Oleg-mk/JLR-MOST-Amp/tube/6n16b/production/README.md

# Bitline, лампова плата 6Н16Б-В: файли для виробництва

Плата та сама, що під 6Н28Б-В: `jlr_tube_6n28b.kicad_pcb` (у репозиторії JLR-MOST-Amp це `tube/6n28b/`, коміт 1d11305; у папці
Bitline `boards/tube-6N28B/`). Gerber, свердління і CPL збігаються з її пакетом `production`. Якщо плати вже замовлені там, окремо замовляти не треба.
Відрізняються лише деталі і те, в які отвори йдуть виводи ламп.

Згенеровано скриптом `hw/gen/fab.py`: BOM і схема з `tube/6n16b/`, плата з `tube/6n28b/`. Усі 32 виводи звірено з
контактами плати: кожен потрапляє на свою мережу.

## Файли

| Файл | Для чого |
|---|---|
| `Bitline-tube-6N16B-gerbers.zip` | завантажити на сайт виробника: Gerber усіх шарів + свердління |
| `gerbers/` | те саме розпаковане |
| `Bitline-tube-6N16B-BOM.csv` | перелік деталей у колонках JLCPCB для цього варіанта |
| `Bitline-tube-6N16B-CPL.csv` | координати й повороти для монтажу |
| `Bitline-tube-6N16B-assembly-top.pdf`, `-bottom.pdf` | складальні креслення; на нижньому намальовані лампи 6Н28Б-В, виводи ставити за таблицею нижче |
| `Bitline-tube-6N16B-PTH-drl_map.pdf`, `-NPTH-drl_map.pdf` | карти отворів |
| `Bitline-tube-6N16B-schematic.pdf` | схема цього варіанта |

Поля замовлення плати і решта монтажу, зокрема 3 дроти накалу і дріт по верхній доріжці HEAT, такі самі, як у README пакета 6Н28Б-В.

## Чим відрізняються деталі

| Позначення | 6Н28Б-В | 6Н16Б-В |
|---|---|---|
| V1–V4 | 6Н28Б-В | 6Н16Б-В |
| R23, R45 | 4.7k | 4.02k |
| R27, R49 | 820 | 1k |
| R30, R52 | 680 | 1k |
| R31, R53 | 14.3k | 14k |

Решта 156 деталей ті самі. За BOM 168 деталей, 74 рядки.

Нитки беруть 1.6 А замість 1 А, від 12 В плата бере ~1.6 А замість ~1.2 А. F1, U1, L2, FB1 і дроти накалу ті самі.

## Виводи ламп

У 6Н16Б-В 8 виводів, у 6Н28Б-В 9: екрана немає, той самий набір тріодів і нитка. Плата розкладена під 6Н28Б-В, а номери
виводів у ламп різні, тож **номер виводу не дорівнює номеру отвору**. Кожен вивід іде в отвір своєї функції, за таблицею.
Точка на шовкографії біля лампи позначає вивід 1 лампи 6Н28Б-В і тут не діє.

Лампу кладуть, як на креслені: мітка між виводами 8 і 1 догори, кліпса на тому самому місці. Найдовший вивід ~17.5 мм,
а виводи 6Н16Б-В не коротші за 35 мм. Зайву довжину зрізати.

Виводи перехрещуються, це нормально, їх просто треба розвести:
- на V1 і V3 виводи 5 і 1 (обидва аноди);
- на V2 і V4 виводи 3 і 4: сітка ~100 В і нитка. Ця пара найближча, на неї варто вдягти кембрик.

Координати в таблицях у тій самій системі, що й CPL, тільки y додатний.

**V1**

| Вивід 6Н16Б | Що це | Мережа | Отвір на платі (x, y) |
|---|---|---|---|
| 1 | анод тріода 2 | P_L | 114.54, 96.94 |
| 2 | катод тріода 1 | K1_L | 112.00, 90.59 |
| 3 | сітка тріода 1 | G1_L | 117.54, 91.86 |
| 4 | нитка | GND | 117.54, 94.40 |
| 5 | анод тріода 1 | A_L | 112.00, 93.13 |
| 6 | катод тріода 2 | K2_L | 114.54, 99.48 |
| 7 | сітка тріода 2 | G2_L | 112.00, 95.67 |
| 8 | нитка | HEAT | 117.54, 98.21 |

Вільний отвір: 114.54, 89.32 (GND).

**V2**

| Вивід 6Н16Б | Що це | Мережа | Отвір на платі (x, y) |
|---|---|---|---|
| 1 | анод тріода 2 | B+L | 111.96, 76.33 |
| 2 | катод тріода 1 | OH_L | 111.96, 73.79 |
| 3 | сітка тріода 1 | GH_L | 114.50, 75.06 |
| 4 | нитка | HEAT | 114.50, 72.52 |
| 5 | анод тріода 1 | B+L | 114.50, 80.14 |
| 6 | катод тріода 2 | OC_L | 114.50, 82.68 |
| 7 | сітка тріода 2 | GC_L | 111.96, 78.87 |
| 8 | нитка | GND | 117.50, 77.60 |

Вільний отвір: 111.96, 81.41 (GND).

**V3**

| Вивід 6Н16Б | Що це | Мережа | Отвір на платі (x, y) |
|---|---|---|---|
| 1 | анод тріода 2 | P_R | 170.00, 96.94 |
| 2 | катод тріода 1 | K1_R | 167.46, 90.59 |
| 3 | сітка тріода 1 | G1_R | 173.00, 91.86 |
| 4 | нитка | GND | 173.00, 94.40 |
| 5 | анод тріода 1 | A_R | 167.46, 93.13 |
| 6 | катод тріода 2 | K2_R | 170.00, 99.48 |
| 7 | сітка тріода 2 | G2_R | 167.46, 95.67 |
| 8 | нитка | HEAT | 173.00, 98.21 |

Вільний отвір: 170.00, 89.32 (GND).

**V4**

| Вивід 6Н16Б | Що це | Мережа | Отвір на платі (x, y) |
|---|---|---|---|
| 1 | анод тріода 2 | B+R | 167.42, 76.33 |
| 2 | катод тріода 1 | OH_R | 167.42, 73.79 |
| 3 | сітка тріода 1 | GH_R | 169.96, 75.06 |
| 4 | нитка | HEAT | 169.96, 72.52 |
| 5 | анод тріода 1 | B+R | 169.96, 80.14 |
| 6 | катод тріода 2 | OC_R | 169.96, 82.68 |
| 7 | сітка тріода 2 | GC_R | 167.42, 78.87 |
| 8 | нитка | GND | 172.96, 77.60 |

Вільний отвір: 167.42, 81.41 (GND).

## Як перегенерувати

У репозиторії JLR-MOST-Amp, з теки `hw/gen`, Python із KiCad 10:

    C:\Users\geniy\AppData\Local\Programs\KiCad\10.0\bin\python.exe fab.py ..\..\tube\6n16b tube-6N16B ..\..\tube\6n28b\jlr_tube_6n28b.kicad_pcb

Скрипт перезаписує все в `tube/6n16b/production`, крім README. Після будь-якої зміни плати перегенерувати обидва пакети.
