Oleg-mk/JLR-MOST-Amp/tube/6n28b/production/README.md

# Bitline, лампова плата 6Н28Б-В: файли для виробництва

Згенеровано з плати `jlr_tube_6n28b.kicad_pcb` у теці вище (у репозиторії JLR-MOST-Amp це `tube/6n28b/`, коміт 1d11305) скриптом `hw/gen/fab.py`. DRC: 0 помилок по міді, 0 розбіжностей зі схемою, 3 нерозведені:
це дроти накалу, див. «Монтаж». Шовкографія чиста: 0 накладань, 0 написів на контактах. Позначення 12 деталей не вміщаються і сховані: C6, C8–C12, R3,
R4, R8, R9, R11, U1; на складальному кресленні вони є.

Та сама плата йде під 6Н16Б-В: інші лише лампи й 8 резисторів, таблиця виводів у README пакета 6Н16Б-В
(`tube/6n16b/production` у репозиторії, `boards/tube-6N16B/production` у папці Bitline).

## Файли

| Файл | Для чого |
|---|---|
| `Bitline-tube-6N28B-gerbers.zip` | завантажити на сайт виробника: Gerber усіх шарів + свердління |
| `gerbers/` | те саме розпаковане: F/B Cu, Mask, Paste, Silkscreen, Edge.Cuts, `PTH.drl`, `NPTH.drl`, `job.gbrjob` |
| `Bitline-tube-6N28B-BOM.csv` | перелік деталей у колонках JLCPCB: Comment, Designator, Footprint, Quantity, LCSC Part # |
| `Bitline-tube-6N28B-CPL.csv` | координати й повороти для монтажу (Designator, Mid X, Mid Y, Layer, Rotation) |
| `Bitline-tube-6N28B-assembly-top.pdf`, `-bottom.pdf` | складальні креслення; низ у дзеркалі, як дивитися на нижній бік |
| `Bitline-tube-6N28B-PTH-drl_map.pdf`, `-NPTH-drl_map.pdf` | карти отворів |
| `Bitline-tube-6N28B-schematic.pdf` | схема |

## Замовлення плати (поля форми JLCPCB)

- Шари: 2. Розмір: 120.18 × 90.0 мм. Одна плата, без панелі.
- Товщина 1.6 мм, мідь 1 oz (35 мкм).
- Найтонша доріжка 0.2 мм, найменший зазор 0.15 мм. Навколо B+ зазори 1.25 мм, окремо замовляти нічого не треба.
- Переходи 0.6/0.3 мм, 94 шт. Ще 6 відкритих отворів 1.8/1.0 мм під дроти накалу. Найменший отвір 0.3 мм.
- Пазів немає. Отвори без металізації: 4 × 2.7 мм для кріплення (H1–H4) і 4 × 1.6 мм, фіксатори J5 і J6.
- Маска й шовкографія з обох боків, колір на смак.
- Покриття: ENIG. Краще за HASL для U1 (WQFN, найвужчий контакт 0.2 мм), U3 (WSON 2×2 мм) і U2 (MSOP, крок 0.5 мм).
- Номер замовлення: вибрати «Remove order number» або погодитися на місце, яке вибере JLC.

## Монтаж

- За BOM 168 деталей, 78 рядків.
- SMD: 139, усі зверху (F). Знизу SMD немає, вистачить однобічного монтажу.
- Вивідні деталі, 25 шт.:
  - зверху: C20, C29, C31–C33, C35, C36, C42, C44–C46, C48, C49, C60, J2, J5–J8;
  - знизу: J1 і J3 (гнізда під штирі основної плати), V1–V4 (лампи).
- MP1–MP4: кліпси Keystone 3566 для ламп, ставляться знизу. Вони є в BOM, але не в CPL: їхні отвори входять у посадкові
  місця ламп.
- **Дроти накалу, 3 шт.** Дріт Ø0.8 мм з боку фольги (B), у відкриті отвори Ø1.0 мм. Без них розжарення не працює:
  - (116.865, 142.265) – (116.865, 109.271), 33.0 мм;
  - (120.193, 101.498) – (120.244, 71.917), 29.6 мм;
  - (122.022, 101.498) – (175.209, 101.498), 53.2 мм.
- **Верхня доріжка HEAT.** Маска відкрита на всю ширину 0.8 мм, від виводу V2.3 до V4.3. Пряма частина: y 71.35, x від 115.67
  до 168.80, 53.1 мм. Сюди можна пропаяти дріт Ø0.8 мм зверху (F).
- Кріпильні отвори H1–H4 із масою не з'єднані: це стійки M2.5 × 11 до основної плати. Маса лампової приходить через J1 і J3.
- B+ до ~211 В. Після пайки відмити флюс.
- Колонка «LCSC Part #» порожня. Її заповнюють при підборі деталей у JLC, або деталі постачають самі.
- Перевірити, чи є в наявності:
  - U1 LM65625-Q1, U2 LM5022-Q1, U5 TPS1H200A-Q1;
  - Q1 IPD60R600P7, Q2–Q5 DN2540N8;
  - L1 KOHERelec NRSE8040-100M, L2 CENKER CKCSA4020-2.2uH/M, L3 Sumida CDRH129RNP-330MC;
  - F1 Littelfuse 0452003;
  - C35, C36, C48, C49 4.7 мкФ 250 В MKS4;
  - J2 Molex 43045-0221, J5 і J6 Neutrik NC3MAH, J7 і J8 BKL 0101153;
  - MP1–MP4 Keystone 3566, V1–V4 6Н28Б-В.
- Координати в CPL абсолютні, від того самого нуля, що й Gerber. Повороти перевірити в попередньому перегляді JLC,
  особливо в полярних деталях: мікросхеми, електроліти, діоди.

## Як перегенерувати

У репозиторії JLR-MOST-Amp, з теки `hw/gen`, Python із KiCad 10:

    C:\Users\geniy\AppData\Local\Programs\KiCad\10.0\bin\python.exe fab.py ..\..\tube\6n28b tube-6N28B

Скрипт перезаписує все в `tube/6n28b/production`, крім README.
