Oleg-mk/JLR-MOST-Amp/docs/block_diagram.md

# Bitline: блок-схема

Блоки пристрою і зв'язки між ними. Що пристрій робить і навіщо, описано в `concept.md`.

Блок-схема: сигнали й живлення

## Блоки

**FOT.** TE 1-1394640-1: роз'єм MOST 2+0 з приймачем і передавачем. Штекер кільця машини вставляється прямо в нього.
STATUS приймача = 0, коли є світло (DS8104AFP4, рис. 20-2).

**OS8104A**
- Після скидання сам пропускає кільце (All-Bypass). Світло йде далі, поки стартує ESP32.
- Дає такти всьому пристрою: FSY 48 кГц, SCK 64Fs = 3.072 МГц, RMCK 256Fs = 12.288 МГц. Звук іде тільки на тактах
  кільця. Кварц OS8104A — 12.288 МГц.
- Приймачі віддає двома лініями, по 8 байтів за кадр на 64Fs. SX1 — стерео: 16 біт угорі кожного 32-бітового слота.
  SX3 — три моно по 16 біт: слот L — моно 0 і 1, слот R — моно 2. Відлік 16 біт — два канали кільця, старший перший,
  як у usb2most. Основний приймач AUD3 теж стерео 16 біт; 6 каналів має лише його приймач відео, з них іде стерео.
- S/PDIF формує сам на SX0 з потоку, який ESP32 подає на SR1. У потоці: звук 24 біти, біти V, U, C і ознака початку
  блоку. Окремий передавач не потрібен. Даташит DS8104AFP4, розд. 7.4.

**ESP32-WROVER-IE**
- Для ГУ відповідає як штатний підсилювач через OS8104A: I2C, INT і RESET. На Connect прописує маршрути приймачів на
  SX1 і SX3.
- I2S0 приймає SX1 і віддає на SR1 потік для S/PDIF. I2S1 приймає SX3 і віддає DOUT на PCM5122 і HDMI.
- Усі чотири секції I2S ведуть FSY і SCK OS8104A. Вільних I2S не лишається.
- Телефон: Bluetooth A2DP, AirPlay. Звук телефона переводиться програмно на такт кільця.
- Керує по I2C PCM5122. Вмикає REM і світлодіод, тримає живлення, читає перемикач. Про втрату світла дізнається від
  OS8104A, тож вихід STATUS до ESP32 не заведено і сплячий модуль через нього не підживлюється.

**Виходи**
- PCM5122 бере RMCK як SCK, тож його PLL не потрібен. Вихід 2.1 Vrms іде прямо на RCA.
- TOSLINK-передавач підключено прямо до SX0. Коаксіал — через буфер, 0.5 В на 75 Ом.
- I2S на HDMI, розпіновка PS Audio: DATA, BCK, LRCK, MCLK через LVDS-драйвер DS90LV047A, тож кабель не
  навантажує такти PCM5122. Контакт 19 — земля, як у PS Audio; в Audio-gd це вхід автоввімкнення.

**REM.** Ключ +12 В із захистом від замикання. Вмикає ESP32.

**Перемикач і світлодіод.** Перемикач має положення для типів підсилювача й «зчитати номер». Світлодіод підказує
правильний вибір і показує, що номер зчитано.

**Живлення**
- +12 В постійні з роз'єму штатного підсилювача, на вході захист і LC-фільтр.
- У сні живі тільки черговий LDO з мікроамперним споживанням і FOT RX.
- Світло з FOT RX вмикає buck і аналоговий LDO.
- Світло може зникнути й без команди вимкнення, наприклад коли ГУ перезавантажується. Тому ESP32 тримає живлення
  (HOLD), поки вимкне REM і приглушить ЦАП.
- Buck 3.3 В, від 1 А: Espressif радить для ESP32 джерело від 0.5 А.
  - Частота від 2 МГц, тобто вище СВ-діапазону радіо.
  - Працює від ~4 В на вході, тож переживає пуск двигуна, зокрема стоп-старт.
- PCM5122 живиться від окремого LDO.

**Корпус і антена.** Корпус металевий, як у штатного. Гармоніки тактів кільця потрапляють у FM: 8 × 12.288 =
98.304 МГц. Антена Bluetooth і Wi-Fi виноситься назовні через U.FL. Маса з корпусом з'єднана через отвір H2 основної
плати у кута J1/J9. Лампова плата отримує масу через J9, її кріпильні отвори ізольовані.

**Прошивка.** Перша — через USB-C (міст CH340C на UART0). Оновлення — по Wi-Fi. Той самий USB дає журнал: міст
живиться від USB, тож COM-порт не зникає, коли плата засинає й прокидається.

**Кнопка SW2.** На столі без кільця вмикає плату (WAKE_FORCE), далі живлення тримає HOLD. Прошивка через USB без
кільця перезапускає ESP32 і відпускає HOLD, тому на час запису кнопку тримають.

## Відкрите

- Де в потоці на SR1 OS8104A бере ознаку початку блоку S/PDIF. Уточнюється за розд. 7.4 і 12 даташиту при написанні
  прошивки.
