Oleg-mk/JLR-MOST-Amp/docs/board_check/check.md

# Звірка основної плати з даташитами

5 листопада 2026. Дві основні плати (2- і 4-шарова): схема одна. Плата ще не виготовлена, тому це звірка документів, а не
вимірювання.

DRC і `hw/gen/checknet.py` порівнюють плату лише з моїм задумом (`gen/intent.json`), і хибний вивід вони пропускають. Тому
зроблено так:

- знімок плати скриптом прямо з `jlr_most_amp.kicad_pcb`: деталі, пади, кола, без пояснень;
- три помічники окремо, без схем, `intent.json` і документації: живлення, виходи, ESP32 і USB. Звіти без змін:
  `report_power.md`, `report_outputs.md`, `report_host.md`;
- усе, що вони знайшли з наслідками, я перевірив по першоджерелах сам. Частина їхніх сумнівів при цьому знята.

## Проти чого

| Деталі | Еталон |
|---|---|
| U1 OS8104A, J2 оптика | схема usb2most `hardware-v3` (робочий продукт), DS8104AFP4, TE 108-94198 і 114-18997, MOST oPhy App Note |
| U2 | ESP32-WROVER-E/IE v2.4, ESP32 Series v5.3; карта виводів проти `fw/main/board.h` |
| U3, U9 | PCM512x SLAS763, TPS7B81-Q1 |
| U5 | PLT133/T10W Rev.5, PLT133 Rev.2, PLT237/T10WH, Cliff FCR684205T |
| U6, J7 | DS90LV047A SNLS044, SN65LVDS047 SLLS416; розпіновка PS Audio зі сторінок `Bitline-info/web/pages` 029 і 073 |
| U7, U8, U10 | TPS7B81-Q1, LM656x5-Q1, TPS1H200A-Q1 |
| J4-J6 | креслення BKL 0101153 (без легенди), картка Bürklin |
| U4, U11, U12, U13, Q1-Q3, D1-D3 | **лише символи KiCad**: даташитів на ПК немає. Вивід за виводом збігається, решта їхніх параметрів не звірена |

Кожне посадкове місце на платі збігається зі своїм файлом бібліотеки (скрипт), а виводи корпусів порівняні з кресленнями.

## Результат

Неправильних виводів, дзеркальних посадкових місць, перевернутих діодів і перевищених напруг не знайдено на U1-U4, U6-U13,
Q1-Q3, D1-D3, J2, J7, J10, SW1, SW2, D20. Дефекти нижче.

Усі чотири виправлено 5 листопада на слово користувача, пакети перегенеровано. Після правок: DRC 0 помилок на всіх платах,
0 нерозведених (на ламповій ті самі 3 дроти накалу), 0 розбіжностей зі схемою, `checknet` без розбіжностей, ERC ті самі 3
попередження. Порівняння з попереднім комітом показує лише зміни, описані нижче.

### Було необхідно до замовлення

**1. U5 TOSLINK підключено дзеркально.**

- Дивлячись на оптичний порт, зліва направо: Vin, Vcc, GND. Так у трьох документах: PLT133/T10W Rev.5 с. 4 (рисунок «Optical
  Output Side»; нумерований вид там знизу, бо на ньому кінчики виводів, а маркування «PLT T10» на верхній грані видно на фото
  PLT237 с. 1), PLT133 Rev.2 с. 2, Cliff FCR684205T с. 3.
- У посадковому місці порт дивиться на +y, тож пад 1 (x −2.54) зліва, він має бути Vin. На платі: пад 1 GND, пад 3 SPDIF.
- Наслідок за документом: світла немає в жодному стані. Висновок: вхідний захист модуля тримає лінію S/PDIF біля падіння на
  діоді, тож коаксіал теж мертвий, а SX0 перевантажений. ЦАП і HDMI не зачіпає.
- Причина моя: 19 жовтня я прочитав рисунок «Using Method» як вид згори й вирішив, що номери у символі правильні, а у Codex
  переплутані. Правий був Codex. Номери символу (1 GND, 3 Vin) від Rev.2, а номери падів від T10W (1 Vin, 3 GND).
- Правка на обох платах: у символі 1 Vin, 2 Vcc, 3 GND; пад 1 SPDIF, пад 3 GND. U4.2 стояв упритул під падом 3 (0.09 мм), тому U5
  зсунуто на 0.37 мм уздовж краю до J10 (між корпусами 0.95 мм, зони безпеки торкаються). C43 тепер між падами Vcc і GND, (112.68,
  140.13). SPDIF іде через пад 1, униз повз пади 2 і 3 на x 110.41 і над U4.1 у U4.2, на цій діагоналі 0.2 мм із зазорами 0.17 мм.
  Перехід GND біля пада 3 прибрано, U4.1 тепер на масі через C41.2. На 4-шаровій перехід +3V3 зсунуто на 0.02 мм уздовж своєї
  діагоналі. Довжина SPDIF: 40.25 → 39.81 мм (2L), 40.94 → 39.81 мм (4L); переходів на один менше.

**2. Зовнішній контакт RCA, швидше за все, не під'єднаний (J4, J5, J6, а на ламповій J7, J8).**

- Масу подано на товсті ніжки (пад 2), тонкий вивід збоку осі (пад 3) вільний. На кресленні BKL легенди немає, але тонкий
  вивід 9 виходить із кільця зовнішнього контакту, а товсті ніжки з пластикового корпусу. У Bürklin такий самий червоний
  0101154 записаний як 2-полюсний: тобто центр і один зовнішній контакт, ніжки механічні.
- Наслідок, якщо ніжки не з'єднані з контактом: у RCA L, R і коаксіала немає зворотного дроту, хіба що через гвинтову частину й
  корпус.
- Правка: пад 3 на GND (на основних через заливку, без нової міді), на ламповій на RCAS_L і RCAS_R (доріжка 5.1 мм на F.Cu до
  ніжки). Вона безпечна в будь-якому разі. Остаточно це покаже продзвонка зразка.

### Зроблено разом із цим

**3. D2 SM6T24A починає проводити нижче за 24 В.** VRM 20.5 В, VBR 22.8-25.2 В, 33.2 В при 18 А (таблиця ST у копіях, сам PDF ST не
відкривався). Пуск від 24 В дасть до ~1.8 А через D2, тобто ~40 Вт постійно: згорить D2 або F1, і плата замовкне. Усе за D2
витримує більше: U7, U9 45 В (200 мс), U10 42 В (< 400 мс), конденсатори 50 В, U8 65 В. SM6T30A: VRM 25.6 В, VBR 28.5-31.5 В, 41.5 В
при 14.5 А, ті самі пади SMB. Замінено на основних платах і на ламповій; на її +12 В конденсатори 50 В, LM65625 65 В, TPS1H200A 42 В. У LCSC ST SM6T30A: C110904.

**4. Чотири ніжки екрана J2 у неметалізованих отворах.** App Note oPhy с. 8 вимагає припаяти екран до маси, usb2most металізує ці
отвори на GND (свердло 1.0, пад 1.2). У нас 1.1 мм без міді, екран на масі лише через дві передні ніжки. Правка: свердло 1.0, пад 1.3
на GND, на обох основних платах; DRC пройшов без зсуву доріжок.

### Перед заповненням колонки LCSC

- C53 від 16 В (LM656x5 8.2.2.7), C54 10 В X7R (7.3.6).
- C55, C56 мають лишати від 4.7 мкФ при 16 В (8.2.2.6): X7R 50 В у 1210.
- C20, C58, C59: у BOM не вказані напруга й діелектрик; треба 20 мкФ ефективних на виході.
- F1: у BOM немає напруги, узяти з більшою.
- L1 NRSE6028 на падах SRN6028: креслення на ПК немає, звірити за сторінкою LCSC. J1: те саме.

Для Bitline Lite заповнено 6 листопада, усі номери в `hw/gen/lite.py`:

- C53: C14663, 50 В. C54 разом із C14, C22 в одному рядку BOM: YAGEO C106248, 16 В X7R.
- C55, C56: Samsung CL32B106KBJNNNE (C138687), X7R 50 В у 1210.
- C20, C58, C59: Samsung CL31A226KAHNNNE (C12891), 22 мкФ 25 В X5R, три штуки на +3V3.
- F1: Littelfuse 043701.5WR (C151112), 63 В замість 32 В у SART S1206-S-1.5A.
- L1: у даташиті KOHERelec виводи 1.55 × 4.8 мм із проміжком 2.9 мм, вони лягають на наші пади 1.6 × 5.7 мм із проміжком 3.1 мм. J1 звірити лишається.
- Y1: Yajin TXM12.288M0004322FBCDO00T (C362472), CL 12 пФ, ESR 60 Ом, −40…+85 °C. Abracon C596906 не підійшов: ESR 80 Ом і CL 18 пФ при C11, C12 по 18 пФ, а DS8104AFP4 табл. 20-1 рекомендує CL 12–22 пФ і ESR до 40 Ом, де CL рахується послідовно по обох ногах разом із монтажем.

## На першій платі

Це не помилки схеми, а те, що покаже тільки живий зразок.

| Що | Як побачимо | Що тоді |
|---|---|---|
| RS OS8104A піднімається повільно: R12 + C14 дають ~5 мс/В, а DS8104AFP4 с. 167 просить для цифрових входів 8 нс/В; в usb2most конденсатора немає | три спалахи, нестабільний старт | зняти C14, GPIO13 у push-pull у прошивці. Кільце тоді пропускатиме світло лише після старту ESP32 |
| CH340C підживлюється від TXD0 через R63, коли USB немає (до 0.57 мА, USB_3V3 до ~2.7 В) | поміряти USB_3V3, U11.13, U11.14, EN без USB | зняти R62, R63 на платі для машини |
| ROM ESP32 може видавати сигнал на GPIO5, 14, 15 (сторонні таблиці, в Espressif цього немає), а U1.12 і U1.36 у цей час тримають нуль | осцилограф на старті | вирішити за результатом |
| EN не встигає розрядитись при швидкому повторному вмиканні: R20 + C22, 88 мкФ на +3V3 | зняти HOLD, розбудити з різними затримками | вирішити за результатом |
| USB під'єднано раніше за 12 В: C22 заряджений через Q2 (тільки на столі) | USB, потім 12 В, потім SW2 | порядок на столі |
| Струм сну: за документами ~37 мкА (U7 4.5, приймач до 30, U8 0.85, U9 1, U10 0.5) | поміряти | |
| Нагрів L2: даних про втрати CENKER на 2.2 МГц немає | температура під навантаженням | Coilcraft XGL4030 стає на ті самі пади |
| Y1: ESR 60 Ом проти рекомендованих 40 (DS8104AFP4 табл. 20-1); у корпусі 3225 від −40 °C кращого в JLC немає | старт кварца на холоді, запас за резистором послідовно (розд. 20.1) | інша серія кварца |
| F1 043701.5WR у каталозі не позначений як T, плавлення 0.324 А²с; кидок при вмиканні за моєю оцінкою ~0.03 А²с | багато вмикань на 14 В | інший запобіжник |
| GPIO6 PCM5122 вільний: внутрішній підтяжки в нього немає (PCM512x с. 6) | шум, зайвий струм | зробити виходом у прошивці |

## Знято

- Полярність HDMI: помічник сумнівався з пам'яті. Сторінки 029 і 073 дають PS Audio: 1/3 DATA−/+, 4/6 BCK+/−, 7/9 LRCK−/+, 10/12
  MCLK+/−, 19 GND. Плата збігається.
- Карта ESP32: кожен GPIO з `fw/main/board.h` на тому самому колі. Адреси I2C: AD0 = AD1 = 1 дає 0x23, ADR1 = ADR2 = 0 дає 0x4C,
  як у прошивці.
- SW1: клавіші 1, 2, 3, SN на шовкографії йдуть на MODE3, 2, 1, 0, як читає прошивка.
- U1 і J2 проти usb2most: виводи збігаються; відмінності свідомі (адреса I2C, кварц 12.288 проти 18.432 МГц, обидва в таблиці 9-5,
  використані RMCK і SX3).
- R4 15 кОм: TE гарантує потужність при 13.5 кОм, але в usb2most 33k‖33k = 16.5 кОм працює в машинах. Лишаємо.
- U8 з двома падами 7: так у TI, L-подібні кутові виводи.
- GPIO13 розряджає 1 мкФ без резистора: прошивка ставить мінімальну силу виходу, відкритий стік.
- Приймач оптики в сні: дані в темряві низькі (AAR THM с. 24), а вхід RX OS8104A допускає 5 В і без живлення (DS8104AFP4, додаток).
- Паста на теплових падах менша за приклади TI (U8 58 % проти 85 %, U10 64.5 %, U7 і U9 65 %): на наших струмах не критично.
- P1 і P2 у звіті ESP32 (плата вимикається при скиданні без світла, журнал ROM вимкнено) відомі й описані в `docs/block_diagram.md` і
  `docs/firmware.md`.

## Не перевірено

Лампова плата, крім RCA і D2. Механіка J1, J10, SW1, SW2 (немає креслень). Сам PLT133 і BKL живцем: для них є прості перевірки вище.
