Oleg-mk/JLR-MOST-Amp/ref/usb2most/README.md

# usb2most — довідкові файли

Звідки: github.com/smartgauges/usb2most (гілка master), автор SmartGauges, ліцензія GPL-3.0. Завантажено 2026-11-01
з дозволу власника проєкту — для витягу таблиць штатних підсилювачів JLR (профілі, етап 8). Лише читаються як дані,
нічого з них не запускається.

| Файл | Байтів | git blob SHA-1 (як на GitHub) | Що це |
|---|---|---|---|
| `fw/main-v24.bin` | 194 284 | 9476f389ec6a92e057c6a6e51cd694ead21624e1 | прошивка адаптера, остання версія |
| `android/msg.h` | 11 130 | 50d151fb5c8a23037788c56e51a9f397e3b90779 | повідомлення між адаптером і застосунком |
| `LICENSE` | 35 149 | f288702d2fa16d3cdf0035b15a9fcbc552cd88e7 | GNU GPL v3, ліцензія репозиторію |

`fw/main-v24.bin` у git не лежить: це чужий бінарник під GPL, джерела до нього — у репозиторії usb2most. Щоб
`fw/tools/host/golden.py` звірив `fw/main/u2m_golden.h`, файл треба взяти звідти й покласти сюди, у `fw/`; SHA-1 вище
підтверджує, що це той самий. Без нього `run.py` пише, що заголовок не звірено, і йде далі.

Що з них узято й де, — у `docs/stock_amps.md` (джерело U2M-FW) і в коментарях профілів у `fw/main/amp.c`.

`msg.h` перелічує типи підсилювачів, якими адаптер уміє бути: `lr2_hi`, `lr2_premium`, `aud3_8`, `aud3_12`,
`aud3_16`, `lr3_hi`, `lr3_premium`; машини — від Freelander 2 2007MY до XJ 2010MY.
