Oleg-mk/JLR-MOST-Amp/docs/concept.md

# Bitline: концепція

Пристрій стає на місце штатного підсилювача JLR MOST25 будь-якого покоління: дорестайлових Hi-Line і Premium,
AUD3-8, -12 і -16. Тип обирає користувач. Пристрій бере звук з кільця, застосовує до цифрового сигналу штатні команди
регулювання без погіршення якості й віддає звук на зовнішні пристрої. Друге джерело — телефон.

## Входи

- **Кільце MOST.** OS8104A веде кільце й канал керування. Канали, які ГУ під'єднує до підсилювача, він віддає як I2S
  разом із тактами FSY, SCK і RMCK.
- **Телефон.**
  - По Bluetooth A2DP — будь-який телефон і будь-який застосунок.
  - По Wi-Fi: AirPlay без втрат з iPhone.
  - Одночасно грає одне джерело.

## Обробка

Модуль ESP32-WROVER-IE: класичний Bluetooth, Wi-Fi, PSRAM під буфер AirPlay, роз'єм зовнішньої антени. Він робить
таке:

- **Для ГУ видає себе за обраний штатний підсилювач:** його FBlock, інстанцію, список функцій і серійний номер. Тип
  задає перемикач.
- **Зводить у стерео** всі приймачі, які ГУ під'єднує до підсилювача, як штатний.
- **Застосовує команди ГУ:** рівні й гучність, Bass, Treble, Balance, Mute з плавністю з MuteParameters.
  Гучність ГУ працює й на зовнішньому підсилювачі.
- **Не псує сигнал.**
  - Рахує в 32-бітовій арифметиці.
  - На нейтральних налаштуваннях пропускає звук біт у біт.
  - Вихід 24-бітовий, тож приглушення 16-бітового джерела аж до −48 дБ не втрачає жодного біта.
- **Музика з телефона займає місце музики ГУ.** На ГУ вибране тихе джерело, наприклад AUX.
  - Кожну команду, яку ГУ дає своїй музиці (рівень, Mute, плавність), пристрій застосовує й до телефона.
    Навігація, дзвінок, парктронік і службові сигнали приглушують музику з телефона так само, як штатну.
  - Звук телефона переводиться програмно на такт кільця. Тракт з кільця лишається біт у біт.

## Серійний номер

У машинах з увімкненим захисним кодуванням ГУ перевіряє серійний номер підсилювача. З чужим номером звук зникає за
20–40 с або при наступній зміні джерела. Тому пристрій віддає ГУ номер штатного підсилювача цієї машини.

1. Перемикач ставлять у положення «зчитати номер».
2. Пристрій вмикають у кільце через оптичний перехідник-петлю між штекером машини й штатним підсилювачем і вмикають
   аудіосистему.
3. Пристрій зчитує номер штатного підсилювача й зберігає у своїй пам'яті. Що номер зчитано, показує світлодіод.
4. Штатний підсилювач знімають, перемикач ставлять на тип.

Нових деталей не треба. У машинах без захисту цей крок пропускають.

## Такти

Усі виходи працюють на тактах кільця від OS8104A. Власних звукових генераторів немає.

## Виходи

Усі виходи беруть той самий оброблений потік.

- **Лінійний вихід:** PCM5122, 2.1 Vrms відносно землі, прямо з її виводів, без операційного підсилювача.
- **PCM-потік:** I2S з MCLK на HDMI для зовнішнього ЦАП: LVDS, розпіновка PS Audio.
- **S/PDIF:** формує сам OS8104A з обробленого потоку, далі TOSLINK і коаксіал 0.5 В на 75 Ом.

## REM

+12 В через ключ із захистом від замикання. Сигнал іде не від самого світла в кільці, бо кільце може світитися й без
звуку.
- Вмикається, коли ГУ під'єднала звук до підсилювача: після старту ЦАП, до зняття глушіння.
- Вимикається першим, ще до вимкнення ЦАП.

## Живлення

+12 В з роз'єму штатного підсилювача. У сні живий тільки приймач FOT, решта прокидається від світла.

## Чого пристрій не робить

- Фейдер не працює: усі виходи стерео.
- Треки з телефона перемикаються на телефоні: кнопки керма йдуть до ГУ, а не до підсилювача.
- Дзвінки йдуть через штатний Bluetooth машини. До пристрою телефон підключається тільки для музики.
- З Android пристрій по Wi-Fi не грає: увесь звук з Android іде по Bluetooth. Spotify Connect прибрано 2026-10-31:
  - відкрита реалізація (cspot) робить прошивку GPL-3.0 і тягне бібліотеку bell, що не має ліцензії;
  - з березня 2026 вона вимагає від кожного власника свого застосунку на developer.spotify.com.

## Відкрите

- Яким запитом ГУ читає серійний номер підсилювача.
- Решта відкритих питань щодо штатних підсилювачів — у `stock_amps.md`, розд. 8. На схему вони не впливають, бо
  вирішуються в прошивці.
