Oleg-mk/JLR-MOST-Amp/docs/firmware.md

# Bitline: план прошивки

Що робить пристрій, описано в `concept.md`, з'єднання блоків — у `block_diagram.md`, що відомо про штатні підсилювачі —
у `stock_amps.md`. Тут — як прошивка ESP32 це виконує і в якому порядку пишеться.

## Основа

- ESP-IDF v5.5.6, мова C, проєкт у теці `fw/`. Модуль ESP32-WROVER-IE-N16R8: 16 МБ flash, 8 МБ PSRAM, з яких ESP32
  відображає 4 МБ; решта доступна лише через himem. Буфери телефона й перетворювача частоти рахуємо на 4 МБ.
- Після зміни `sdkconfig.defaults` треба видалити `fw/sdkconfig` і зібрати знову: наявний sdkconfig має пріоритет.
- Ядро 1 — звук: I2S і обробка, одна задача з найвищим пріоритетом (20). Bluetooth і Wi-Fi ESP-IDF ставить на ядро 0.
  Задачі MOST (переривання OS8104A, емуляція, її журнал, живлення) до ядра не прив'язані, звук витісняє їх пріоритетом.
  Переривання OS8104A (8) і емуляція (7) стоять вище за задачі AirPlay (5, 6): відповіді ГУ перед пакетами телефона.
- Сторожовий таймер задач перезапускає пристрій (`CONFIG_ESP_TASK_WDT_PANIC=y`). Він стежить за задачами звуку,
  переривання OS8104A, емуляції й живлення; такий перезапуск іде в лічильник аварій (розд. «Сон»). У QEMU таймер лише
  пише в журнал.
- Перша прошивка — через USB-C J10 (CH340C, перезапуск у завантажувач від DTR/RTS); на столі без кільця на час запису
  тримати SW2. Оновлення — по Wi-Fi (OTA).
- Сторонні бібліотеки: безкоштовні відкриті беремо, перевіривши ліцензію кожної; платні не беремо, а пишемо своє.
- Bluetooth A2DP — кодек SBC, як дає ESP-IDF.

## Виводи ESP32

| Сигнал | GPIO | Куди |
|---|---|---|
| BCK, LRCK | IO15, IO4 | вхід: такти кільця від OS8104A для обох I2S |
| MOST_SX1 → I2S0 RX | IO14 | приймачі з кільця |
| SPDIF_SRC ← I2S0 TX | IO12 | потік на SR1 OS8104A, з нього S/PDIF |
| MOST_SX3 → I2S1 RX | IO5 | приймачі з кільця |
| DOUT ← I2S1 TX | IO2 | PCM5122 і HDMI |
| I2C0 SDA, SCL | IO26, IO27 | OS8104A, адреса 0x23 (0x46/0x47) |
| MOST_INT, MOST_RST | IO25, IO13 | переривання й скидання OS8104A |
| I2C1 SDA, SCL | IO21, IO19 | PCM5122, адреса 0x4C |
| HOLD, REM_EN | IO33, IO32 | утримання живлення, REM |
| MODE0…MODE3 | IO36, IO39, IO34, IO35 | перемикач: MODE0 — «зчитати номер», MODE1–3 — тип |
| LED | IO22 | світлодіод |

Сила виходів: 0..1 для DOUT і SPDIF_SRC, 0 для решти — повільніші фронти, менше випромінювання.

## Модулі

- **Живлення.** На старті одразу HOLD = 1. Сон — за командою ShutDown від майстра мережі або коли світло зникло й не
  повернулося: плавне глушіння, REM вимк., глушіння ЦАП, HOLD = 0. Програмне перезавантаження (паніка, abort) скидає
  лише процесор, тож HOLD лишається 1 і без світла цикл аварій тримав би живлення вічно: лічильник аварій поспіль у
  RTC-пам'яті (`esp_reset_reason()`), після N паніки HOLD не вмикати. Апаратне скидання (EN, brown-out, RTC WDT)
  відпускає вивід, R51 тягне HOLD до нуля, живлення без світла вимикається саме. Світло ESP32 бачить лише через I2C:
  якщо OS8104A у кільці машини 30 с не відповідає, стан світла невідомий, і йде та сама послідовність сну, а через
  20 с — перезапуск зі скиданням мікросхеми (розд. «Сон»).
- **OS8104A.** Скидання, вихід з All-Bypass, коли ESP32 готовий. Прийом і передача повідомлень керування. Логічна
  адреса вузла й FBlock — за профілем. На Connect — маршрути приймачів на SX1 і SX3. Після скидання FSY і SCK у нього
  входи: bSDC1.IO = 1 треба записати після переривання ввімкнення, але до захоплення кільця (DS8104AFP4, розд. 7.2);
  до того ESP32 тримає BCK і LRCK на своїх підтяжках до землі.
- **Емуляція підсилювача.** Профіль на тип: FBlock, інстанція, адреса вузла, список функцій, серійний номер. Відповіді
  на FBlockIDs, FktIDs, Notification; виконання Connect, DisConnect, Mute, MuteParameters, SpeakerLevel, Bass,
  Treble, Balance і власних 0xE0x.
- **Звуковий рушій.** Обидва I2S — підлеглі тактам кільця, слоти по 32 біти. Розбір кадру за форматом кожного
  приймача, зведення приймача 1 (стерео) і моно-приймачів 2–4, рівні, глушіння з плавністю, тембр, баланс.
  32-бітова арифметика; на нейтральних налаштуваннях звук проходить біт у біт; вихід 24 біти.
- **S/PDIF.** Потік на SR1 з бітами V, U, C і ознакою початку блоку.
- **ЦАП.** PCM5122: SCK = RMCK 12.288 МГц, PLL вимкнений, глушіння регістром.
- **Телефон.** A2DP і AirPlay (RAOP, ALAC без втрат); грає одне джерело. Звук телефона переводиться
  на такт кільця програмним перетворювачем частоти, темп якого підлаштовується за заповненням буфера. Цей звук
  займає місце приймача 1 і проходить ті самі рівні, глушіння й приглушення, що й музика ГУ.
- **Перемикач і світлодіод.** Тип, «зчитати номер», підказки, «номер зчитано». Світлодіод: короткий спалах раз на
  секунду — працює; швидке блимання — читає номер; горить — номер зчитано; два спалахи на секунду — не зчитано; три
  спалахи поспіль — OS8104A не стартував (цей код перекриває решту).
- **Пам'ять і журнал.** NVS — налаштування: мережа телефона, пароль точки налаштування, спарювання Bluetooth.
  Зчитаний штатний підсилювач із серійним номером — в окремому розділі NVS `amp` (`partitions.csv`): стирання
  основного NVS, коли його формат застарів, його не чіпає. Журнал — у UART.

## Драйвер OS8104A

`fw/main/os8104.c`, за DS8104AFP4. Консоль: `most reset | master | slave [вузол група] | st | loop | rd | wr`,
повідомлення — розд. «Журнал кільця й емуляція». Коли вузол — підлеглий у кільці машини, `most reset`, `master`,
`loop` і `check on` без слова `force` у кінці відмовляють: вони вибили б кільце машини. Після `most reset`, `master`,
`slave` і `check off` емуляція забуває маршрути приймачів, канали джерела й підписки, як їх забув чип.

- I2C 200 кГц: вище OS8104A може розтягувати SCL на кожному байті (розд. 18.5.7).
- Скидання: RS у нулі 5 мс. Після відпускання C14 заряджається через R12, і RS піднімається приблизно за 12 мс. Далі
  ESP32 чекає спаду INT (переривання ввімкнення) до 100 мс, одразу пише bSDC1.IO, читає версію (C4h–C6h) і знімає
  переривання (bMSGC.RERR). Вузол лишається в All-Bypass.
- Ведучий на стенді (розд. 16.2): bXCR = E2h з обходом Legacy. З обходом Enhanced ведучий до захоплення лише
  пропускав би RX на TX, і петля не запустилася б. Frequency Regulator вимкнений, бо він для підлеглих.
  bCM1 = 12h: PLL від кварцу 12.288 МГц, RMCK 12.288 МГц для PCM5122. bXSR2.DFE увімкнений, bSDC1 = D7h (режим 5:
  порти 1–3 — I2S, порт 0 — S/PDIF; FSY і SCK — виходи; SR1/SX1 не прозорі), bSDC3 = 0, bXSR = 50h, bSBC = 8 квадлетів.
- Підлеглий у машині (розд. 16.3): bCM1 = 12h, Frequency Regulator тримає такт від кварцу, поки немає RX; після
  захоплення кварц регулятора вимикає сам чип (bCM3.ACD, розд. 9.5). bXCR = 42h з обходом Enhanced замість 62h з
  даташита: без захоплення RX іде на TX, а за табл. 6-10 це той самий активний вузол. Перевірка — етап 2.
- Втрата захоплення, що триває, маскується (bXSR.MXL, розд. 6.2.4) і знову вмикається після захоплення, інакше
  переривання ERR ішли б без кінця. Світло (bCM2) задача живлення читає кожні 100 мс: події INT бачать його лише на
  фронтах, бо ALC приходить зі зміною розміру чи затримки кільця, а не з кожним захопленням (розд. 6.2.8).
- Майстер на стенді після захоплення знімає всі виділення каналів (De-Allocate All): таблиця починається чистою.
- Таблиця маршрутів (MRT) при SCK 64Fs: байт k входу SRn — MRA 40h + 8k + n, байт k виходу SXn — комірка 47h + 8k − n.
  Байти 0–3 — лівий канал, 4–7 — правий. Петля стенда (`most loop`): SR1 → байти кадру 0–7 → RX → SX1 і SX3.
- S/PDIF на SX0 (розд. 7.4.5, рис. 7-7, 7-8). На кожен підкадр SX0 бере три байти 24-бітного звуку — молодший, середній,
  старший — і байт з V, U, C, P у бітах 0–3; у бітах 4–7 цього байта лежить наступна преамбула. Маршрут однаковий для
  ведучого й підлеглого: старші 24 біти кожного 32-бітового слота SR1 → SX0 (байти SR1 2, 1, 0 → SX0 0, 1, 2 і 6, 5,
  4 → 4, 5, 6). Байти V U C — з MRA F8h, тобто 000. Парність і преамбули OS8104A додає сам, усі біти C — нулі.
- Комірки SX0 узяті за розд. 12 (47h + 8k). На рис. 7-8 вони підписані так само, як адреси SR0 (40h + 8k). Якщо на стенді
  S/PDIF мовчатиме, перевірити варіант з рис. 7-8.

## Звук на стенді

`fw/main/audio.c`, `fw/main/pcm5122.c`. Консоль: `tone [Гц] [дБFS] | tone off`, `i2s`, `dac | dac mute 1|0`.

- I2S0 і I2S1 — підлеглі на спільних BCK (IO15) і LRCK (IO4), слоти по 32 біти, формат Philips. Власний такт
  контролера — 16×BCK (мінімум 8): тоді вихід TX іде за фронтом BCK приблизно через 20 нс.
- Одна задача на ядрі 1 читає обидва RX (SX1, SX3) і пише обидва TX: DOUT (PCM5122 і HDMI) і SR1 (розд. «Звук з
  кільця (етап 4)», «Рушій»). Тестовий тон іде в обидва TX, піки RX рахуються.
- Не встигла задача — TX шле нулі, а не повторює старий блок DMA (`auto_clear_after_cb`). Переривання I2S працює й
  під час запису flash (NVS, OTA): `CONFIG_I2S_ISR_IRAM_SAFE`. Сама задача звуку на час стирання сектора стоїть
  разом із кешем flash на обох ядрах (десятки мс, а в DMA 16 мс), тож оновлення спершу закриває вихідний гейт
  (`dsp_gate`, розд. «Оновлення по Wi-Fi»); запис у NVS стирає сторінку лише тоді, коли вона заповнилась.
- PCM5122: PLL вимкнений, бо SCK = 256Fs на 48 кГц ЦАП бере напряму (SLAS763C, табл. 32). I2S 32 біти, гучність 0 дБ,
  рівні рахує ESP32. Глушіння — регістром 3 з плавним спадом, XSMT тримає R31.
- Перевірка «біт у біт» (`check on [ring|direct] | off`, `check`). У SR1 іде 32-бітовий LFSR (x^32 + x^22 + x^2 + x + 1):
  лівий канал s, правий ~s, один крок на кадр. Повертається він із SX1 і SX3 через кільце (світло з TX на RX) або
  всередині OS8104A. Кожен прийнятий кадр має бути наступним кроком попереднього, тож затримку шукати не треба. Збитий
  біт, втрачений кадр і переставлені канали — це помилки. Рахунок починається після двох кадрів підряд, що відповідають
  послідовності. На час перевірки DOUT мовчить, а S/PDIF заглушений: послідовність звучить як шум на повну гучність.

## Журнал кільця й емуляція (етапи 2–3)

`fw/main/most.c`, `amp.c`, `selftest.c`. Консоль: `most log 1|0`, `most send DST FB INST FKT OP [байти]`,
`amp [st] | on | off | test`.

- **Буфери OS8104A** (DS8104AFP4, розд. 13). Прийом mRCMB A0h–B3h: bRTYP, адреса відправника, 17 байтів. Передача
  mXCMB C0h–D4h: пріоритет, тип, адреса цілі, 17 байтів, далі bMSGC.STX і очікування MTX з bXTS. Прийнятий буфер
  звільняється RBE одразу після читання.
- **Поля.** FBlockID, InstID, FktID (12 бітів) з OPType (4), TelID (4) з TelLen (4), 12 байтів даних. Довгі
  повідомлення йдуть сегментами з лічильником у першому байті даних: TelID 1, 2, 3. Так їх пакують JLR-HU і SocketMost.
  Сегменти збираються окремо для кожного відправника, до 4 водночас. Запит, який не вдалося зібрати, отримує Error
  [0Ch, код] (MOST 2.5, 2.3.11.1.1): 01 — немає першого сегмента, 02 — задовгий, 03 — сегмент не за лічильником,
  04 — забагато відправників водночас, 07 — новий початок до кінця попереднього.
- **Журнал (етап 2).** Кожне прийняте й надіслане повідомлення — один рядок у UART. Рядки йдуть через чергу на 64 рядки
  (PSRAM) у задачу з найнижчим пріоритетом: UART на 115200 бод — ~6 мс на рядок, а відповіді ГУ чекати не можуть.
  Переповнена черга губить рядки й пише, скільки загубила. Емуляція стартує сама разом з кільцем (розд. «Звук з кільця
  (етап 4)», «Автостарт»); `amp off` її вимикає, а журнал лишається.
- **Емуляція (етап 3, каркас).** Кожна функція звірена з кодом usb2most: `docs/usb2most/check_amp.md`. Джерела, у такому
  порядку:
  - байти на шині — код usb2most, який працює в машинах як ці підсилювачі (`docs/usb2most/decode_*.md`);
  - поведінка вузла в мережі JLR — робочий вузол JLR-HU (`FBlocks.ts`, `common.ts`, `findings/startUpFlow.json`);
  - правила відповідей, яких usb2most не показує, — специфікація MOST 2.5;
  - формати функцій — каталоги FBlock AudioAmplifier 2V4-3 і GeneralFBlock 2.5.1 (stock_amps.md, розд. 3).

  Що вузол відповідає:
  - NetBlock FBlockIDs 000h Get від майстра → Status з усіма FBlock профілю (розд. «Профілі») тому, хто питав, з його
    FBlock, InstID і FktID. DeviceInfo 001h → `FF FF 00`, NodePositionAddress 002h → `40`, позиція, NodeAddress 003h,
    GroupAddress 004h → `03 22`, ShutDown Query → Result `[00]`.
  - FktIDs 000h Get → список функцій за MOST 2.5, розд. 2.3.9: FktID, на яких біт наявності міняється (розд.
    «Профілі», «Виправлено в етапі 3»). 19 функцій Premium займають 32 байти, три сегменти. Де список usb2most не такий,
    як виходить за правилом, віддаються його байти: Hi-Line 22.02 і Diagnosis, Diagnosis AUD3. Зчитаний підсилювач теж
    відповідає своїм списком як є.
  - Notification 001h Set [керування, адреса, до 4 FktID]. Керування: 0 — усі функції, 1 — перелічені, 2 — зняти все,
    3 — зняти перелічені.
    - Підписаний одразу отримує поточні значення, де вони є.
    - Функції, на які підписатися не можна, проходять мовчки: ГУ на старті підписується і на функції поза списком
      (0C01h, 0353h), а usb2most на них не відповідає. Таблиця підписок повна — на «усі функції» Error [20h, 21h]
      (MOST 2.5, с. 104).
    - AUD3: на D00h приходить Status `01 00 02 00 06 00 01`; на E10h у Diagnosis — порожній Status.
    - «Зняти перелічені» з того, хто підписаний на всі функції, лишає йому окремі підписки на решту властивостей
      (с. 103).
    - Get [FktID] → Status [FktID, адреси підписників].
    - Сповіщення, яке не дійшло, бо цілі немає (bXTS 00h), викреслює ціль з таблиці.
    - Майстер оголосив мережу NotOK (NetworkMaster A00h Status [00h]) — таблиця стирається, а підписка в шлюзі
      вважається втраченою й повторюється після наступного OK (с. 105).
  - NotificationCheck 002h Get [адреса] → Status [адреса, функції, на які вона тут підписана] (GFB 2.5, 2.1.3).
  - Connect 111h StartResult [приймач, SrcDelay, канали] → Result [приймач]; DisConnect так само. Канали від 0 до 59, у
    порядку байтів відліку, не обов'язково за зростанням: usb2most сам дає підсилювачу `c+1 c c+5 c+4`. Усі FFh означають
    «без каналів». На приймач, якого немає, теж Result: так usb2most.
  - Mute 113h [приймач, стан]: приймач 0 — усі, біт 0 — глушіння. Сповіщення — Status [приймач, стан] на кожен
    приймач, що змінився, і на Mute [0, …] теж (GFB 2.5, 2.1.29).
  - MuteParameters 466h [рядок, час глушіння, час зняття, форма глушіння, форма зняття]. Часи в мс, по 2 байти. Рядок 0 —
    усі рядки; рядок понад 4 або інша довжина проходять мовчки.
  - SpeakerLevel 46Dh [рядок, динамік, рівні в дБ]. Байт 0 — рядок, 1..4, байт 1 — динамік, 0 означає всі. `[r, 0, рівні]`
    задає рядок r: 5 рівнів у дорестайлу, 7 в AUD3. `[0, 0, рівні]` задає всі рядки підряд, 4 x 5 або 4 x 7. На Set відповіді
    немає. Get `[r, 0]` → `[00 00, рядок]`, номер рядка не повертається; Get `[0, 0]` → `[00 00, усі рядки]`; інший Pos —
    порожній Status; інша довжина — Error `06`. Рядок, який ГУ не задавала, має −99 дБ у відповіді, а на звук не діє.
    Рівень понад 0 дБ приймається, на виході він 0 дБ. Динаміки за номерами: 1 передній лівий, 2 центр, 3 передній правий,
    4 задній лівий, 5 задній правий, 6 і 7 стійки (розд. «Обробка звуку», «Баланс»).
  - Рядки й приймачі. У дорестайлу рядок r — це приймач r. В AUD3 інакше: рядок 1 — приймачі 1 і 2 (основний, відео),
    2 — приймач 4 (дзвінок), 3 — приймач 7 (навігація, висновок), 4 — приймач 6 (радар).
  - Bass 202h, Treble 203h — один байт зі знаком. Increment і Decrement на NSteps відповідають Status і зупиняються
    на ±6.
  - Масиви 427h, 430h, 431h, 441h, 461h зберігаються як прийшли, окремо для кожного FBlock і значення Pos (перших
    двох байтів), до 128 записів.
  - E04h, E05h, E07h, E08h — власні функції JLR, зі стартовими значеннями usb2most. Set лише повної довжини, інше проходить
    мовчки; E08h ще й половинами `[1|2, 0, 7 байтів]`, а решта — Error `06`. Get `[0, 0]` віддає таблицю, перші два байти в
    нулях; інший Pos — порожній Status; інша довжина — Error `06`. AUD3: E05h на 3 байти `[x, x, режим]` → D00h Status
    `режим 00 02 00 06 00 01`, де 5 і 7 стають 4, а 0Dh — 2.
  - Приймаються мовчки, хоч їх немає у списку: E09h на основному FBlock дорестайлу, E53h на AUD3.
  - Помилки — за MOST 2.5, табл. 2-5. У 04h іде OPType, у 06h і 07h — номер параметра та його значення. Невідомий FBlock і
    функція поза списком — Error. AudioAmplifier з чужою InstID — мовчки: usb2most так само, а його старт шле 22.20 на AUD3.
    Diagnosis і HeadphoneAmplifier приймаються під будь-якою InstID: той самий старт питає 06.0A.
  - На групові й широкомовні повідомлення помилкою не відповідаємо. На Status, Result і Error вузол не відповідає
    ніколи.
  - Коли майстер оголосив мережу готовою (NetworkMaster A00h Status [01h]), підсилювач звертається до F5.01 того, хто це
    надіслав: дорестайл — Notification 303h; AUD3 — 305h Get `26 28 24`, Notification 200h, Notification 303h, окремими
    повідомленнями. Відповіді лише в журналі.
- **Ще не відомо, покаже перша плата в кільці** (`docs/usb2most/check_amp.md`, кінець):
  - що шлюз шле у 303h;
  - власний діапазон Bass і Treble підсилювача;
  - що означають поля E04h–E08h;
  - рядок 3 AUD3.

  Маршрути каналів Connect на SX1 і SX3 — розд. «Звук з кільця (етап 4)».
- **Самоперевірка** (`amp test` після `amp off`, бо тест скидає емуляцію; або при старті у варіанті для QEMU, розд.
  «Телефон»). Вона прокручує старт мережі з `startUpFlow.json`, адресований підсилювачу, і звіряє кожну відповідь байт у
  байт. Еталон — байти самого usb2most: `fw/tools/host/golden.py` читає їх із `main-v24.bin` у `fw/main/u2m_golden.h`, а
  `run.py` щоразу звіряє заголовок із бінарником. Перевіряються:
  - буфери й сегменти;
  - приклад FktIDs зі специфікації, списки функцій усіх FBlock трьох профілів, розбір списків не за зростанням;
  - NetBlock, підписка, Notification;
  - Mute, MuteParameters, SpeakerLevel, E04h–E08h, Bass, Connect, DisConnect;
  - рядки SpeakerLevel: рядок телефона чи парктроніка не чіпає музику; повідомлення гучності точно такі, як їх шле usb2most;
  - D19h, D22h;
  - весь старт ГУ з драйвера usb2most (метод +40): Premium, Hi-Line, AUD3 — відповіді там, де вони в нього є, і тиша на решту;
  - помилки з ErrorInfo і мовчання на групові й широкомовні повідомлення;
  - NotOK і повторна підписка, NotificationCheck, «зняти перелічені» після «усі функції», сповіщення Mute по
    приймачах;
  - сегменти двох відправників упереміш і Segmentation Error.

  `fw/tools/host/mutate.py` по черзі повертає старі дефекти в копію `amp.c` і показує, що самоперевірка їх ловить.

## Телефон: A2DP і перетворення частоти (етап 6, перша частина)

`fw/main/a2dp.c`, `phone.c`, `src.c`. Консоль: `phone` (стан потоку), `phone test` (самоперевірка).

- **A2DP.** Bluetooth Classic, приймач A2DP, SBC декодує сам стек ESP-IDF. Пристрій видно як «Bitline»;
  спарювання Secure Simple Pairing без екрана й кнопок, тому новим телефонам пристрій видно лише в перші 10 хв після
  старту і поки жоден телефон не під'єднаний; спарений телефон підключається будь-коли. Частоту потоку (44.1 або
  48 кГц) дає конфігурація кодека. Ще не запускався: потрібна плата.
- **Буфер.** 8192 кадри 16-бітового стерео у внутрішній пам'яті, 186 мс на 44.1 кГц. A2DP пише в нього пачками,
  звуковий рушій забирає кадри на такті кільця. Буфер береться з купи: зі стеком Bluetooth у статичних даних DRAM
  лишається 26 КБ (прошивка 901 КБ). Коли буфер спорожнів (обрив потоку), останній кадр сходить до нуля за 2 мс, а не
  обривається стрибком.
- **Перетворення частоти.** Інтерполяція windowed-sinc на 40 відліків із вікном Кайзера. Коефіцієнти задані кубічними
  шматками по 1/32 кадру, тож відношення частот може мінятися від кадру до кадру. Смуга до 20 кГц рівна. Дзеркала й
  накладення, що падають нижче 20 кГц, придушені приблизно на 100 дБ; ті, що падають вище, проходять частково. Запас
  −3 дБ на виході: інтерполяція може перевищити повну шкалу запису.
- **Підлаштування темпу.** Ціль — 100 мс у буфері. Заповнення двічі згладжується з постійною 2 с. Далі
  ПІ-регулятор на 0.01 Гц, критично задемпфований, поправка обмежена ±1000 ppm.
- **Виміряно в QEMU (самоперевірка):**
  - перетворення 44.1 → 48 кГц і 48 кГц +300 ppm → 48 кГц на 1, 10 і 15 кГц: SNR 96.5–97.6 дБ, тобто на межі
    самого 16-бітового входу (~97 дБ);
  - 330 с у змодельованому часі. Телефон на 300 ppm швидший, пачки по 512 кадрів із розкидом ±10 мс, кожні 10 с
    затримка на 60 мс. Поправка в середньому +300.5 ppm, блукає в межах 172 ppm (0.3 цента), між блоками змінюється
    не більше ніж на 0.37 ppm. Заповнення в середньому 100.0 мс, обривів немає.
- **Віртуальна модель.** У QEMU немає ні Bluetooth, ні I2S, тому обидва кінці тракту — телефон і кільце — замінює
  скрипт на ПК. Він під'єднується до прошивки через емульований Ethernet (`fw/main/vphone.c`). Запуск:
  1. `idf.py -B build_qemu -DQEMU=1 build` — варіант для QEMU: свій sdkconfig, `sdkconfig.qemu` поверх `sdkconfig.defaults`;
  2. `python fw/tools/vphone.py [--wav ФАЙЛ]`;
  3. `idf.py -B build_qemu qemu`.

  Скрипт моделює обидва такти. Він шле програму (розгортка 20 Гц–20 кГц, акорди, тон 1 кГц) або WAV, пише результат
  у `build_qemu/vphone_out.wav` і грає його на звуковій карті ПК. Перший прогін: 24 с звуку за 5 с, без обривів;
  тон 1 кГц на −9 дБFS має SNR 85 дБ, поки регулятор ще встановлюється (межа 16 біт — 89 дБ).
- **Старт потоку.** У перші секунди поправка підскакує на кілька сотень ppm, у демо до 900 ppm (1.6 цента). Відтворення
  починається, коли буфер уперше досяг цілі, а це вершина пилки від пачок. Не чутно.
- **Гучність телефона** (AVRCP 1.4, абсолютна гучність): телефон задає 0..127, пристрій бере її в діапазоні AirPlay,
  −30…0 дБ, 0 — тиша. Телефон тоді шле звук на повній шкалі, а гучність застосовується тут, у float, замість того щоб
  телефон зрізав біти. Новий телефон починає з повної, доки не скаже свою.
- **Далі:** перевірити A2DP й AVRCP на платі.

## Wi-Fi (етап 6, друга частина)

`fw/main/wifi.c`, `webcfg.c`, `wcred.c`; у QEMU — `wifi_qemu.c`. Консоль: `wifi`, `wifi join МЕРЕЖА [ПАРОЛЬ]`,
`wifi forget`, `wifi setup`.

- **Клієнт точки доступу телефона.** AirPlay потрібна спільна з iPhone мережа. На своїй точці доступу iPhone лишає
  собі інтернет через мобільну мережу.
  Пристрій працює лише на 2.4 ГГц, тож на iPhone 12 і новіших у точці доступу треба ввімкнути «Максимальна
  сумісність». Повторні спроби — через 1, 2, 5, 10, далі кожні 30 с.
- **Точка налаштування «Bitline».** WPA2, пароль за замовчуванням `bitlinesetup`, його можна змінити на сторінці.
  - Вмикається, коли мережу телефона ще не задано, коли задану не знайдено за 3 хв після старту чи після збереження
    на сторінці, або командою `wifi setup`.
  - Вимикається, щойно пристрій підключився до телефона. Якщо її ввімкнули командою — лишається. Точка, що
    піднялась поруч зі збереженою мережею, через 10 хв без жодного телефона на ній вимикається сама: поїздка без
    точки доступу телефона не має тримати її відкритою всю дорогу.
- **Сторінка.** http://192.168.4.1 на точці налаштування або адреса пристрою в мережі телефона.
  - Поля: назва мережі телефона зі списком мереж поруч, пароль, пароль точки налаштування. Кожна зміна — збереження
    мережі, зміна пароля точки, оновлення — потребує теперішнього пароля точки налаштування: сторінку бачить кожен у
    мережі телефона, а сторінка, відкрита звідкись іще в браузері, без пароля нічого не надішле.
  - Стан оновлюється наживо: мережа, IP і сигнал, або чому не вдалося підключитися (мережу не знайдено, пароль не
    підійшов, з'єднання обірвалося).
  - Поки точка налаштування ввімкнена, DNS відповідає її адресою на будь-яке ім'я, а невідомі адреси ведуть на
    сторінку. Тому iPhone відкриває сторінку сам.
- **NVS** тепер ініціалізується на старті. Без неї Bluetooth не зберіг би спарювань, а в коміті етапу 6 цього бракувало.
- **Збій старту Wi-Fi не зупиняє пристрій:** звук і емуляція працюють далі, а в журналі видно, що саме не вдалося.
- **Пам'ять з Bluetooth і Wi-Fi разом:** прошивка 1.47 МБ (розділ вільний на 77%), IRAM 86% (вільно 18.7 КБ), статична
  DRAM 48% (вільно 64 КБ). Що для цього зроблено:
  - код Wi-Fi і lwIP виконується з flash;
  - буфери Wi-Fi і lwIP лежать у PSRAM;
  - холодні буфери (масиви емуляції, самоперевірка, копія в A2DP) позначені `EXT_RAM_BSS_ATTR` і теж лежать у PSRAM.
    ESP-IDF з цим налаштуванням переніс туди й безпечні частини стеків Wi-Fi і Bluetooth.

  Таблиця перетворювача частоти лишилась у внутрішній пам'яті, бо її читають на кожному кадрі.
- **Перевірено в QEMU.** Сторінка працює поверх емульованого Ethernet; порт прокинуто на ПК:
  `idf.py -B build_qemu qemu --qemu-extra-args "-nic user,model=open_eth,hostfwd=tcp::8080-:80"`, сторінка на
  http://localhost:8080. Перевірено:
  - стан наживо;
  - пошук мереж (у QEMU порожній, бо радіо немає);
  - збереження в NVS із читанням назад;
  - кирилиця в назві мережі;
  - екранування в відповіді;
  - відмова на закороткі паролі.

  Саме радіо, точку налаштування й автовідкриття сторінки на телефоні можна перевірити тільки на платі.
- **Далі — AirPlay 1.** mDNS (ім'я пристрою й службу `_raop._tcp`) треба взяти з реєстру компонентів Espressif; це
  окреме завантаження. Зі ввімкненим Bluetooth Wi-Fi мусить працювати з енергозбереженням модему (цього вимагає
  спільне радіо). Це додає затримку, але буфер AirPlay на 2 с її покриває.

## AirPlay (етап 6, третя частина)

`fw/main/raop.c`, `raop_key.c`; декодер ALAC — `fw/components/alac`; mDNS — компонент `espressif/mdns` 1.14.1 з реєстру
Espressif (`fw/main/idf_component.yml`, `fw/dependencies.lock`). Консоль: `airplay`.

- **Що це.** AirPlay 1 (RAOP): ALAC 16 біт / 44.1 кГц, справді без втрат.
- **Знаходження.** mDNS оголошує службу `_raop._tcp` з ім'ям «MAC@Bitline». У записі: ALAC або PCM, шифрування
  RSA або без нього, пароля немає.
- **Сесія — RTSP на TCP 5000:**
  - OPTIONS. На перевірку Apple (Apple-Challenge) — підпис ключем AirPort над перевіркою, нашою адресою й MAC.
  - ANNOUNCE. Параметри ALAC і ключ AES, розгорнутий з RSA-OAEP (SHA-1). Приймається лише 16-бітовий ALAC з кадром
    від 32 до 4096. Потік, що йшов, на цьому зупиняється, новий грає від свого RECORD: декодер ніколи не міняється під
    пакетами. Відхилений ANNOUNCE лишає параметри попереднього потоку.
  - SETUP. Порти UDP: 6000 — звук, 6001 — керування, 6002 — синхронізація.
  - RECORD, SET_PARAMETER (гучність: лише скінченне число в межах −144…0), FLUSH, TEARDOWN.
  - Content-Length не число, від'ємний або понад 1 МБ — сесія закривається. Тіло, довше за буфер, зчитується й
    відкидається: так прийшла б, наприклад, обкладинка.
- **Звук.** RTP, у кожному пакеті AES-128-CBC.
  - Пакети чекають у буфері на 128 пакетів у PSRAM; 24 пакети (190 мс) притримуються на випадок перезапиту.
  - На пропуск один раз іде перезапит. Що так і не прийшло, замінюється пакетом тиші.
  - Далі ALAC → `phone.c`. Одночасно грає одне джерело — те, що почало останнім.
  - Гучність iPhone (від −30 до 0 дБ, −144 — тиша) додається як ослаблення. Для нового джерела вона скидається на 0 дБ.
- **Ключ AirPort Express** — так, як його несе shairport-sync (`common.c`, MIT). Рішення брати його ухвалено 2026-10-31
  з урахуванням юридичної сірої зони.
- **Декодер ALAC** — код Apple; у кожному файлі коду ліцензія Apache 2.0 (файл `APPLE_LICENSE.txt` у тій самій
  теці — старий текст APSL 2.0). Змінено лише `ALACDecoder.cpp`: шість рядків з позначкою `Bitline` відкидають пакет,
  який оголошує кадр довший за кадр потоку (буфери саме такої довжини) або читав би за своїм кінцем; сам декодер
  довіряє вхідним даним. Кадр потоку коротший за 32 не приймається: розгін предиктора пише до 31 відліку, хоч який
  кадр (`dp_dec.c`), а буфери мають довжину кадру. Перемикач порядку байтів у ньому знає малий порядок лише для x86,
  тому `TARGET_RT_LITTLE_ENDIAN` задано в збірці компонента.
- **Затримка — ~290 мс** (190 мс буфер перезапиту + 100 мс буфер телефона) замість звичних для AirPlay 2 с. Відео на
  iPhone розраховане на 2 с, тож картинка відставатиме від звуку на ~1.7 с. У машині це лише музика; якщо треба —
  буфер можна збільшити.
- **Пам'ять:** прошивка 1.54 МБ (розділ вільний на 75%), статична DRAM 59% (вільно 50 КБ), IRAM 86%.
- **Перевірено в QEMU** скриптом `fw/tools/vraop.py`. Він робить те саме, що iPhone, і водночас є кільцем. Запуск:
  1. `python fw/tools/vraop.py` — Python від ESP-IDF, у ньому є бібліотека cryptography;
  2. `idf.py -B build_qemu qemu --qemu-extra-args "-nic user,model=open_eth,hostfwd=tcp::5000-:5000,hostfwd=udp::6000-:6000,hostfwd=udp::6001-:6001"`.

  Результат прогону:
  - підпис Apple-Response звірено відкритою половиною ключа;
  - ключ AES розгорнуто, звук розшифровано й декодовано;
  - 3006 пакетів, кожен 150-й навмисно не відправлено: 20 перезапитів, 20 перевідправлено, втрачених 0, запізнілих 0,
    обривів звуку 0;
  - тон 1 кГц — SNR 91.3 дБ, тобто на межі 16 біт.
- **Не перевірено:**
  - справжній iPhone. Знаходження через mDNS у QEMU не працює: емульований адаптер не має фільтра мультикасту, а мережа
    QEMU мультикаст не пропускає;
  - стиснені кадри ALAC: тест шле нестиснені, декодер Apple читає обидва види;
  - обмін синхронізацією часу.
- **Spotify Connect прибрано** (2026-10-31). Причини:
  - cspot переводить прошивку на GPL-3.0;
  - його бібліотека bell не має ліцензії;
  - з березня 2026 вшиті в cspot ключі клієнта Spotify недійсні, тож кожен власник мав би реєструвати свій застосунок
    Spotify.

  Android грає по Bluetooth.

## Обробка звуку (етап 5)

`fw/main/dsp.c`. Команди ГУ передає емуляція (`amp.c`): Mute, MuteParameters, SpeakerLevel, Bass, Treble. Консоль:
`dsp test` (після `amp off`: тест міняє рівні й тембр).

- **Шлях звуку.**
  - Приймач 1, стерео (музика ГУ або телефон замість неї), проходить Bass і Treble, потім рівень і глушіння.
    Bass — полиця на 100 Гц, Treble — на 10 кГц: відгук RBJ, нахил 1, а рахує їх фільтр зі змінними стану
    (трапецієвидний SVF, Simper). Пряма форма на 100 Гц шумить у float: тест 40 Гц + 1 кГц на Bass +6 дБ дав шум
    −73 дБFS, SVF — −131 дБFS.
  - Приймачі 2–4, моно (телефон, навігація й голос; парктронік; службові сигнали), кожен зі своїм рівнем і
    глушінням, ідуть в обидва канали.
  - Сума — у 32-бітові слоти, з обмеженням на повній шкалі. Перед нею баланс і вихідний гейт.
- **Баланс.** AUD3 (0x200, −10…+10): від'ємне значення зсуває звук праворуч, тобто ослаблює лівий канал, по 2 дБ на
  крок — припущення, доки не почуємо проти штатного. Діє на весь вихід, і на моно-приймачі теж, як у підсилювачі;
  змінюється на 1 дБ за блок. Дорестайл функції Balance не має: ГУ опускає рівні динаміків однієї сторони в
  SpeakerLevel. Порядок динаміків у рядку — fl, c, fr, rl, rr, в AUD3 ще sl, sr: так usb2most складає рівні, коли сам веде
  цей підсилювач (`main-v24.bin` 0x08033088, 0x080330E8, 0x08033778, 0x08036C48 — його `msg_volume_t`); сабвуфер
  іде окремо, E09h на 22.20. Рівень приймача для лівого виходу — найгучніший з лівих динаміків, для правого — з
  правих; −127 дБ, які ГУ надіслало, — це тиша цієї сторони. Сторона, якій ГУ нічого не задавало (моно-приймач з одним
  рівнем), бере найгучніший з усіх; так само обидві, коли обидві сторони тихі (приймач лише в центр). На AUD3 обидва
  виходи беруть найгучніший: баланс там — 0x200, і рівні сторін однакові.
- **Вихідний гейт** — загальне ослаблення після суми: закривається за заданий час (сон — 300 мс, оновлення — 50 мс)
  незалежно від часів MuteParameters, які можуть сягати 60 с; на 1 множить точно, тож нейтраль лишається біт у біт.
- **Рівні** — SpeakerLevel у дБ. Новий рівень приходить за 10 мс і доходить до цілі точно.
- **Глушіння.** Час і форма — з MuteParameters: стрибок; лінійна; дегресивна (спершу швидко); прогресивна (спершу
  повільно). Доки їх немає — 20 мс лінійно.
- **Тембр** змінюється на 1 дБ за блок, тож не клацає. Межа — ±6 кроків, як в емуляції.
- **Арифметика — float.** 16- і 24-бітові відліки float тримає точно, а на нулі тембр вимкнений, тож на нейтралі звук
  проходить біт у біт.
- **Телефон** на платі йде через обробку, приймачі з кільця — теж (розд. «Звук з кільця (етап 4)»).
- **Припущення до журналу з машини або на слух:**
  - порядок динаміків у SpeakerLevel — за usb2most (розд. «Баланс»); у машині перевірити, що баланс іде в той бік;
  - крок Bass і Treble — 2 дБ;
  - рівень приймача, доки ГУ його не задало, — −20 дБ;
  - чи приглушує музику під підказками саме ГУ. Пристрій виконує його команди по кожному приймачу.
- **Перевірено в QEMU.** Самоперевірка — 9 з 9. Прогін `fw/tools/vamp.py` (запуск як у `vphone.py`):
  - рівень −10 дБ вийшов −10.0000 дБ;
  - дегресивне глушіння на 300 мс: після 300 мс лишається 1e-8 повної шкали, тобто лише похибка float;
  - підказка навігації на −6 дБ однакова в обох каналах;
  - після зняття глушіння рівень знову −10.000 дБ;
  - тембр точно за розрахунком: Bass +4 дає +7.47 дБ на 50 Гц, Treble −4 дає −5.84 дБ на 12 кГц, на 1 кГц 0.00;
  - на нейтралі 139 200 кадрів біт у біт.

## Перемикання джерел (етап 6, четверта частина)

`fw/main/music.c`; пауза й відновлення — у `a2dp.c` (AVRCP), `raop.c` (DACP), `phone.c`. Консоль: `phone` — що грає
приймач 1, стан музики ГУ, кого пристрій поставив на паузу.

- **Музика ГУ чи телефон.** Телефон грає на місці музики ГУ, поки приймач 1 тихий: ГУ на AUX або на паузі.
  - Тиша — рівень приймача 1 (RMS за 0.1 с) нижче −60 дБFS довше 2 с. Музика — вище −50 дБFS довше 0.3 с. Між
    порогами стан не міняється. Шум незайнятого AUX набагато нижчий, а музика тихіша за −50 дБFS майже не буває.
  - Перехід між музикою ГУ і телефоном — 30 мс. Поки грає ГУ, його музика проходить біт у біт.
  - Рівні, Mute і плавність ГУ діють і на телефон: обидва йдуть як приймач 1.
- **ГУ заграло — телефон на паузу.** Bluetooth — клавішею Pause по AVRCP; AirPlay — через пульт iPhone (DACP), як його
  власною кнопкою. Телефон, що почав грати, коли ГУ вже грає, теж стає на паузу.
- **ГУ затихло — телефон грає знову,** якщо на паузу його поставив пристрій і перед тим телефон звучав:
  - через 5 с тиші: це довше за паузу між треками диска (2 с) і за перелаштування радіо;
  - через 2 с, якщо ГУ за останні 10 с під'єднало, від'єднало або приглушило й відновило приймач 1. Так ГУ JLR і
    міняє джерело: DisConnect [1], канали новому джерелу, Connect [1, …] (`stock_amps.md`, розд. 4);
  - телефон, який власник поставив на паузу сам, не відновлюється, навіть якщо його потік ще кілька секунд тягнеться
    тишею.
- **Два телефони: грає новіший** — той, хто почав грати останнім. Попередній пристрій ставить на паузу. Новий сеанс
  AirPlay закриває попередній, і той iPhone теж стає на паузу. По Bluetooth під'єднується один телефон.
- **Без клацань.** Перерваний потік сходить до нуля за 2 мс, новий наростає за 10 мс.
- **Хто займає приймач.** Потік Bluetooth — від старту до призупинення; телефон призупиняє його за кілька секунд після
  паузи. Потік AirPlay — з першого пакета після RECORD або FLUSH, а FLUSH (пауза чи перемотка) його звільняє. Гучність
  AirPlay діє лише на потік AirPlay.
- **Знайдено під час перевірки:**
  - 10 сокетів lwIP забракло: пульт iPhone не мав чим під'єднатися («Too many open files»). Тепер 16, сторінці —
    4 з'єднання;
  - фільтр перетворювача частоти рахується ~0.2 с (подвійна точність на ESP32 програмна), і перший пакет AirPlay
    тримав задачу пакетів: вони губилися, звук рвався. Тепер фільтр для тієї ж частоти не перераховується, а черга
    пакетів — 32 замість 6.
- **Перевірено в QEMU** (`fw/tools/vsource.py`, 56 с у реальному часі). Скрипт водночас кільце (AUX, радіо, диск з
  паузою між треками, зміни джерела), віртуальний телефон і iPhone по AirPlay з пультом:
  - що грає приймач 1, щодесятої секунди — усі 14 відрізків як очікувано: ГУ невідоме — тиша; телефон з 2.0 с; радіо
    з 5.3 с; тиша; телефон знову з 16.0 с (5 с тиші); диск; пауза між треками — телефон не вмикається; телефон з
    33.0 с (2 с після зміни джерела); iPhone перебиває телефон з 36.3 с; радіо; iPhone знову з 50.2 с;
  - усі 7 запитів пауза/відтворення вчасно, обидва запити до пульта iPhone отримали 204;
  - клацань немає: найбільший крок між відліками 0.020 повної шкали, а сам тон 880 Гц дає 0.029;
  - музика ГУ — 1 344 000 відліків біт у біт; AirPlay — 0 втрачених пакетів, телефон — 0 обривів.
- **Не перевірено:** AVRCP на справжньому телефоні і пульт справжнього iPhone через mDNS — потрібна плата. У мережі
  QEMU немає multicast, тож там порт пульта заданий: 3689.

## Оновлення по Wi-Fi (етап 8, перша частина)

`fw/main/ota.c`, сторінка — `webcfg.c`. Консоль: `ota` — версія, розділ і стан образу.

- **Як оновити.**
  - Відкрити сторінку пристрою: у мережі телефона — за адресою пристрою, у точці налаштування — 192.168.4.1.
  - У розділі «Оновлення прошивки» вибрати `bitline.bin` зі збірки і ввести пароль точки налаштування.
  - Хід запису видно у відсотках. Пристрій перезапускається сам, сторінка оновлюється за 20 с.
- **Пароль — той самий, що в точки налаштування** (за замовчуванням `bitlinesetup`). Сторінку в мережі телефона бачить
  кожен, хто в цій мережі, тож без пароля прошивку не записати.
- **Перевірка до запису.** Перші байти мають бути образом програми ESP32 саме цього проєкту (`bitline` в описі
  програми). Інакше — відмова, і у flash не пишеться нічого. Контрольну суму й SHA-256 усього образу перевіряє
  `esp_ota_end` до перемикання.
- **Два розділи по 6 МБ, ota_0 і ota_1.** Новий образ пишеться в той, що зараз не працює. Поточний лишається цілим,
  доки новий не підтвердиться. Образ для плати з Bluetooth, Wi-Fi, AirPlay, обробкою й оновленням — 1,56 МБ, чверть
  розділу.
- **На час запису** вихід глушиться (гейт, 50 мс): кожне стирання сектора зупиняє задачу звуку разом із кешем flash,
  і без цього звук рвався б на шматки весь час запису. Якщо запис не вдався, звук повертається; вдалий закінчується
  перезапуском.
- **Пробний запуск.**
  - Новий образ стартує «на пробі» й підтверджує себе, коли сторінка й звуковий рушій стартували, а мережа телефона
    або точка налаштування і задача звуку тримаються 10 с поспіль — перевірка щосекунди, а не один погляд і
    очікування. Сторінка перевіряється лише за результатом старту. Точка налаштування рахується лише після успішних
    викликів Wi-Fi. Відмова `esp_ota_mark_app_valid_cancel_rollback` іде в журнал.
  - Якщо образ падає до підтвердження або за 300 с мережі немає, завантажувач повертає попередній. 300 с покривають
    3 хв до точки налаштування.
  - Якщо з новим образом OS8104A не стартував (три спроби), попередній повертається одразу: такий образ — не
    підсилювач. З несправним чипом не пройде жодне оновлення, але без чипа пристрій у машині й так не працює.
  - PCM5122 — не умова: без нього REM, S/PDIF і HDMI працюють (розд. «Звук з кільця (етап 4)», «REM і ЦАП»), тож
    несправний ЦАП не має заважати оновленню.
- **Світла в кільці не треба** — оновлюють і на столі, без кільця. Там плата сама відпускає живлення через 5 хв без
  світла (розд. «Сон»); для довшої роботи — `most master`.
- **QEMU.** Програмний перезапуск там скидає лише процесори, а периферія працює далі, і наступний старт падає. Тому
  QEMU-збірка перезапускається повним скиданням емульованого чипа (`wifi_qemu.c`), а після аварії зупиняється.
  Перезапуск QEMU з тим самим образом flash (`idf.py qemu --flash-file`) — це вимкнути й увімкнути живлення.
- **Перевірено в QEMU** на образах `-DPROJECT_VER=ota-test-2` і `-DOTA_TEST_CRASH=1` (падає одразу на старті):
  - неправильний пароль — 403; випадкові байти й образ іншого проєкту — відмова, у flash нічого не записано;
  - v2 записалась, пристрій перезапустився, v2 стартувала на пробі й підтвердилась за 11 с;
  - падучий образ записався, стартував і впав. Після вимкнення й увімкнення завантажувач запустив v2, уже
    підтверджену.

## Перший профіль: Jaguar XF X250, дорестайл, 2009

Типи — як розібрано в `concept.md` і `stock_amps.md`, розд. 1: XF 2009 — дорестайл, підсилювач звичайний або преміум,
тобто дорестайлові Hi-Line і Premium, 6H52-18C808-CE і -DE за SDD. Серійний номер на XF на роботу звуку не впливає, тож
етап 7 для нього не потрібен.

За `stock_amps.md`, розд. 2, 5:

- AudioAmplifier 0x22, вузол 0x186: інстанція 0x02 у Hi-Line, 0x05 у Premium. На Premium список JLR-HU бачив на XF: 0x000–0x002,
  0x111, 0x112, 0x113, 0x202, 0x203, 0x427, 0x430, 0x431, 0x441, 0x461, 0x466, 0x46D, 0xE04, 0xE05, 0xE07, 0xE08.
- Майстер мережі й керування звуком — шлюз 0x161, FBlock 0xF0. Екран говорить з тінню підсилювача 0x22.A1 у шлюзі, а
  шлюз перекладає це у функції підсилювача.
- Підсилювач підписується на функцію 0x303 у FBlock 0xF5 шлюзу; зміст не встановлено.
- Приймачі: 1 — музика, стерео; 2 — телефон, навігація, голос; 3 — парктронік; 4 — службові сигнали.

## Профілі (етап 8, друга частина)

`fw/main/amp.c`. Тип задає SW1: клавіша 3 — біт 0, клавіша 2 — біт 1, клавіша 1 — біт 2. 000 — дорестайл Hi-Line,
001 (клавіша 3 ON) — дорестайл Premium, 010 (клавіша 2 ON) — AUD3-8/12/16; решта — як 000. Консоль: `amp` показує
профіль і його FBlock.

- **Звідки дані.** FBlock, їхні функції й номери деталей — з прошивки usb2most (`ref/usb2most`), яка працює в
  машинах як ці підсилювачі. Адреса вузла й підписка на 0x303 — з JLR-HU на XF (`stock_amps.md`, розд. 5).
- **Дорестайл.** Один підсилювач для Jaguar і Land Rover, налаштований під машину файлом сцени.
  - FBlock: основний AudioAmplifier, другий AudioAmplifier 0x22.20, HeadphoneAmplifier 0x23.01, Diagnosis 0x06.86.
  - Основний залежить від типу, а не від марки: Hi-Line 0x22.02 лише з 0xE08, Premium 0x22.05 із 0xE04, 0xE05, 0xE07, 0xE08
    (usb2most `main-v24.bin` 0x080322FC, фото SG1). На XF список Premium бачив JLR-HU. Різні номери деталей: 6H52-18C808-CD
    і -DD.
  - У рядку SpeakerLevel 5 рівнів.
- **AUD3.** FBlock 0x22.0A, 0x06.86, 0x23.01. Замість Mute — Balance і Fader; є Allocate, DeAllocate, 0xD00, 0xD01.
  У рядку SpeakerLevel 7 рівнів. На старті звертається до майстра: 0x305, 0x200, 0x303.
- **Адреса вузла — 0x186 для всіх типів.** У JLR інстанція Diagnosis — молодший байт адреси вузла: у XF підсилювач
  0x186 з Diagnosis 0x86, в usb2most аудіоблок 0x180 з Diagnosis 0x80. У кожному наборі підсилювача Diagnosis — 0x86.
  Режим навчання це перевірить.
- **Diagnosis.** D22 [DID] → [DID, поле значення]: F18C — серійний номер (16 байтів), F112 — номер збірки, F191 —
  апаратна частина, F188 — програма, F124 — калібрування (по 24 байти). Серійний номер — нулі, доки не зчитано номер
  своєї машини (етап 7). D19 (коди несправностей) — п'ять фіксованих відповідей, як в usb2most; решта функцій Diagnosis
  мовчить або відповідає помилкою, теж як у нього (`docs/usb2most/check_amp.md`).
- **Виправлено в етапі 3.**
  - Кодування FktIDs. Список функцій перелічує FktID, де біт міняється, а не кінці серій: приклад у специфікації,
    розд. 2.3.9, «002 004 006 …» означає 000–001, 004–005 (у PDF рядок бітів зсунутий). Відповідь XF тепер байт у
    байт така, як у usb2most.
  - Список FBlock: досі емуляція називала лише 0x22.05.
- **Відкрите:** крок Balance у дБ (узято 2, розд. «Обробка звуку»). Приймачі AUD3 і його джерело (Allocate) закрито в
  етапі 4, D19 — звіркою.
- **Перевірено в QEMU:** самоперевірка емуляції — 62 з 62. Списки функцій — лише проти моїх власних копій із usb2most:
  звірка з бінарником пізніше знайшла, що Diagnosis Hi-Line і AUD3 та весь набір Hi-Line були не такі
  (`docs/usb2most/check_amp.md`). Тепер їх бере `golden.py`.
- **Далі:** режим навчання разом з етапом 7 (наступний розділ).

## Серійний номер і навчання (етап 7)

`fw/main/learn.c`. Консоль: `learn` — що зчитано, `learn forget` — забути.

- **Як зчитати** (`concept.md`, «Серійний номер»).
  1. Клавіша 4 SW1 замкнена.
  2. Пристрій вмикають у кільце через оптичний перехідник-петлю між штекером машини й штатним підсилювачем.
  3. Аудіосистему вмикають.
  4. Світлодіод швидко блимає, доки пристрій читає. Горить постійно — зчитано. Два спалахи на секунду — не вдалося.
  5. Штатний підсилювач знімають, клавішу 4 розмикають.
- **Пристрій у кільці** — звичайний вузол без FBlock: на запит майстра відповідає порожнім списком FBlock (MOST 2.5,
  3.3.4). Адреса до захоплення кільця — 0x0FFE (неініціалізована), далі динамічна 0x100 + позиція, тож з постійними
  адресами JLR вона не перетинається. Емуляція в цьому режимі мовчить.
- **Як знаходить підсилювач.** Перехідник ставить штатний підсилювач одразу після пристрою, тож запит NetBlock
  FBlockIDs іде на позицію +1 (адреса 0x400 + позиція). Якщо там немає AudioAmplifier — на позицію −1. Відповідь дає
  й логічну адресу підсилювача. Мережу пристрій чекає до Configuration OK від майстра або 5 с після захоплення.
- **Що зберігає в NVS** — усе так, як прийшло: адресу вузла, список FBlock, список функцій кожного FBlock, відповіді
  Diagnosis D22 на F18C (серійний номер), F112, F191, F188, F124. Розділ NVS окремий, `amp` (`partitions.csv`,
  0x12000, 56 КБ): основний NVS з мережею й спарюваннями прошивка стирає, коли його формат застарів, і зчитане має
  це пережити. Таблиця розділів змінюється лише прошивкою через USB, не по Wi-Fi.
- **Зчитування не вдалося** (два спалахи на секунду, у NVS нічого не пишеться), якщо поруч немає підсилювача, якийсь
  FBlock не дав списку функцій (до 96 байтів), немає основного AudioAmplifier з приймачами, немає Diagnosis або не
  прийшов серійний номер F18C. Відповідь зараховується, лише коли збігаються FBlock, InstID і функція запиту.
- **На старті зчитане перевіряється:** кількості й довжини в межах, є основний AudioAmplifier. Якщо зіпсоване — запис
  у журнал і профіль типу.
- **Далі емуляція відповідає як цей підсилювач,** байт у байт, хоч би який тип стояв на SW1. Приймачі й підписки в
  шлюзі — за родом зчитаного підсилювача: основний AudioAmplifier з інстанцією 0x0A — AUD3, інший — дорестайл (SW1 на
  AUD3 тоді дає Hi-Line). Основний AudioAmplifier стає першим у списку FBlock; у відомих наборах він і так перший.
- **Перевірено в QEMU** (`fw/tools/vlearn.py`). Скрипт — кільце й штатний підсилювач Hi-Line з наборами usb2most і
  вигаданим серійним номером; SW1 стоїть на Premium:
  - пристрій знайшов підсилювач на позиції 4 (вузол 0x186) і зчитав 4 FBlock, їхні списки функцій (33, 11, 11 і
    38 байтів) та 5 відповідей Diagnosis; майстрові відповів порожнім списком;
  - після цього емуляція віддає NetBlock [22.02 22.20 23.01 06.86], функції 22.02 і Diagnosis — байт у байт, зокрема
    список не за зростанням, серійний номер — зчитаний; на 22.05 (набір, на якому стоїть SW1) — мовчить.
- **На платі перевірити:** чи відповідає штатний підсилювач на запит за позицією, чи не скаржиться ГУ на зайвий вузол,
  скільки триває зчитування.

## Сон (етап 8, третя частина)

`fw/main/power.c`. Консоль: `sleep` — засинання зараз. Схема — розд. «Модулі», «Живлення».

- **Коли засинає.**
  - За NetBlock ShutDown (0x006) Start [02h Execute] від майстра: незворотне, без відповіді. На Query [00h] пристрій
    мовчить: йому більше нічого казати (MOST 2.5, розд. 3.2.5; NetBlock 2.5.1).
  - Коли світло зникло й не повернулося за 5 с: MOST 2.5 радить почекати, бо світло може повернутися
    (tPwrSwitchOffDelay). Про світло каже OS8104A: активність на RX (bCM2), задача живлення читає її кожні 100 мс.
    Діє тільки в режимі вузла машини (`most slave`, режим зчитування); власне кільце стенду (`most master`) плату не
    присипляє.
- **Світла немає від старту.** Підлеглий, що 5 хв не бачить світла, відпускає HOLD: плата не тримає живлення без
  кінця, якщо її розбудив короткий спалах, а кільце не піднялося. Світло з'явилося пізніше — HOLD береться знову. На
  столі без кільця плата вимкнеться через 5 хв, якщо не ввести `most master`.
- **OS8104A не стартував** (три спроби, і в режимі зчитування теж) — HOLD відпускається одразу, світлодіод дає три
  спалахи поспіль.
- **OS8104A замовк.** Світло видно лише через I2C. Якщо в кільці машини мікросхема 30 с не відповідає на опитування,
  стан світла невідомий, і йде та сама послідовність сну: без неї HOLD тримав би живлення на темному кільці, доки не
  сяде акумулятор. Через 20 с після неї — перезапуск зі скиданням мікросхеми; якщо вона й тоді не стартує, автостарт
  відпускає HOLD, і живлення йде за світлом.
- **Як засинає.** Вихідний гейт закривається за 300 мс незалежно від часів MuteParameters (вони сягають 60 с) →
  REM вимк. → 300 мс, поки зовнішній підсилювач вимкнеться → глушіння ЦАП → HOLD = 0. Живлення зникає разом зі
  світлом; HOLD тримає його до кінця послідовності, хоч би коли світло згасло. Якщо через 20 с світло все ще є,
  прошивка стартує заново.
- **Цикл аварій.** Лічильник аварій поспіль у RTC-пам'яті (паніка, сторожові таймери). Після 3 аварій HOLD не
  береться: живлення лишається, лише поки світиться кільце. Вузол тоді не входить у кільце (обхід), щоб прошивка, яка
  падає, не входила в кільце машини знову й знову; мікросхему на старті тоді не скидають, якщо вона вже в обході, бо
  скидання гасить світло для наступного вузла, а цикл перезапусків робив би це щосекунди. Після хвилини без аварій
  лічильник скидається. HOLD береться знову лише тоді, коли вузол у кільці стежить за світлом (`most slave`, режим
  зчитування): без цього живлення не відпустило б ніщо.
- **Перевірено в QEMU** (`fw/tools/vpower.py`; світло й майстра грає скрипт, музика ГУ 440 Гц у реальному часі):
  - світло зникло на 2 с і повернулося — сну немає, музика грає;
  - ShutDown Query — нічого; Execute — тиша за 0.19 с, у журналі REM, ЦАП, HOLD по черзі; через 20 с, світло
    лишилося, — новий старт;
  - після старту світло зникло назовсім — тиша за 5.20 с.
- **На платі:** струм у сні (черговий LDO і FOT RX, мікроампери за схемою) — вимірювання; пробудження світлом.

## Звук з кільця (етап 4)

`fw/main/amp.c`, `audio.c`, `os8104.c`, `power.c`. Консоль: `amp` показує приймачі профілю, їхні канали й джерело.

- **Звідки формат.** З прошивки usb2most (`ref/usb2most`, розібрано дизасемблером):
  - її функція маршрутів OS8104 (main-v24.bin, 0x08023F88) знає лише 4 канали (стерео) і 2 (моно);
  - відлік 16 біт — два канали кільця, старший перший, лівий перед правим;
  - обробник Connect дорестайлу (0x08033F60) веде лише приймач 1 з 4 каналами.
- **AUD3 кодує звук так само.** Його обробник Connect (0x080378C8) веде такі приймачі:
  - 1 — основний, 4 канали, як у дорестайлі;
  - 2 — відео, 6 каналів, з яких usb2most бере перші 4, стерео;
  - 4 — дзвінок, 6 — парктронік, 7 — навігація, по 2 канали;
  - 3 і 5 приймає, але не веде.

  Запис «основний звук AUD3 — 6 байтів» у документах був помилкою: 6 каналів має приймач відео.
- **Маршрути.** На Connect емуляція передає канали приймача в рушій:
  - стерео йде на SX1, 16 біт угорі 32-бітового слота, молодші 16 — нулі;
  - моно йде на SX3 половинами слотів: L — моно 0 і 1, R — моно 2;
  - на DisConnect — нулі. Обидва старти OS8104A ставлять нулі, доки ГУ нічого не під'єднала.
  - маршрут, якого чип не взяв (помилка I2C, запис повторюється раз): приймач лишається вимкненим, рушій його не
    читає, ГУ отримує Error 41h замість Result, і наступний Connect веде його заново. Без цього ГУ чуло б «готово» від
    приймача, який грає старі канали або нічого.

  Основний приймач і приймач відео AUD3 ділять стерео: грає під'єднаний останнім. Коли його від'єднали, а інший ще
  під'єднаний, грає інший.
- **Рушій.** Одна задача бере блок з обох входів і віддає блок на обидва виходи. Усі чотири напрямки йдуть на тих
  самих BCK і LRCK, тож не розходяться. Затримка — 4 мс входу плюс черга виходу.
  - Приймач 1 іде у вибір музики: ГУ чи телефон (`music.c`).
  - Моно-приймачі йдуть в обробку.
  - Тон і перевірка «біт у біт» на стенді лишилися.
- **REM і ЦАП** (`concept.md`, розд. REM).
  - Перший Connect: REM вмик., через 300 мс знімається глушіння ЦАП, тож зовнішній підсилювач прокидається на тиші.
    ЦАП налаштовується одразу після старту кільця; не вдалося (шина чи регістри) — повторюється щосекунди від самого початку;
    після 5 невдач REM вмикається без нього: S/PDIF і HDMI ЦАП не потрібен.
  - 10 с без жодного під'єднаного приймача означає, що звук вимкнено. Зміна джерела — це DisConnect і Connect за
    мить, тож вона REM не вимикає. Тоді REM вимк., через 300 мс глушіння ЦАП.
  - Сон — як і був.
- **AUD3 як джерело.** На Allocate [SourceNr] usb2most бере в майстра кільця 2 канали й нічого в них не шле
  (0x080385DA, 0x080246FC). Тут так само:
  - Resource Allocate до майстра (DS8104AFP4, 13.5.2.4); майстер зайнятий — запит повторюється, до 20 разів;
  - MRT цих каналів не міняється: вони пропускають кільце, тож канали, які вже не наші, ніколи не перезаписуються;
  - відповідь Result [SourceNr, SrcDelay = bNDR, канали].

  Повторний Allocate отримує ті самі канали, поки таблиця виділення чипа (mCRA, сторінка 3, розд. 14.1.1) ще має їх за
  нами; після нового старту майстра — нові. DeAllocate повертає їх майстру (14.3); якщо майстер їх не взяв, вони
  лишаються нашими до наступного Allocate. Немає каналів — Error [20h,
  SourceNr, 2]: виділення не буває частковим (MOST 2.5, с. 184). SourceNr приймається будь-який, як в usb2most.
- **QEMU.** Маршрути, REM і виділення там не діють: звук кільця дає `vamp.py` через `vphone.c`.
- **Перевірено:**
  - збірки для плати й для QEMU — без попереджень;
  - самоперевірка емуляції в QEMU — 80 з 80.

  Нові перевірки: канали на стерео й моно; REM вимикається лише тоді, коли не лишилося жодного приймача; основний і
  відео AUD3; приймач 3 без маршруту; Allocate, DeAllocate, відмова майстра; Allocate після нового старту майстра;
  DeAllocate, якого майстер не прийняв.
- **Ще не перевірено** на стенді й у машині. На стенді: майстер петлі шле свої канали, Connect з консолі веде їх на
  SX1 і SX3.
- **Автостарт.** Звичайний режим SW1 на старті одразу:
  - вмикає емуляцію;
  - стартує OS8104A підлеглим з адресою й групою профілю (0x186, 0x22), до 3 спроб через 100 мс; не стартував —
    HOLD відпускається, живлення йде за світлом, світлодіод дає три спалахи поспіль;
  - вмикає сон за світлом.

  Після циклу аварій (розд. «Сон») автостарту немає: вузол лишається в обході, кільце машини працює без нього.

  Майстер опитує новий вузол одразу після захоплення кільця, тож до цього вже готові обробка й вибір музики: `dsp_init`
  і `music_init` стоять до старту кільця. ЦАП налаштовується одразу після старту, коли такти мікросхеми вже задані,
  задовго до першого Connect. Звуковий рушій (I2S) стартує після Wi-Fi; якщо він не стартував, вузол у кільці
  відповідає, але не грає — це в журналі, і образ на пробі з цим не підтверджується.

  На стенді `most master` забирає чип (без кільця — протягом 5 хв після старту, розд. «Сон»), `amp off` вимикає
  відповіді, журнал іде завжди. Режим зчитування серійного номера стартує, як і був, на 0x0FFE, з тими самими трьома
  спробами. У QEMU кільця немає, автостарту теж.

## Перевірка

Після кожної зміни прошивки проганяється все, по черзі, коли на ПК більше нічого важкого не працює: QEMU йде в
реальному часі й чутливий до навантаження.

- **На ПК, секунди** (`python fw/tools/host/run.py`, компілятор GCC MinGW-w64). Справжні модулі на заглушках апаратури;
  код виходу не нуль, якщо щось не пройшло. У QEMU немає OS8104A, тож гілки, що залежать від його відповідей, там не
  виконуються, і перевіряються вони тут:
  - `golden.py --check` — іде першим: еталонні байти в `fw/main/u2m_golden.h` збігаються з `main-v24.bin`;
  - `test_power` — задача живлення на власному годиннику: сон за ShutDown, за світлом і за мовчанням мікросхеми, REM,
    ЦАП, HOLD; на парних і непарних тіках, біля переповнення лічильника, коли читання I2C перетинає тік;
  - `test_selftest` — самоперевірки прошивки, ті самі, що в QEMU;
  - `test_alac` — декодер ALAC із захисними зонами навколо буферів: відхилені параметри, правильні кадри, сотні тисяч
    зіпсованих пакетів. Читання за кінець пакета він не бачить.
- **Чи самі перевірки чогось варті** (`python fw/tools/host/mutate.py`): повертає в копію `amp.c` старі дефекти по одному, і
  кожен має провалити самоперевірку. Запускається після зміни `amp.c` або `selftest.c`.
- **Проти чого це все:** емуляцію — проти коду й байтів usb2most (`docs/usb2most/check_amp.md`), решту — проти очікувань,
  записаних у самих тестах. Кільця тут немає: що покаже лише перша плата, перелічено наприкінці `check_amp.md`.
- **У QEMU:** `vphone`, `vamp`, `vlearn`, `vpower`, `vraop`, `vsource`, оновлення по Wi-Fi.
- **`vsource` нестабільний:** іде в реальному часі, тож під навантаженням дає обриви потоку й стрибки фази, на старій
  прошивці теж. Судити за ним можна лише за кількома прогонами.
- **На платі:** усе, що торкається справжніх I2C, I2S, радіо й кільця. Цього ні ПК, ні QEMU не показують.

## Порядок робіт

0. **Каркас.** Виводи, HOLD, світлодіод, перемикач, журнал по UART.
1. **Стенд без машини.** Оптична петля FOT TX → RX: OS8104A сам веде кільце й дає такти. Перевірка I2S, PCM5122,
   HDMI і S/PDIF тестовим сигналом.
2. **OS8104A у машині.** Пристрій входить у кільце й пише в журнал усі повідомлення керування, які до нього доходять.
3. **Емуляція XF.** ГУ приймає підсилювач і під'єднує приймач 1.
4. **Звук з кільця на всі виходи біт у біт,** без обробки. REM і порядок увімкнення й глушіння.
5. **Обробка.** Рівні, глушіння, тембр, баланс, моно-приймачі. Перевірка «біт у біт» на нейтралі через S/PDIF.
6. **Телефон.** A2DP і перетворення частоти, далі Wi-Fi, AirPlay, перемикання джерел.
7. **Серійний номер.** Режим зчитування й віддача номера ГУ.
8. **Решта профілів,** OTA, споживання у сні.

## Нотатки для наступних етапів

- Етап 0 був лише стендом: HOLD не відпускався. Тепер сон — розд. «Сон»: світло ESP32 бачить через OS8104A
  (FOT_STATUS іде тільки на Q1).
- Flash DIO 40 МГц і PSRAM 40 МГц — стандарт IDF. Для звукових етапів перейти на QIO 80 МГц і PSRAM 80 МГц разом, після
  `esptool.py flash_id` на реальному модулі.
- GPIO36 і GPIO39 (MODE0, MODE1) дають короткий провал ~80 нс при ввімкненні живлення АЦП або радіо: перемикач читати
  двома вибірками з проміжком ≥ 1 мс, без переривань на цих виводах.
- Журнал ROM-завантажувача на UART мовчить: R16 10 кОм тягне MTDO (GPIO15 = BCK) проти його внутрішньої підтяжки
  вгору до ~0.6 В, тож strapping MTDO = 0. Журнали завантажувача й програми друкуються як звичайно.
- Шифрування flash і NVS (Wi-Fi пароль власника) — рішення перед першим зібраним екземпляром; тоді завантажувач стає
  більшим, і зсув таблиці розділів треба буде перенести.

## Відкрите

Закривається першою платою в кільці (`docs/usb2most/check_amp.md`, кінець):

- зміст підписки на 0xF5.0x303;
- значення полів 0xE04–0xE08 і шкала гучності;
- хто приглушує музику під навігацію й дзвінок — шлюз чи підсилювач.

S/PDIF зі стенда (розд. 7.4 даташита OS8104A):

- Поки біти C — нулі, статус каналу каже «споживчий, PCM, 44.1 кГц», хоча частота 48 кГц. Більшість приймачів дивиться на
  реальну частоту, але це не відповідає IEC 60958 (розд. 7.4.5).
- Щоб ESP32 сам задавав V, U, C, байт V U C береться з молодшого байта слота SR1. Тоді OS8104A має ставити преамбулу
  початку блоку в той кадр, де ESP32 почав блок статусу. Як позначити цей кадр, даташит не пише: це один з бітів 4–7
  байта V U C. Знайти на стенді: по черзі ставити біт у кадрі 0 і дивитися логічним аналізатором, де на SX0 з'являється
  преамбула B.
