Oleg-mk/JLR-MOST-Amp/docs/stock_amps.md

# Штатні підсилювачі JLR MOST25: що бачить ГУ

Що відомо з робочих продуктів про те, як ГУ працює з підсилювачем і що підсилювач відповідає. Ключі джерел — у
таблиці внизу.

## 1. Типи й інстанції

| Тип | Номери | Канали | AudioAmplifier | Джерело |
|---|---|---|---|---|
| Дорестайл Hi-Line | 6H52-18C808-CD, на XF -CE | 8 | 0x02, другий — 0x20 | SG1, SG3, SDD |
| Дорестайл Premium | 6H52-18C808-DD, на XF -DE | 11, другий DSP з Dolby і DTS | 0x05, другий — 0x20 | SG1, U2M-FW, HU, SDD |
| XK X150 | 6W83-18C808-AC | — | — | SDD |
| AUD3-8, -12, -16 (Meridian) | xxxx-19C164-Cx, -Ax, -Bx | 8, 12, 16 (у 16 зайнято 15) | 0x0A (AUD3-12 BJ32-19C164-AF) | SG3 |

- **Покоління.** Шлюз MOST і блок підсилювача змінюються разом: XF MY08–MY11 і XK X150 мають шлюз ICM і AAM_SYSTEM_A_2,
  XF MY12+ і XJ X351 — шлюз FCDIM і AAM_SYSTEM_A_4, тобто AUD3. SDD.

- **Номер 19C164.** Перша літера — рік першої розробки (A — 2010 … F — 2015). Друга — марка: H або J означає Land
  Rover, X або W — Jaguar. Далі — платформа (W93 — XJ X351, X23 — XF X250, H52 — Freelander 2, J32 — Evoque тощо).
  Літера апаратної версії: C — 8 каналів, A — 12, B — 16. SG3.
- **Однаковість на MOST.** Усі AUD3 на MOST виглядають однаково. Налаштування звуку під машину лежить у файлі сцени
  xxxx-14C527, прошитому в підсилювач. SG3.

## 2. Функції

| FktID | Функція | Hi-Line 0x02 | Premium 0x05 | AUD3-12 0x0A |
|---|---|---|---|---|
| 0x000–0x002 | FktIDs, Notification, NotificationCheck | + | + | + |
| 0x101, 0x102 | Allocate, DeAllocate | – | – | + |
| 0x111, 0x112 | Connect, DisConnect | + | + | + |
| 0x113 | Mute | + | + | – |
| 0x200 | Balance | – | – | + |
| 0x202, 0x203 | Bass, Treble | + | + | + |
| 0x204 | Fader | – | – | + |
| 0x427 | LimiterSettings | + | + | – |
| 0x430, 0x431 | Crossover, CrossoverSlope | + | + | – |
| 0x441 | SpeakerDelay | + | + | – |
| 0x461 | EqualizerSettings | + | + | – |
| 0x466 | MuteParameters | + | + | + |
| 0x46D | SpeakerLevel | + | + | + |
| 0xD00, 0xD01 | — | – | – | + |
| 0xE04, 0xE05, 0xE07 | — | – | 0xE04, 0xE05, 0xE07 | 0xE05 |
| 0xE08 | — | + | + | + |
| 0xE09 | — | – | – | + |

- **Інші FBlock вузла.** У Hi-Line це NetBlock 0x01, AudioAmplifier 0x20, HeadphoneAmplifier 0x01 і Diagnosis 0x86.
  В AUD3-12 — HeadphoneAmplifier 0x01 і Diagnosis 0x86. SG1, SG3.
- **Набори usb2most.** Прошивка usb2most, яка працює в машинах як ці підсилювачі, зберігає їхні відповіді. U2M-FW, повний
  розбір і звірка з нашим кодом: `docs/usb2most/`.
  - Дорестайл — два набори, за типом підсилювача, а не за маркою. Hi-Line: 0x22.02, 0x22.20, 0x23.01, 0x06.86, з власних
    функцій основного — лише 0xE08. Premium: 0x22.05 і ті самі три, з 0xE04, 0xE05, 0xE07, 0xE08. Вибір у коді
    0x080322FC. Список Premium бачив HU на XF, 0x02 на Hi-Line видно на фото SG1.
  - Функції інших FBlock дорестайлу: 0x22.20 — 0x000–0x002, 0x427, 0x466, 0xE09; HeadphoneAmplifier — 0x000–0x002,
    0x111–0x113, 0x466, 0xE00; Diagnosis — 0x000–0x002, 0xD10, 0xD11, 0xD14, 0xD19, 0xD22, 0xD27, 0xD2E, 0xD31, 0xD34,
    0xD36, 0xD37, 0xD3E, 0xD85, 0xE10.
  - AUD3: 0x22.0A, 0x06.86, 0x23.01. Два списки основного — з 0xE05 і без нього. HeadphoneAmplifier — 0x000–0x002,
    0x111, 0x112, 0x466, 0xE00, 0xE1C–0xE1E. На Configuration OK тому, хто її надіслав: 0xF5.0x305 Get `26 28 24`, потім
    підписки на 0x200 і 0x303.
  - Список функцій закодовано так, як вимагає специфікація MOST, розд. 2.3.9: перелічено FktID, де наявність
    міняється. Списки Hi-Line і AUD3 в usb2most мають відхилення: нулі в кінці, значення не за зростанням.
- **Адреса вузла.** У JLR інстанція Diagnosis — молодший байт адреси вузла: у XF підсилювач 0x186 з Diagnosis 0x86
  (HU), у usb2most аудіоблок 0x180 з Diagnosis 0x80. Усі набори підсилювача мають Diagnosis 0x86, тож адреса — 0x186.
  Висновок, не запис з машини. U2M-FW, HU.
- **Дорестайл.** Баланс задається через SpeakerLevel окремих динаміків. В AUD3 для цього є Balance і Fader, а
  Crossover, EqualizerSettings і SpeakerDelay прибрано. SG3.
- **Налаштування динаміків у дорестайлі.** SpeakerDelay задає затримку кожного виходу в мікросекундах. ГУ на старті
  заливає EQ і затримки по групах: перед 2 мс, зад 5.6 мс, центр 0.5 мс, стійки 6.4 мс. SG1.

## 3. Приймачі й команди за специфікацією MOST

Підсилювач має кілька приймачів (sinks) і сам їх зводить, а ГУ керує рівнем і глушінням кожного окремо. MOST-AA,
MOST-GFB.

| FktID | Функція | Параметри |
|---|---|---|
| 0x110 | SinkInfo | SinkNr, DataType, Resolution (байтів на відлік), AudioChannels, SinkDelay, ChannelList |
| 0x111 | Connect | StartResult [SinkNr, SrcDelay, ChannelList] → Result [SinkNr] |
| 0x112 | DisConnect | [SinkNr] |
| 0x113 | Mute | [SinkNr, Status]. SinkNr 0 — усі приймачі, біт 0 Status — глушіння |
| 0x466 | MuteParameters | [SinkNr, MuteTimeIn, MuteTimeOut, MuteShapeIn, MuteShapeOut]. Часи — UWord у мс. Форми: 0 стрибок, 1 лінійна, 2 дегресивна, 3 прогресивна |
| 0x46D | SpeakerLevel | Pos {x — приймач, y — динамік}, рівні Signed Byte −127…0 дБ, крок 1 дБ. 0 дБ — максимум, −127 — тиша. {0, 0} — усі приймачі й динаміки; {x, 0} — усі динаміки приймача x. У JLR на шині саме так: `[x, y, дБ…]`, x — рядок 1..4 (розд. нижче). Динаміки в рядку: 1 передній лівий, 2 центр, 3 передній правий, 4 задній лівий, 5 задній правий; в AUD3 ще 6 і 7, стійки лівий і правий. Сабвуфер — не тут, а E09h. Так usb2most приймає й шле (`main-v24.bin` 0x08034140, 0x08037D74, 0x080330E8, 0x08036C48). U2M-FW |
| 0x467 | MixerLevel | по приймачу: InputLevel, Balance, Fader. 0x80 означає «за головним балансом чи фейдером» |
| 0x46B | DynSoundControl | вмикає й вимикає динамічні підстроювання, зокрема гучність від швидкості |
| 0x400 | Volume | 0 — тиша |
| 0x200, 0x204 | Balance, Fader | від'ємне значення зсуває звук праворуч або вперед |

- **Приймачі JLR.**
  - 1 — основне джерело, стерео. На нього ГУ під'єднує музику (розд. 4). HU.
  - 2 — телефон, навігація й голос, моно. MOB.
  - 3 — парктронік, моно. MOB.
  - 4 — службові сигнали, моно. MOB.

  Таблиця моно-приймачів на с. 19 MOB однакова для Land Rover і Jaguar. В інших марок телефон іде на приймач 1.
- **Приймачі AUD3** інші. Обробник Connect usb2most:
  - 1 — основний, 4 канали;
  - 2 — відео, 6 каналів;
  - 4 — дзвінок, 6 — парктронік, 7 — навігація, по 2 канали;
  - 3 і 5 приймає, але не веде.

  U2M-FW.
  SpeakerLevel і MuteParameters нумерують їх інакше, рядками 1..4: 1 основний і відео, 2 дзвінок, 4 радар, 3 лишається
  навігації (висновок). U2M-FW: 0x08037E66–0x08037EAA.
- **Парктронік і службові сигнали приходять звуком.** mObridge грає їх як моно-входи й підстроює їхнє підсилення.
  У нотатках до прошивки mObridge сказано: «6dB boost to all mono channels to address quiet phone, nav, chimes, pdc
  audio». MOB, MOB-RN.
- **Порядок байтів Pos у SpeakerLevel.** Як у специфікації: байт 0 — рядок, байт 1 — динамік, 0 означає всі. Гучність музики —
  `[01 00, рівні]`. Журнал usb2most підписує ці байти «param» і «sink», але його код робить інше: зберігає рядок за байтом 0
  і лише коли байт 1 нульовий. U2M-FW: 0x08034140, 0x08037D74.
- **Гучність.** Volume 0x400 немає в жодному списку функцій підсилювачів JLR (розд. 2). Рівень доходить до
  підсилювача як SpeakerLevel по приймачах і динаміках.

## 4. Звук від ГУ

- **Частота.** Кільця Jaguar і Land Rover працюють на 48 кГц, відліки 16-бітові. SG-U2, U2M, SM.
- **Парктронік у дорестайлі Freelander 2.** Писк формує сама ГУ за даними з MS CAN, тон і тривалість залежать від
  відстані. SG-PDC.
- **Музика.** Основна музика йде на приймач 1 підсилювача. ГУ від'єднує його (DisConnect [1]), виділяє канали
  новому джерелу й під'єднує знову: Connect [1, SrcDelay, номери каналів]. HU.
- **Дорестайл.**
  - Підсилювач приймає лише стерео 16 біт. SG-51.
  - Моно-канали парктроніка й навігації він підмішує сам. SG-U2.
  - Парктронік звучить окремо спереду й ззаду. SG-51.
- **AUD3.** Основний приймач — стерео 16 біт у 4 каналах, як у дорестайлі. 6 каналів має приймач 2, відео: з них
  usb2most бере перші 4, стерео. U2M-FW.
- **Канали.** Відлік 16 біт — два канали кільця, старший перший, лівий перед правим; моно — 2 канали. Інших розмірів
  маршрути usb2most не знають. U2M-FW.
- **Телефон.** Звук телефона йде по MOST від штатного Bluetooth-блока. SG-U2.
- **Розкладка виходів.** На той самий вихід передніх дверей Hi-Line дає низи й середину, а Premium і AUD3-12 — лише
  низи. SG3.

## 5. Керування звуком на XF X250

- **Вузли кільця:** 0x161 — шлюз, 0x180 — аудіоблок, 0x186 — підсилювач, 0x16E — сенсорний екран, 0x168 —
  навігація, 0x190 — Bluetooth, 0x189 — iPod. HU.
- **Шлюз.** Шлюз 0x161 водночас є майстром мережі (NetworkMaster) і керує звуком через FBlock 0xF0, Audio control. HU.
  - **Перемикання джерела.** Чотири методи по черзі:
    - 0x405 — нове джерело: [0x00, 0x02, тінь FBlock, тінь інстанція, 0x01, 0x01, FBlock, інстанція, 0x01, 0x11];
    - 0x408 — зупинити поточне: [0x00, 0x02, тінь FBlock, тінь інстанція, 0x01, 0x11];
    - 0x406 — від'єднати поточне: [0x00, 0x03, тінь…, FBlock, інстанція, 0x01, 0x11];
    - 0x407 — під'єднати нове: [0x00, 0x01, тінь FBlock, тінь інстанція, 0x01, 0x11].
  - **0x409 — гучності класів звуку.** Музика лежить у байті 2 запису. Решта — за номерами каналів:
    - телефон — 0x05 і 0x06;
    - навігація — 0x07;
    - голос — 0x08;
    - парктронік — 0x09 і 0x0A, передній і задній.

    Рівні 0–25 кодуються як рівень + 5.
- **Тінь підсилювача.** Екран говорить не з підсилювачем, а з його тінню 0x22.A1 у шлюзі. HU. Тінь має функції, яких
  сам підсилювач XF не має, тож шлюз перекладає їх у функції підсилювача: SpeakerLevel, Bass, Treble, Mute і власні
  0xE0x. Функції тіні:

  | FktID | Функція | Значення |
  |---|---|---|
  | 0x200 | Balance | −10…+10 |
  | 0x201 | Loudness | вимк. / увімк. |
  | 0x202, 0x203 | Bass, Treble | −6…+6 |
  | 0x204 | Fader | −10…+10 |
  | 0x400 | Volume | — |
  | 0x402 | Subwoofer | 0…20 |
  | 0x467 | MixerLevel | — |
  | 0xE09 | джерело | — |
  | 0xE20 | центр | [режим, −6…+6] |
  | 0xE21 | об'ємність | −6…+6 |
  | 0xE22 | режим прослуховування | 0…2 |
  | 0xE24 | AVC, гучність від швидкості | 0…2 |

- **Підписка підсилювача.** Підсилювач XF підписується на функцію 0x303 у FBlock 0xF5 шлюзу. Що в ній, не встановлено.
  HU.
- **Discovery 3.** Гучність від швидкості (AVC) веде сам підсилювач: 10 рівнів, ГУ рахує зміну за швидкістю коліс.
  LRM.

## 6. Робочі продукти в ролі підсилювача

- **mObridge MOST25 DA** стає на місце штатного підсилювача. MOB, MOB-RN.
  - **Протоколи JLR.** Обирає один із трьох за типом ГУ: Land Rover 6CD (2005–2010), Land Rover із сенсорним
    екраном (2010–2017), Jaguar із сенсорним екраном (2010–2017). Jaguar без штатного підсилювача дилер має
    перекодувати.
  - **Виходи.** TOSLINK 24 біти 48 кГц. REM вмикається автоматично: 12 В, до 500 мА.
  - **Нотатки до прошивки:**
    - «Rework Jaguar, Land Rover G2 volume mapping to have more range»: у JLR гучність ГУ має свою шкалу;
    - «Additional support for Jaguar vehicles requiring two MOST25 amplifier instances»: деяким Jaguar потрібні дві
      інстанції підсилювача;
    - «Fixing audible pops on channel mute/unmute».
- **Trioma MOST-TosLink 3.0** заміняє підсилювач і обирає перемичкою один із 22 алгоритмів. TRI.
  - **Алгоритми Land Rover** (спільні з Volvo):
    - S80/XC70 до 2012 разом із Freelander 2;
    - Freelander 2 HSE;
    - Discovery 3/4 до 2013 разом із RRS до 2012;
    - Evoque, RRS 2012+ і Discovery 4 2013+.
  - **Серійний номер.** Окремий режим зчитує серійний номер штатного підсилювача Volvo або Land Rover (розд. 7).
  - **Зведення.** Сам забирає основне стерео й сигнали телефона, навігації, парктроніка та службові. Підмішує їх до
    основного «в соответствующих пропорциях», яких інструкція не наводить.
  - **Регулювання.** Гучність, баланс, низькі, високі й 5-смуговий EQ бере з ГУ. Фейдер — лише у версії з RCA. На
    середніх положеннях тембру блок частотної корекції вимикається.
  - **Вихід.** Стерео PCM 24 біти, 44.1 або 48 кГц.
- **usb2most** може сам бути підсилювачем для штатної ГУ: серед його ролей є «підсилювач» і
  «підсилювач-посередник». U2M. У рестайловій мультимедіа Freelander 2 (ГУ LR057333, радіоблок IAM2.1) він стоїть у
  кільці як AUD3-12 і передає звук дорестайловому підсилювачу 6H52-18C808-CD. SG-RS.

- **Типи.** Підтримує сім типів: Freelander 2 Hi і Premium, AUD3-8/12/16, Discovery 3 Hi і Premium.
- **Гучність.** Тримає її як загальний рівень плюс рівні груп динаміків: передні лівий і правий, центр, задні, бокові,
  сабвуфер. Це відповідає SpeakerLevel по динаміках.
- **Відкритість.** Вихідний код прошивки не опубліковано, лише бінарники.

## 7. Захист компонентів

- **Volvo, Land Rover, Range Rover.** Захисне кодування в машині може бути ввімкнене або ні. Коли воно ввімкнене,
  ГУ перевіряє серійний номер підсилювача. З чужим номером звук «прекратится через 20-40сек или при смене источника
  звука». TRI.
- **Як Trioma це обходить.**
  1. Перемички ставлять у положення «Read Serial Number».
  2. Адаптер вмикають у кільце, не знімаючи штатного підсилювача, і вмикають аудіосистему.
  3. Адаптер зчитує серійний номер штатного підсилювача й зберігає у своїй енергонезалежній пам'яті. Це займає до
     20 с. Кінець адаптер показує імпульсами раз на секунду на виході REM.
  4. Штатний підсилювач знімають, перемички ставлять під машину.

  TRI.
- **Range Rover.** Опис аудіосистеми каже, що з невідомим серійним номером будь-якого компонента вся аудіосистема не
  працює. Номер заміненого компонента прописують у реєстр щитка приладів. FFR.
- **Volvo XC90.**
  - Серійні номери аудіокомпонентів зберігаються в ICM. Компонент із незареєстрованим номером вимикає систему.
  - Перевірку можна вимкнути оновленням конфігурації у VIDA, у дилера. VF2.
  - З таким самим підсилювачем з іншої машини радіо грає 10–20 с і вимикається, а зі своїм працює. VF1.
- **Jaguar.** Якщо машина була без штатного підсилювача, дилер перекодовує її під підсилювач. MOB. Чи перевіряє Jaguar
  серійний номер, не встановлено.
- **Для пристрою.** У машині з увімкненим захистом пристрій мусить віддавати ГУ серійний номер штатного підсилювача
  цієї машини. Інакше захист треба вимкнути в дилера.

## 8. Відкрите

- **Серійний номер.** Закрито з usb2most: ГУ читає його з Diagnosis 0x06.86 функцією 0xD22, SetGet [0xF1, 0x8C]
  (ecu_sn). Тією самою функцією — номери деталей: F112, F191, F188, F124. Чи шле ГУ саме цей запит у кожній моделі,
  покаже режим навчання. U2M-FW.
- **Приглушення музики.** Поки звучать приймачі 2–4, музику на приймачі 1 може приглушувати або ГУ, або сам
  підсилювач.
  - Якщо ГУ — командами SpeakerLevel чи Mute по приймачу 1. Пристрій виконує всі команди по кожному приймачу, тож
    штатна логіка вийде сама.
  - Якщо підсилювач сам, команд немає, і приглушувати доведеться пристрою, на відому глибину.

  Котрий варіант у JLR, з джерел не видно.
- **Шкала гучності.** На шині децибели. Таблиці usb2most, рівень → дБ: дорестайл 36 рядків, −99…0, AUD3 61 рядок, −99…0.
  Чи так само робить кожна штатна ГУ, з коду не видно. U2M-FW: 0x08046BF7, 0x0804877C.
- **Інші команди шлюзу.** Значення полів 0xE04–0xE08 невідомі; байти й стартові значення є: `docs/usb2most/`. E05h
  `[2, 0, режим]`: 0 стерео, 1 Meridian, 2 DPL2, 5 Neo:6 (висновок із U2M-FW 0x08037F0C і `msg.h`).
- Відповіді Diagnosis 0xD19 (коди несправностей): usb2most відповідає на п'ять запитів сталими байтами, їх значення
  невідоме. Прошивка віддає ті самі байти.

## Джерела

| Ключ | Джерело |
|---|---|
| SG1 | SmartGauges, «Сравнение MOST усилителей Hi-Line и Premium», drive2.ru/l/548968564636255384 |
| SG3 | SmartGauges, «Обзор MOST усилителей meridian 220, 380, 825», drive2.ru/l/560626686425564540 |
| SG-51 | SmartGauges, «Объемный звук 5.1 в freelander2 через шину MOST», drive2.ru/l/539813755945485340 |
| SG-U2 | SmartGauges, «Плата usb2most v2», drive2.ru/l/556915834681819781 |
| SG-RS | SmartGauges, «Подключение рестайловой мультимедиа система в freelander2», drive2.ru/l/559134374268764551 |
| SG-PDC | SmartGauges, «Превращаем freelander в tiguan», drive2.ru/l/543928403334529733 |
| U2M | github.com/smartgauges/usb2most, `android/msg.h` |
| U2M-FW | usb2most, прошивка `fw/main-v24.bin`, копія в `ref/usb2most`: рядки модулів amp_lr2, amp_aud3, таблиці FBlock (0x2E9FE, 0x2EC2C), функцій (0x259C0–0x25B33, 0x277F4–0x27946) і DID (0x25A2C); код (база 0x08020000): маршрути OS8104 0x08023F88, Connect дорестайлу 0x08033F60 і AUD3 0x080378C8, Allocate AUD3 0x080385DA |
| SDD | JLR SDD 169, дані програм X250, X150, X351: `PLATFORM_*.xml`, `*/AAM.xml`, `sw_archive_*.xml` (`Downloads\SDD169_DECRYPTED` на ПК) |
| SM | github.com/rhysmorgan134/SocketMost, README |
| MOST-AA | MOST Cooperation, *MOST FunctionBlock AudioAmplifier Rev 2.4.3*, 07/2011, з бібліотеки FBlock MOST 2V5 (mostcooperation.com) |
| MOST-GFB | MOST Cooperation, *MOST25 FunctionBlock GeneralFBlock Rev 2.5.1*, там само |
| MOB | mObridge, *MOST25 DA Series Guide* V6, с. 8, 13, 18–19 (mobridge.us) |
| MOB-RN | mObridge, нотатки до прошивок підсилювачів (docsupport.mobridge.us, K2.MOST25 0.8.1) |
| M2A | MOST25-to-AUDIO, `docs/control_commands.md` (теорія) |
| TRI | Trioma, «Инструкция аудиоинтерфейса MOST-TosLink 3.0», trioma.ru/instructions/base/instruktsiya-audio-interfejsa-most-toslink-3-0/ |
| VF1 | volvoforums.org.uk, XC90, «Replacing high performance amplifier», NathanK, 01.10.2010 |
| VF2 | volvoforums.org.uk, XC90, «Stereo probs», SwissXC90, 27.05.2019 |
| FFR | fullfatrr.com, форум Range Rover L322, цитата опису аудіосистеми (post600353) |
| LRM | Land Rover, сервісний мануал Discovery 3, опис аудіосистеми |
| HU | github.com/rhysmorgan134/JLR-HU: гілка rework-visuals-all-dab, `src/main/newPiMost/FBlocks.ts`; коміт ac1fe6d; `findings/most`; `src/main/PiMostFunctions/control/Switching.ts` |
