Oleg-mk/JLR-MOST-Amp/docs/usb2most/check_amp.md

# Звірка емуляції підсилювача з usb2most

Кожна функція `fw/main/amp.c` проти обробника й відправника в `main-v24.bin`. Звірка від 4 листопада 2026, прошивка до неї
74fb1cb.

**Чому usb2most — еталон.** Він працює в машинах як ці підсилювачі. Для XF це той самий підсилювач: каталог SDD дає XF
6H52-18C808-CE і -DE, тобто родину Freelander 2. Журналу кільця з машини в нас немає, тож усе тут із коду usb2most, а не зі
спостереження.

**Як читати.** Розбір кожного обробника: [decode_prefacelift.md](decode_prefacelift.md), [decode_aud3.md](decode_aud3.md). Їх
зробили окремо один від одного, за самим бінарником, не бачачи нашого коду. Найважливіші рядки (SpeakerLevel, Connect, E05h,
E0x Get, ShutDown, запити до майстра, вибір 22.02 і 22.05) я перевірив у дизасемблері сам. Решта спирається на ці розбори,
а спільне для обох драйверів вони прочитали однаково.

Статус рядка:
- **виправлено** — було неправильно, тепер як в usb2most;
- **додано** — у нас цього не було;
- **збігається**;
- **свідомо інакше** — причина в рядку;
- **висновок** — прямого доказу немає, перевірити на першій платі в кільці (кінець файлу).

## Профілі

| Що | usb2most | Було | Статус |
|---|---|---|---|
| Основний FBlock | Hi-Line 22.02, Premium 22.05, вибір за типом (0x080322FC). Фото SG1: 22.02 на 6H52-18C808-CD | обидва 22.05, у документах «Land Rover / Jaguar» | **виправлено** |
| FBlockIDs | `22 02 22 20 23 01 06 86`, `22 05 22 20 23 01 06 86`, `22 0A 06 86 23 01` | перший неправильний | **виправлено** |
| FktIDs 22.02 | 33 байти, у кінці чотири нулі | список Premium | **виправлено** |
| FktIDs 22.05, 22.20, 23.01 | | | **збігається** |
| FktIDs 06.86 Hi-Line | не за зростанням: `D35 D36 D35 D36` | список Premium | **виправлено** |
| FktIDs 06.86 AUD3 | 26 байтів, не за зростанням | список дорестайлу | **виправлено** |
| Розбір списку (`most_fktids_decode`) | біт перемикається в порядку списку | обривався на першому спаданні: зчитаний підсилювач втрачав D19, D2E, D85 | **виправлено** |
| Список зчитаного підсилювача | | кодувався наново, байти могли змінитись | **виправлено**: віддається як прийшов |
| AUD3-12 і -16 | у типу -12 список без E05h, у -16 з E05h | один, з E05h | **свідомо інакше**: фото SG3 показує E05h на справжньому AUD3-12 |
| Номер деталі Premium | відповідає 6H52-18C808-CD | -DD | **свідомо інакше**: SG1 каже -DD для Premium |
| Серійний номер | сталий 699129917932 | нулі, доки не зчитано | **свідомо інакше**: концепція |

## Дорестайл: 22.02 і 22.05

| Функція | usb2most | Було | Статус |
|---|---|---|---|
| 46Dh Set | `[рядок, 0, дБ…]`: байт 0 рядок 1..4, байт 1 динамік (0x08034140), шле так само (0x080330E8). 5 рівнів fl c fr rl rr. `[0, 0, 4 x 5]` усі рядки. Без відповіді | **байти навпаки**: `[1, 0, …]` писалось в усі приймачі, `[2, 0, …]` у всі приймачі зі зсувом. Музика могла стрибнути на рівень телефона | **виправлено** |
| 46Dh, рівень понад 0 дБ | не перевіряє; центр буває вище 0 на повній гучності (0x08033604) | Error 06, команда пропадала | **виправлено**: приймається, на виході не вище 0 дБ |
| 46Dh Get | `[r, 0]` → `[00 00, рядок]`, `[0, 0]` → `[00 00, усі]`, інше порожній Status, довжина не 2 → Error `06`. До Set усе −99 дБ | інакше, до Set Error | **виправлено** |
| 466h Set | рядки 1..4, довжина 7, інше ігнорує, без відповіді | Error на все інше | **виправлено** |
| 113h Mute | у списку є, обробника немає | за GeneralFBlock | **свідомо інакше**: каталог; ГУ, що шле Mute, почує його |
| 111h Connect | Result на будь-який приймач; канали не перевіряє; сам шле підсилювачу `c+1 c c+5 c+4` | невідомий приймач і неспадний список → Error 06 | **виправлено** |
| 112h DisConnect | Result на будь-який приймач, маршрут лишає | маршрут знімає | **виправлено** щодо Result; маршрут **свідомо інакше**: приймач має замовкнути |
| 202h, 203h Set | один байт, без відповіді | те саме | **збігається** |
| 427h, 430h, 431h, 441h Set | без відповіді | те саме, зберігається за `[рядок, параметр]` | **збігається** |
| 461h Set | без відповіді | те саме | **збігається** |
| 461h Get | відповідає зі своєї таблиці 45 рядків | лише те, що прийшло тим самим Pos | **свідомо інакше**: ця таблиця для його застосунку; звук від неї не залежить. Побачимо в журналі, чи ГУ питає |
| E04h, E05h, E07h | Set лише повної довжини, Get `[0, 0]` віддає таблицю зі стартовими значеннями | зберігалось будь-що, Get до Set → Error | **виправлено** |
| E08h | Set `[0, 0, 14]` або `[1|2, 0, 7]`, інше Error `06`; Get без Pos, перші 2 байти нулі | як E04h | **виправлено** |
| E09h на основному FBlock | приймає, у списку немає | Error 03 | **виправлено** |
| 001h Notification | нічого не зберігає й не відповідає | таблиця підписок, Status, Error 41h і 20h | **свідомо інакше** щодо таблиці й Status: специфікація, зайвого не шле, бо підписуються на інше. Error **прибрано**: ГУ на старті підписується на функції, яких немає в списку |
| 002h NotificationCheck | немає | за каталогом | **свідомо інакше**: нешкідливо |
| 101h, 102h | приймає, у списку немає, результату в режимі підсилювача не дає | Error 03 | **свідомо інакше**: у списку немає, ГУ не викличе |
| Невідома функція, FBlock | мовчить | Error 03, 01 | **свідомо інакше**: специфікація; запитів таких не знаємо |
| Чужа InstID у 22 | мовчить | Error 02 | **виправлено**: його старт шле 22.20 на AUD3 |

## Дорестайл: інші FBlock

| Функція | usb2most | Було | Статус |
|---|---|---|---|
| 22.20: 466h, E09h | приймає, без відповіді | те саме | **збігається**. Рядок 1 його 466h до нашого глушіння музики не йде: **висновок** |
| 23.xx: 466h, E00h | будь-яка InstID, без відповіді | лише 23.01 | **виправлено** |
| 06.xx D22h | як у нас; чужий DID `F1 xx` → `06 01 F1 xx`, не F1 → мовчить | Error `07 01 F1` | **виправлено** |
| 06.xx D19h | 5 сталих запитів, 5 сталих відповідей | Error 41 | **додано**: байти перевіряються проти бінарника |
| 06.xx решта списку | мовчить | Error 41 | **виправлено** |
| 06.xx 001h E10h | немає обробника | Error 41 | **виправлено**: мовчить |

## NetBlock

| Функція | usb2most | Було | Статус |
|---|---|---|---|
| 000h Get | список FBlock | те саме | **збігається** |
| 001h Get | `FF FF 00` | мовчав | **додано** |
| 002h Get | `40, позиція` | мовчав | **додано** |
| 003h Get | адреса вузла | мовчав | **додано** |
| 004h Get | `03 22` | мовчав | **додано**. Чип у нього стоїть на іншій групі (bGA 50h), у нас на 22h, як він відповідає: **свідомо інакше**, групових команд на 322h звук не потребує |
| 006h Query | Result `[00]` | мовчав | **додано** |
| 006h Execute | без відповіді, сон | те саме, `power.c` | **збігається** |
| 401h | мовчить | те саме | **збігається** |
| 000h SetGet, зміна InstID | для 06 і 23 | немає | **свідомо інакше**: у кільці один підсилювач, дублікатів немає. Для адаптера теж: він їх не заявляє |

## Майстер мережі

| Подія | usb2most | Було | Статус |
|---|---|---|---|
| Кому слати | тому, хто надіслав Configuration OK | завжди 0x161. На машинах з AUD3 майстер інший (SDD: FCDIM), повідомлення йшли в нікуди | **виправлено** |
| AUD3 на OK | F5.305 Get `26 28 24`, F5 Notification 200h, F5 Notification 303h, три повідомлення | без 305h, дві підписки одним | **виправлено** |
| Лише AUD3-16? | у нього лише для типу -16 | для всіх AUD3 | **висновок** |
| Дорестайл на OK | нічого | підписка 303h за JLR-HU | **свідомо інакше**: так робить справжній підсилювач XF (коментар JLR-HU) |
| Відповідь F5 | лише в журнал | лише в журнал | **збігається** |
| NotOK, адреса | стає 0x100 + позиція | лишається 0x186 | **свідомо інакше**: 0x186 у статичному діапазоні (MOST 3.2.2.3), SDD каже AAM 0x86 |
| NotOK, приймачі | маршрути не чіпає | не чіпає | **збігається**; специфікація велить глушити й від'єднувати, але ГУ без Mute тоді лишилась би без звуку |

## AUD3: 22.0A

| Функція | usb2most | Було | Статус |
|---|---|---|---|
| 46Dh Set | `[рядок, 0, 7 рівнів]`, рядки 1..4; `[0, 0, 4 x 7]`. Рядок не дорівнює номеру приймача | рядок читався як приймач | **виправлено** |
| Рядки | 1 основний, 2 дзвінок, 4 радар (0x08037E66–0x08037EAA) | немає | **виправлено**. Рядок 3 навігація: **висновок** |
| 466h Set | рядки 1..4 | приймачі | **виправлено** |
| 111h Connect | 1 основний 4 канали, 2 відео 6, 4 дзвінок, 6 радар, 7 навігація, по 2 | те саме | **збігається** |
| 200h, 202h, 203h, 204h Set | один байт, без відповіді | те саме; Balance іде у звук | **збігається**. Крок 2 дБ: **висновок** |
| 001h на D00h | Status `01 00 02 00 06 00 01` тому, хто в параметрі | Error 41 | **виправлено** |
| E05h, 3 байти | D00h Status `m 00 02 00 06 00 01`, m: 5 і 7 → 4, 0x0D → 2 | зберігалось | **виправлено** |
| E05h, E08h | як у дорестайлу | | **виправлено** |
| D01h, E09h | без відповіді | те саме | **збігається** |
| E53h | приймає, у списку немає | Error 03 | **виправлено** |
| 001h на 0C01h, 0353h | мовчить | Error 20h | **виправлено** |
| 06.xx, будь-яка InstID | 001h E10h → порожній Status E10h | лише 06.86, Error 41 | **виправлено**: його старт питає 06.0A |
| 101h, 102h | у режимі підсилювача результату нема | Result з каналами | **свідомо інакше**: специфікація; справжній AUD3 джерело, а канали ми заповнюємо нічим |

## Перевірити на першій платі в кільці

Цього не закриває жоден код:

1. Чи шле стара ГУ Mute 113h і чи читає EQ через 461h Get. Журнал покаже.
2. Чи рядок 3 на AUD3 навігація, а не щось інше.
3. Крок Bass, Treble і Balance у децибелах.
4. Чи справжній AUD3-8 і -12 теж питає F5.305 на старті.
5. Що означають поля E04h, E05h, E07h, E08h. Вони зберігаються й повертаються, на звук не діють.
6. Чи варто застосовувати 466h для 22.20 до музики. Зараз глушіння музики 20 мс, доки ГУ не задасть рядок 1.

## Що перевіряє це тепер

- `fw/tools/host/golden.py` читає байти прямо з `main-v24.bin` у `fw/main/u2m_golden.h`, а `run.py` щоразу звіряє заголовок із
  бінарником. Самоперевірка порівнює відповіді з цими масивами, а не з набраними мною вручну.
- Самоперевірка проганяє весь старт ГУ з методу +40 його драйвера: Premium, Hi-Line, AUD3.
- `fw/tools/host/mutate.py` повертає старі дефекти по одному в копію `amp.c` і показує, що тести їх ловлять.
