Oleg-mk/JLR-MOST-Amp/hw4/production/Bitline-4L-BOM.csv

Comment | Designator | Footprint | Quantity | LCSC Part #
100n | C1,C3,C5,C6,C8,C9,C15,C16,C17,C21,C31,C33,C35,C38,C41,C42,C43,C44,C53,C68,C69,C70,C71,C73,C74 | C_0603_1608Metric | 25
10u | C2,C4,C7,C10,C30,C32,C34 | C_0805_2012Metric | 7
18p | C11,C12 | C_0603_1608Metric | 2
100n C0G | C13 | C_1206_3216Metric | 1
1u | C14,C22,C54,C66,C67 | C_0603_1608Metric | 5
22u | C20,C58,C59 | C_1206_3216Metric | 3
2.2u | C36,C37,C52,C62 | C_0805_2012Metric | 4
2.2n C0G | C39,C40 | C_0603_1608Metric | 2
47u 50V | C50,C65 | CP_Elec_8x10 | 2
1u 50V | C51,C61,C72 | C_0805_2012Metric | 3
10u 50V | C55,C56 | C_1210_3225Metric | 2
100n 50V | C57,C60,C63,C64,C75,C76,C77 | C_0603_1608Metric | 7
SS34 | D1 | D_SMA | 1
SM6T30A | D2 | D_SMB | 1
BAT54C | D3 | SOT-23 | 1
LED 3 mm | D20 | LED_D3.0mm | 1
1.5A T | F1 | Fuse_1206_3216Metric | 1
600R@100MHz | FB1,FB2,FB3 | L_0603_1608Metric | 3
43045-0421 | J1 | Molex_Micro-Fit_3.0_43045-0421_2x02-1MP_P3.00mm_Horizontal | 1
TE 1-1394640-1 | J2 | TE_MOST_Pigtail_FOT_2+0 | 1
RCA L | J4 | BKL_0101153_RCA_RA | 1
RCA R | J5 | BKL_0101153_RCA_RA | 1
RCA S/PDIF | J6 | BKL_0101153_RCA_RA | 1
HDMI I2S | J7 | HDMI_A_Kycon_KDMIX-SL1-NS-WS-B15_VerticalRightAngle | 1
штирі 1x4 | J8 | PinHeader_1x04_P2.54mm_Vertical | 1
штирі 1x5 | J9 | PinHeader_1x05_P2.54mm_Vertical | 1
USB-C | J10 | USB_C_Receptacle_14P_SideInsert_THT | 1
10u NRSE6028-100M | L1 | L_Bourns-SRN6028 | 1
2.2u CKCSA4020-2.2uH/M | L2 | L_Coilcraft_XxL4030 | 1
BSS84 | Q1 | SOT-23 | 1
MMBT3904 | Q2,Q3 | SOT-23 | 2
100 | R1,R5 | R_0603_1608Metric | 2
100k | R2,R17,R50,R51 | R_0603_1608Metric | 4
47k | R3,R7,R10,R11 | R_0603_1608Metric | 4
15k | R4 | R_0603_1608Metric | 1
2.2k | R6 | R_0603_1608Metric | 1
4.7k | R8,R9,R27,R28,R57,R62,R63 | R_0603_1608Metric | 7
10k | R12,R16,R20,R21,R22,R23,R24,R25,R30,R31,R52,R59,R64,R65 | R_0603_1608Metric | 14
68 | R13,R18 | R_0603_1608Metric | 2
47 | R14,R15 | R_0603_1608Metric | 2
1k | R26 | R_0603_1608Metric | 1
470 | R32,R33 | R_0603_1608Metric | 2
249 | R34 | R_0603_1608Metric | 1
107 | R35 | R_0603_1608Metric | 1
4.02k | R58 | R_0603_1608Metric | 1
5.1k | R60,R61 | R_0603_1608Metric | 2
DP-04 Piano | SW1 | SW_DIP_SPSTx04_Piano_10.8x11.72mm_W7.62mm_P2.54mm | 1
TL3305A | SW2 | SW_SPST_TL3305A | 1
OS8104AAQ | U1 | LQFP-44_10x10mm_P0.8mm | 1
ESP32-WROVER-IE-N16R8 | U2 | ESP32-WROVER-IE | 1
PCM5122PW | U3 | TSSOP-28_4.4x9.7mm_P0.65mm | 1
74LVC1G125 | U4 | SOT-23-5 | 1
PLT133/T10W | U5 | Everlight_TOSLINK_T10 | 1
DS90LV047ATMTCX | U6 | TSSOP-16_4.4x5mm_P0.65mm | 1
TPS7B8133DRV | U7,U9 | WSON-6-1EP_2x2mm_P0.65mm_EP1x1.6mm | 2
LM65625-Q1 | U8 | TI_RZT0020A | 1
TPS1H200A-Q1 | U10 | HVSSOP-8-1EP_3x3mm_P0.65mm_EP1.57x1.89mm | 1
CH340C | U11 | SOIC-16_3.9x9.9mm_P1.27mm | 1
AP2112K-3.3 | U12 | SOT-23-5 | 1
USBLC6-2SC6 | U13 | SOT-23-6 | 1
12.288MHz | Y1 | Crystal_SMD_3225-4Pin_3.2x2.5mm | 1
