Oleg-mk/JLR-MOST-Amp/tube/6n16b/production/Bitline-tube-6N16B-BOM.csv

Comment | Designator | Footprint | Quantity | LCSC Part #
100n 50V | C1,C17,C27,C59,C62,C64 | C_0805_2012Metric | 6
47u 50V | C2,C61 | CP_Elec_8x10 | 2
10u 50V | C4,C5,C16,C58 | C_1210_3225Metric | 4
100n 50V | C6,C7 | C_0603_1608Metric | 2
100n | C8 | C_0603_1608Metric | 1
1u | C9 | C_0603_1608Metric | 1
22u 16V | C10,C11,C54,C55 | C_1206_3216Metric | 4
1u 50V | C12,C23 | C_0805_2012Metric | 2
1u 25V | C13 | C_0805_2012Metric | 1
100n | C14,C25,C57 | C_0805_2012Metric | 3
1n | C15 | C_0805_2012Metric | 1
100n 630V | C18,C19,C63 | C_1812_4532Metric | 3
10u 350V | C20,C60 | CP_Radial_D10.0mm_P5.00mm | 2
220n | C21 | C_0805_2012Metric | 1
100p | C22 | C_0805_2012Metric | 1
2.2u | C24 | C_0805_2012Metric | 1
2.2u 10V | C26 | C_0805_2012Metric | 1
100p C0G | C28,C41 | C_0805_2012Metric | 2
47u 250V | C29,C42 | CP_Radial_D12.5mm_P5.00mm | 2
100n 250V | C30,C43 | C_1206_3216Metric | 2
100n 250V | C31,C32,C33,C44,C45,C46 | C_Rect_L7.2mm_W4.5mm_P5.00mm_FKS2_FKP2_MKS2_MKP2 | 6
470n 250V | C34,C47 | C_1210_3225Metric | 2
4.7u 250V MKS4 | C35,C36,C48,C49 | C_Rect_L31.5mm_W11.0mm_P27.50mm_MKS4 | 4
1n C0G | C37,C38,C39,C50,C51,C52 | C_0805_2012Metric | 6
10n 100V | C40,C53 | C_0805_2012Metric | 2
1.5u 10V | C56 | C_0805_2012Metric | 1
SS54 | D1 | D_SMC | 1
SM6T30A | D2 | D_SMB | 1
ES1J | D3 | D_SMA | 1
BAT54W | D4 | D_SOD-123 | 1
3A T 0452003 | F1 | Fuse_Littelfuse-NANO2-451_453 | 1
BLM41PG600SN1 | FB1 | L_1806_4516Metric | 1
гніздо 1x5 | J1 | PinSocket_1x05_P2.54mm_Vertical | 1
43045-0221 | J2 | Molex_Micro-Fit_3.0_43045-0221_2x01-1MP_P3.00mm_Horizontal | 1
гніздо 1x4 | J3 | PinSocket_1x04_P2.54mm_Vertical | 1
NC3MAH | J5,J6 | Neutrik_NC3MAH | 2
RCA OUT L | J7 | BKL_0101153_RCA_RA | 1
RCA OUT R | J8 | BKL_0101153_RCA_RA | 1
10u NRSE8040-100M | L1 | L_Bourns-SRN8040_8x8.15mm | 1
2.2u CKCSA4020-2.2uH/M | L2 | L_Coilcraft_XxL4030 | 1
33u CDRH129RNP-330MC | L3 | L_Coilcraft_MSS1278-XXX | 1
Keystone 3566 | MP1,MP2,MP3,MP4 |  | 4
IPD60R600P7 | Q1 | TO-252-2 | 1
DN2540N8 | Q2,Q3,Q4,Q5 | SOT-89-3 | 4
100k | R1,R3,R6,R66 | R_0805_2012Metric | 4
14.3k | R2 | R_0805_2012Metric | 1
18.7k | R4,R7 | R_0805_2012Metric | 2
115k | R5 | R_0805_2012Metric | 1
10 | R8,R43,R65 | R_0805_2012Metric | 3
47k | R9,R16 | R_0805_2012Metric | 2
0.18 1% | R10 | R_1206_3216Metric | 1
100 | R11,R40,R41,R42,R62,R63,R64 | R_0805_2012Metric | 7
330k | R12,R13,R14 | R_1206_3216Metric | 3
5.9k | R15 | R_0805_2012Metric | 1
1M | R17 | R_0805_2012Metric | 1
52.3k | R18 | R_0805_2012Metric | 1
10k | R19,R20 | R_0805_2012Metric | 2
4.02k | R21,R23,R45 | R_0805_2012Metric | 3
36k | R22,R44 | R_0805_2012Metric | 2
1k | R24,R27,R30,R46,R49,R52 | R_0805_2012Metric | 6
470 | R25,R47 | R_1206_3216Metric | 2
27k | R26,R48 | R_2512_6332Metric | 2
1M | R28,R32,R33,R34,R35,R50,R54,R55,R56,R57 | R_1206_3216Metric | 10
15k | R29,R51 | R_2512_6332Metric | 2
14k | R31,R53 | R_2512_6332Metric | 2
620 | R36,R37,R58,R59 | R_0805_2012Metric | 4
47k | R38,R39,R60,R61 | R_1206_3216Metric | 4
10k | R67,R68,R69,R70 | R_2512_6332Metric | 4
LM65625-Q1 | U1 | TI_RZT0020A | 1
LM5022-Q1 | U2 | MSOP-10_3x3mm_P0.5mm | 1
TPS7B8133DRV | U3 | WSON-6-1EP_2x2mm_P0.65mm_EP1x1.6mm | 1
TPS3808G01-Q1 | U4,U6 | SOT-23-6 | 2
TPS1H200A-Q1 | U5 | HVSSOP-8-1EP_3x3mm_P0.65mm_EP1.57x1.89mm | 1
6N16B-V | V1,V2,V3,V4 | Valve_6N16B-V_Flat | 4
