Oleg-mk/JLR-MOST-Amp/hw/production/Bitline-2L-assembly-top.pdf

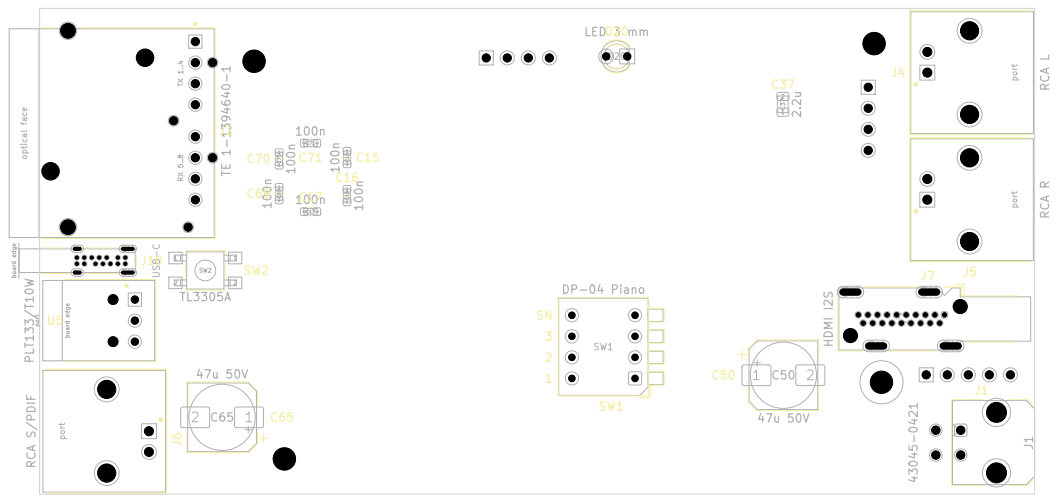
[picture p1: page 1]

board USB-Cedge TE optical 1-1394640-1 face TX 1..4 RX 5..8 RCA S/PDIF port 100n C15 RCA R port HDMI I2S J7
