Oleg-mk/JLR-MOST-Amp/tube/6n28b/production/Bitline-tube-6N28B-schematic.pdf

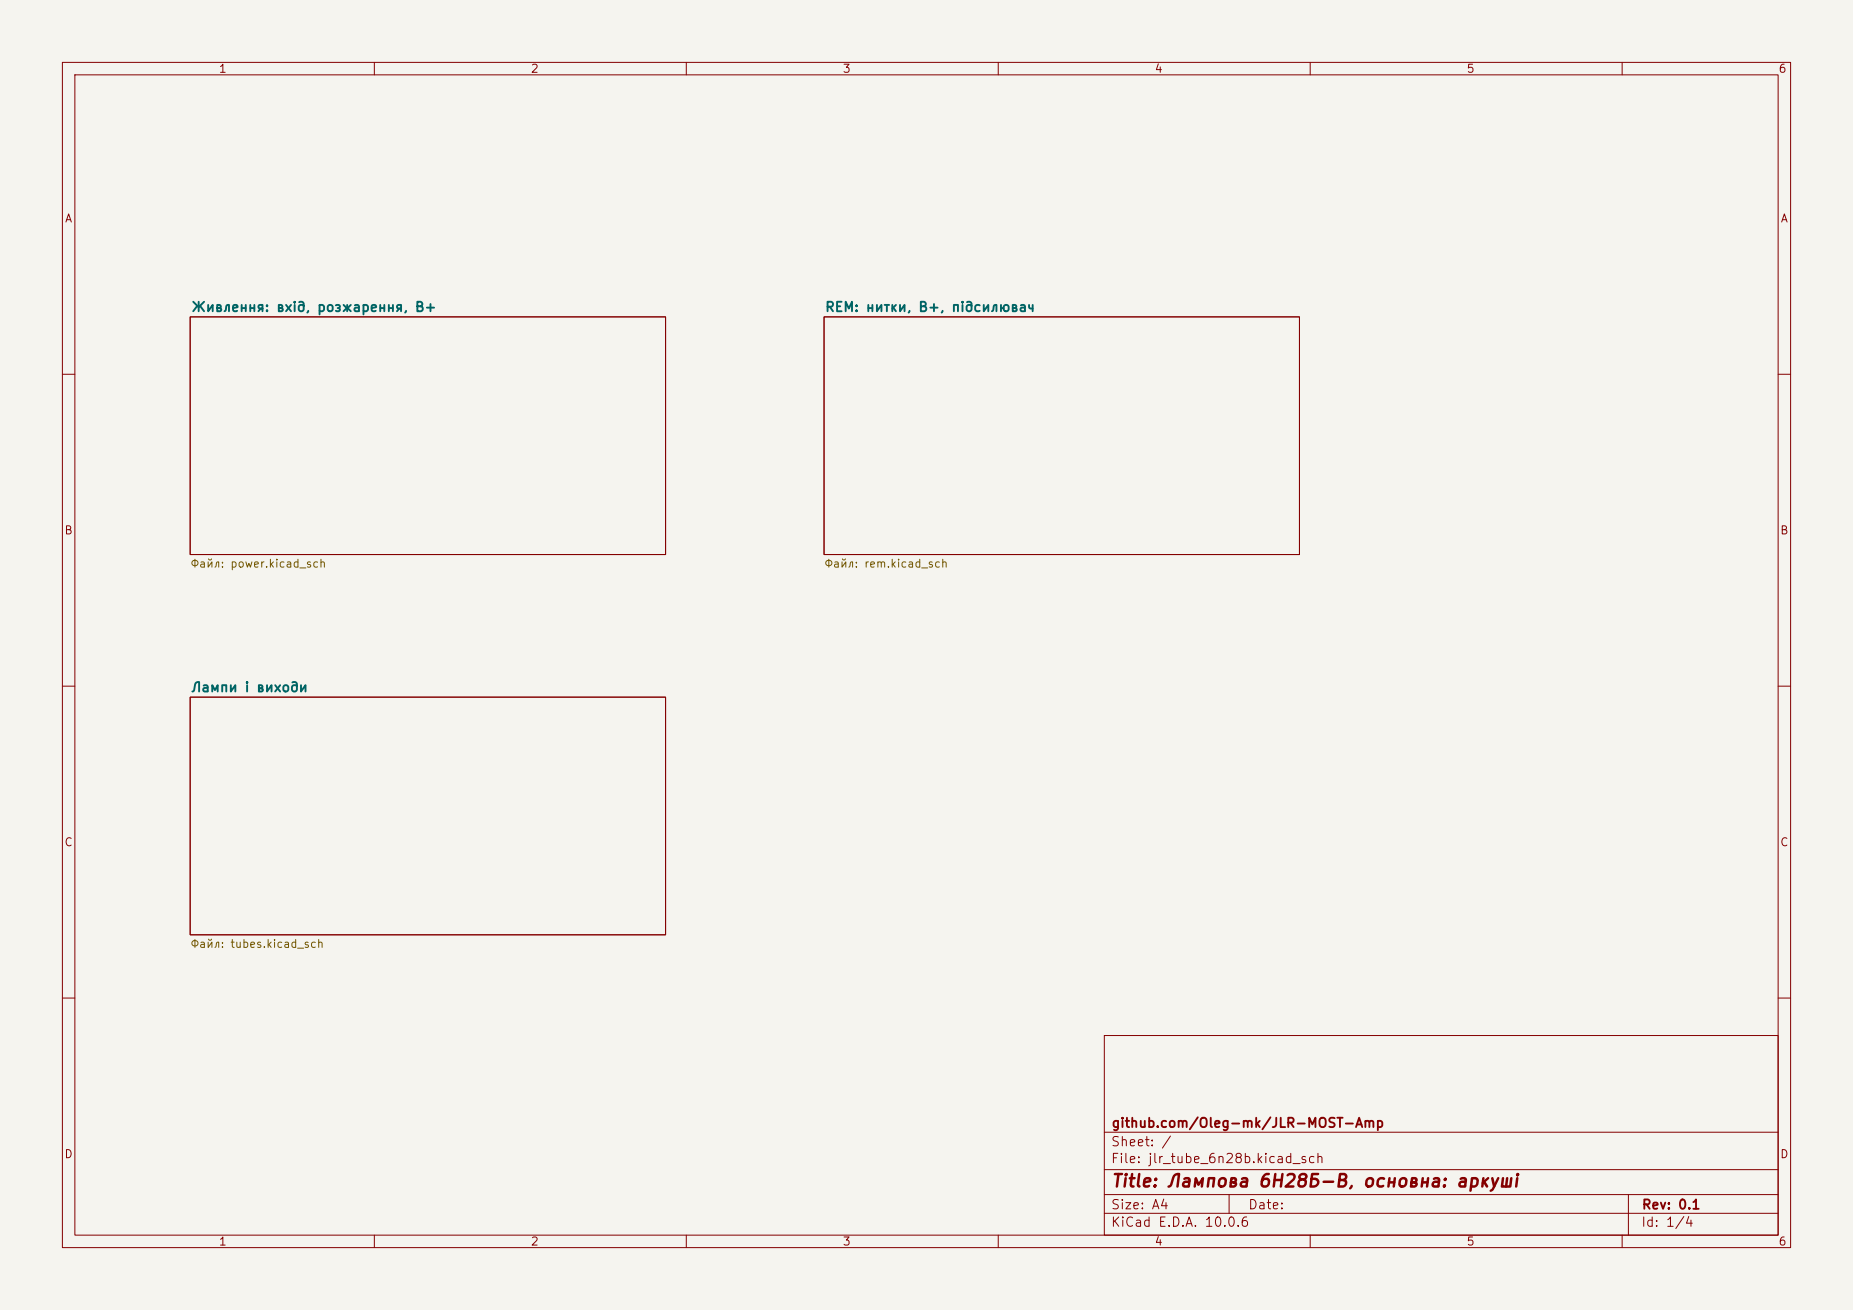
[picture p10: page 1]

REM: нитки, B+, підсилювач Файл: rem.kicad_sch Лампи і виходи

github.com/Oleg-mk/JLR-MOST-Amp
Sheet: /
File: jlr_tube_6n28b.kicad_sch
Title: Лампова 6Н28Б-В, основна: аркуші

Size: A4 | Rev: 0.1
KiCad E.D.A. 10.0.6 | Id: 1/4

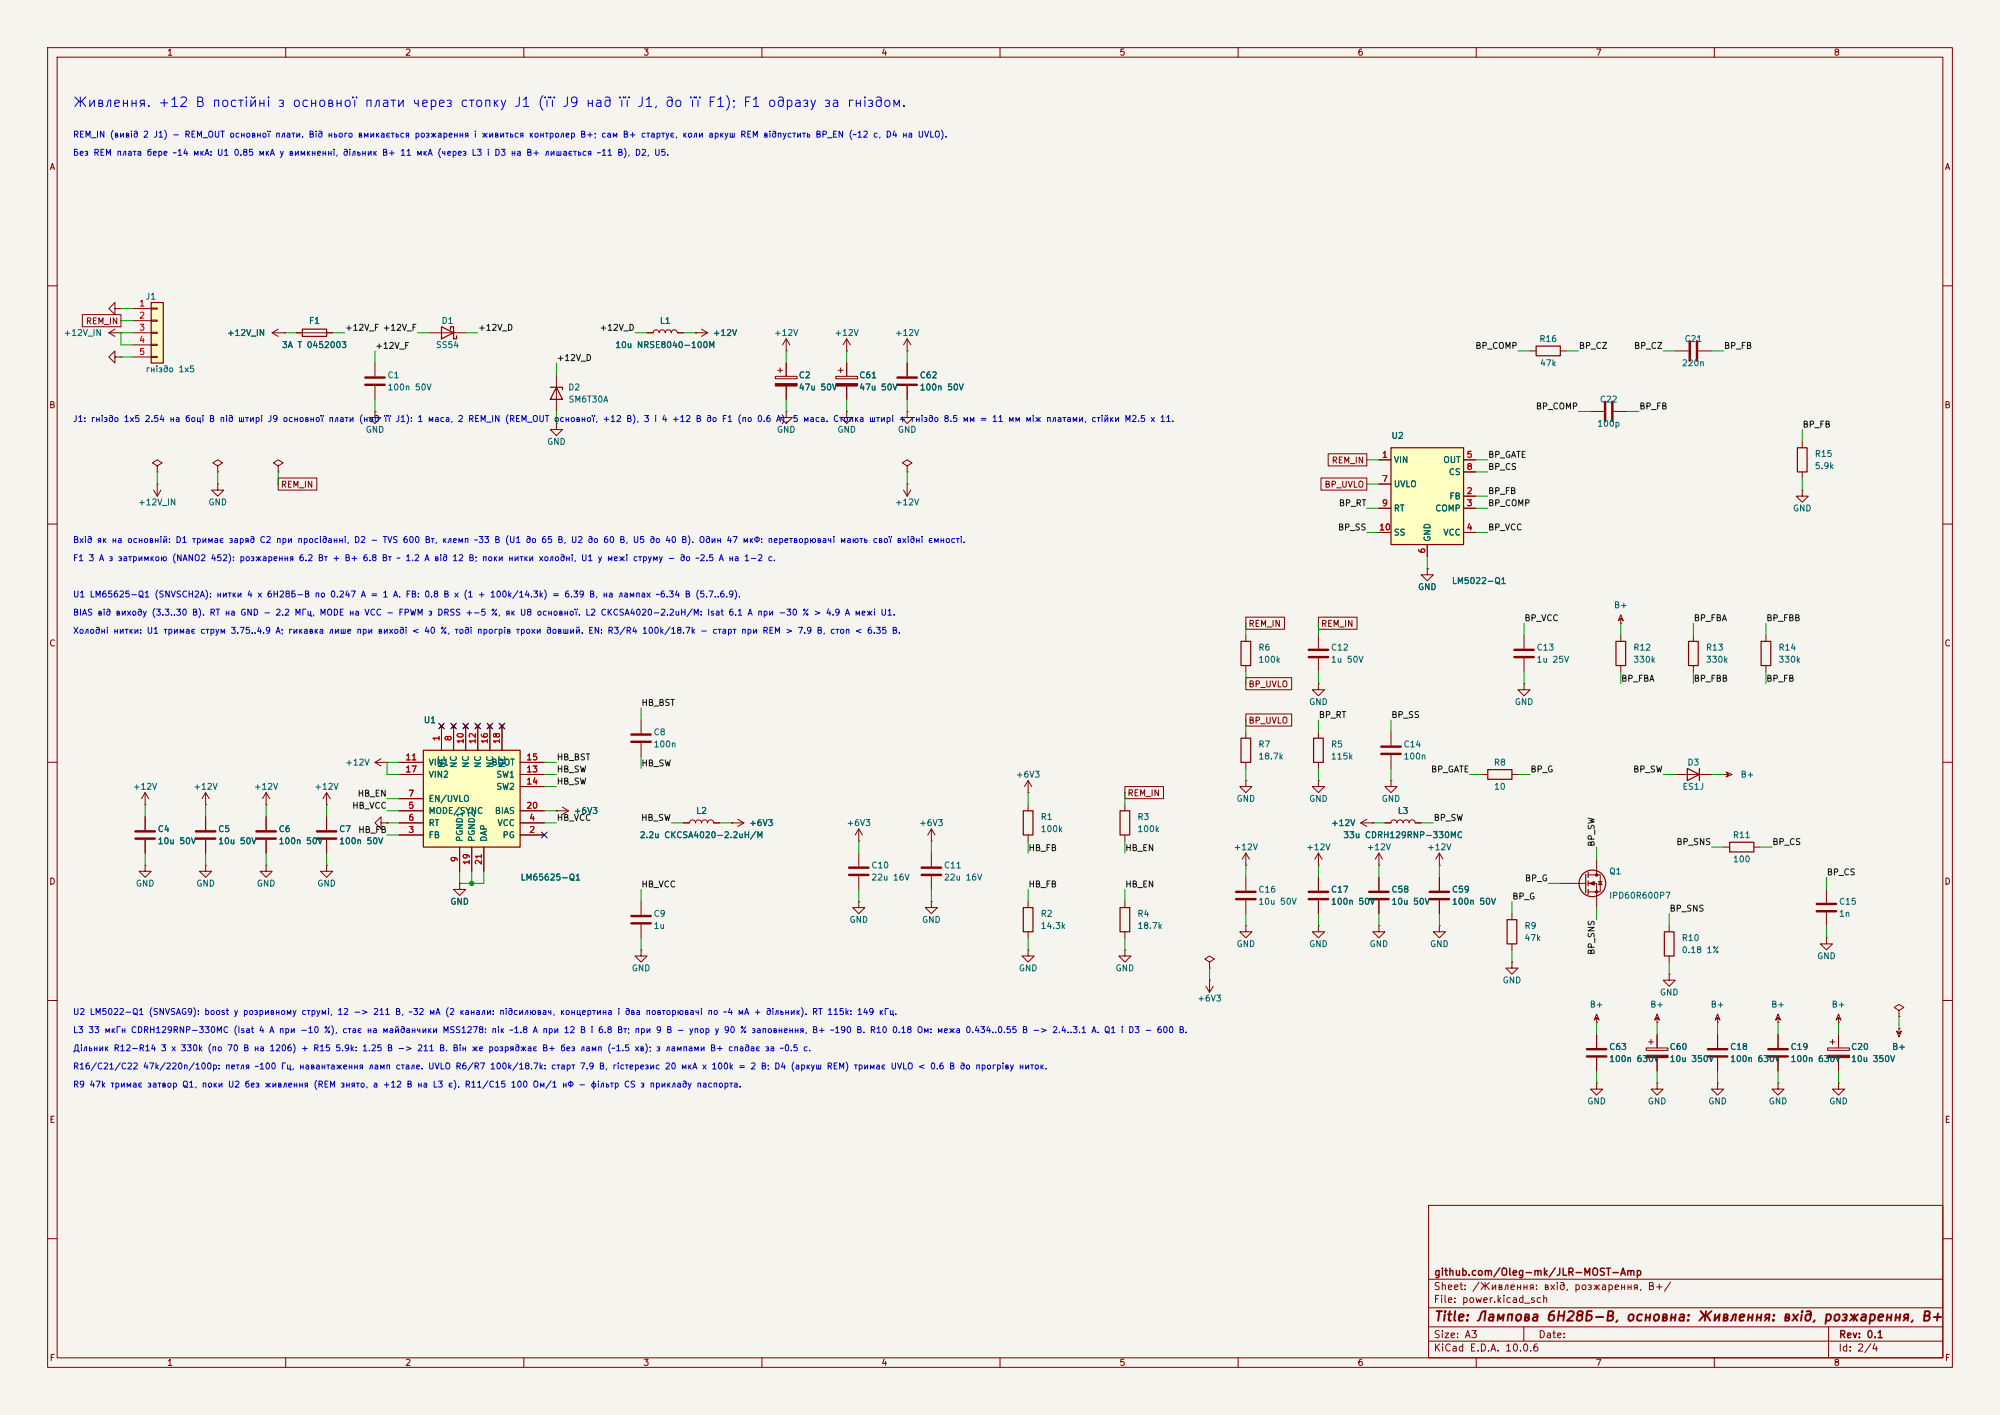
[picture p11: page 2]

Без REM плата бере ~14 мкА: U1 0.85 мкА у вимкненні, дільник B+ 11 мкА (через L3 і D3 на B+ лишається ~11 В), D2, U5. Живлення. +12 В постійні з основної плати через стопку J1 (її J9 над її J1, до її F1); F1 одразу за гніздом.

REM_IN (вивід 2 J1) - REM_OUT основної плати. Від нього вмикається розжарення і живиться контролер B+; сам B+ стартує, коли аркуш REM відпустить BP_EN (~12 с, D4 на UVLO).

BIAS від виходу (3.3..30 В). RT на GND - 2.2 МГц, MODE на VCC - FPWM з DRSS +-5 %, як U8 основної. L2 CKCSA4020-2.2uH/M: Isat 6.1 А при -30 % > 4.9 А межі U1. Холодні нитки: U1 тримає струм 3.75..4.9 А; гикавка лише при виході < 40 %, тоді прогрів трохи довший. EN: R3/R4 100k/18.7k - старт при REM > 7.9 В, стоп < 6.35 В. U1 LM65625-Q1 (SNVSCH2A): нитки 4 x 6Н28Б-В по 0.247 А = 1 А. FB: 0.8 В x (1 + 100k/14.3k) = 6.39 В, на лампах ~6.34 В (5.7..6.9).

U2 LM5022-Q1 (SNVSAG9): boost у розривному струмі, 12 -> 211 В, ~32 мА (2 канали: підсилювач, концертина і два повторювачі по ~4 мА + дільник). RT 115k: 149 кГц.

L3 33 мкГн CDRH129RNP-330MC (Isat 4 А при -10 %), стає на майданчики MSS1278: пік ~1.8 А при 12 В і 6.8 Вт; при 9 В - упор у 90 % заповнення, B+ ~190 В. R10 0.18 Ом: межа 0.434..0.55 В -> 2.4..3.1 А. Q1 і D3 - 600 В. R16/C21/C22 47k/220n/100p: петля ~100 Гц, навантаження ламп стале. UVLO R6/R7 100k/18.7k: старт 7.9 В, гістерезис 20 мкА x 100k = 2 В; D4 (аркуш REM) тримає UVLO < 0.6 В до прогріву ниток.

Дільник R12-R14 3 x 330k (по 70 В на 1206) + R15 5.9k: 1.25 В -> 211 В. Він же розряджає B+ без ламп (~1.5 хв); з лампами B+ спадає за ~0.5 с. R9 47k тримає затвор Q1, поки U2 без живлення (REM знято, а +12 В на L3 є). R11/C15 100 Ом/1 нФ - фільтр CS з прикладу паспорта.

github.com/Oleg-mk/JLR-MOST-Amp

Sheet: /Живлення: вхід, розжарення, B+/
File: power.kicad_sch
Title: Лампова 6Н28Б-В, основна: Живлення: вхід, розжарення, B+

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
# Title: Лампова 6Н28Б-В, основна: REM: нитки, B+, підсилювач

File: rem.kicad_sch

Sheet: /REM: нитки, B+, підсилювач/

## github.com/Oleg-mk/JLR-MOST-Amp

R19

10k C27

100n 50V GND

GND

C56

1.5u 10V GND

IN 1

EN 2 | GND

3 OUT 6 PAD

7 U3

TPS7B8133DRV C23

1u 50V GND | +3V3_REM

GND

R18

52.3k | C26

2.2u 10V GND

C24

2.2u +3V3_REM

GND

GND +3V3_REM | +3V3_REM

GND

RESET 1 GND

2 MR 3 CT 4

SENSE 5 | VDD

6 U4

TPS3808G01-Q1 C64

100n 50V GND

R17

1M

D4 BAT54W

IN 1 | DIAG_EN 2
FAULT | 3 CL 4 | DELAY 5 | GND

6 OUT VS
7

8 EP

9 U5

TPS1H200A-Q1

+3V3_REM

RESET 1 GND

2 MR 3 CT 4

SENSE 5 | VDD

6 U6

TPS3808G01-Q1 +3V3_REM

GND

GND

C25

100n +12V | C57
100n GND | +3V3_REM | +3V3_REM

R66

100k 1 | 2

J2

43045-0221 R20
10k +3V3_REM

GND

R21

4.02k | +12V REM_IN

REM_IN

REM_IN

BP_UVLO

REM_IN

REM_CL

REM_SENSE REM_CT2 REM_OUT | REM_CT REM_SENSE | REM_GO

REM_GO

REM_OUT

BP_EN

BP_EN

REM_CT2 REM_SENSE REM_GO

REM_DLY REM_CL REM_DLY | REM_CT | BP_EN

BP_EN

REM_OUT | REM_SENSE

J2: Micro-Fit 3.0 2x1 кутовий (43045-0221): 1 REM_OUT, 2 маса.

U3 живиться від REM_IN: без REM уся логіка без струму. U5 TPS1H200A-Q1, як U10 основної: межа 0.5 А (R21 4.02k), DELAY підтягнуто - при замиканні повторні спроби. J2 - REM на підсилювач. | після відпускання D4 закритий (UVLO 1.9..2.2 В < 3.3 В). SENSE нижче порогу - RESET у нулі за 20 мкс і до VDD 0.8 В. MR U4 вільний (90k до VDD всередині). U6 - другий TPS3808: MR від BP_EN, SENSE спільний з U4; відлік C56 1.5 мкФ -> ~8.6 с іде, коли B+ уже стоїть і вихідні конденсатори заряджені. RESET -> REM_GO -> U5. BP_EN - відкритий стік U4 з підтяжкою R66 100k до +3V3_REM. Поки він у нулі, D4 тримає UVLO U2 на ~0.5 В (< 1.25 В: бустер у standby, SS розряджений);

REM. Нитки вмикаються з REM_IN одразу; B+ - через ~12 с (U4 відпускає BP_EN, D4 звільняє UVLO бустера); REM_OUT на підсилювач - ще через ~9 с (U6, відлік від BP_EN). Вимкнення - одразу. Коли REM_IN зникає: обидва RESET у нулі за 20 мкс, U5 закривається за ~0.1 мс, REM_OUT спадає через C64 і вхід підсилювача (100 кОм: ~15 мс до 3 В), B+ сідає за ~0.5 с - лампи гаснуть з уже вимкненим підсилювачем. U4 TPS3808G01-Q1 (SBVS085J): SENSE 0.405 В, R17/R18 1M/52.3k -> REM_IN > 8.15 В. RESET відпускається через tD = CT / 175 нФ: C26 2.2 мкФ -> ~12.6 с, у межах паспорта.

C64 при J2: ВЧ із кабелю REM на масу роз'єму. Вихід U5 наростає до 0.6 В/мкс, C64 бере до 60 мА - далеко до межі 0.5 А. | U6
TPS3808G01-Q1 RESET | 1 GND

2 MR 3 CT 4

SENSE 5 | VDD

6 +3V3_REM

GND U5

TPS1H200A-Q1

IN 1 | DIAG_EN 2
FAULT | 3 CL 4 | DELAY 5 | GND

6 OUT VS
7

8 EP

# 9 GND +12V GND U3

TPS7B8133DRV

IN 1

EN 2 | GND

3 OUT 6 PAD
7 +3V3_REM
GND | U4
TPS3808G01-Q1 RESET | 1 GND

2 MR 3 CT 4

SENSE 5 | VDD

6 +3V3_REM

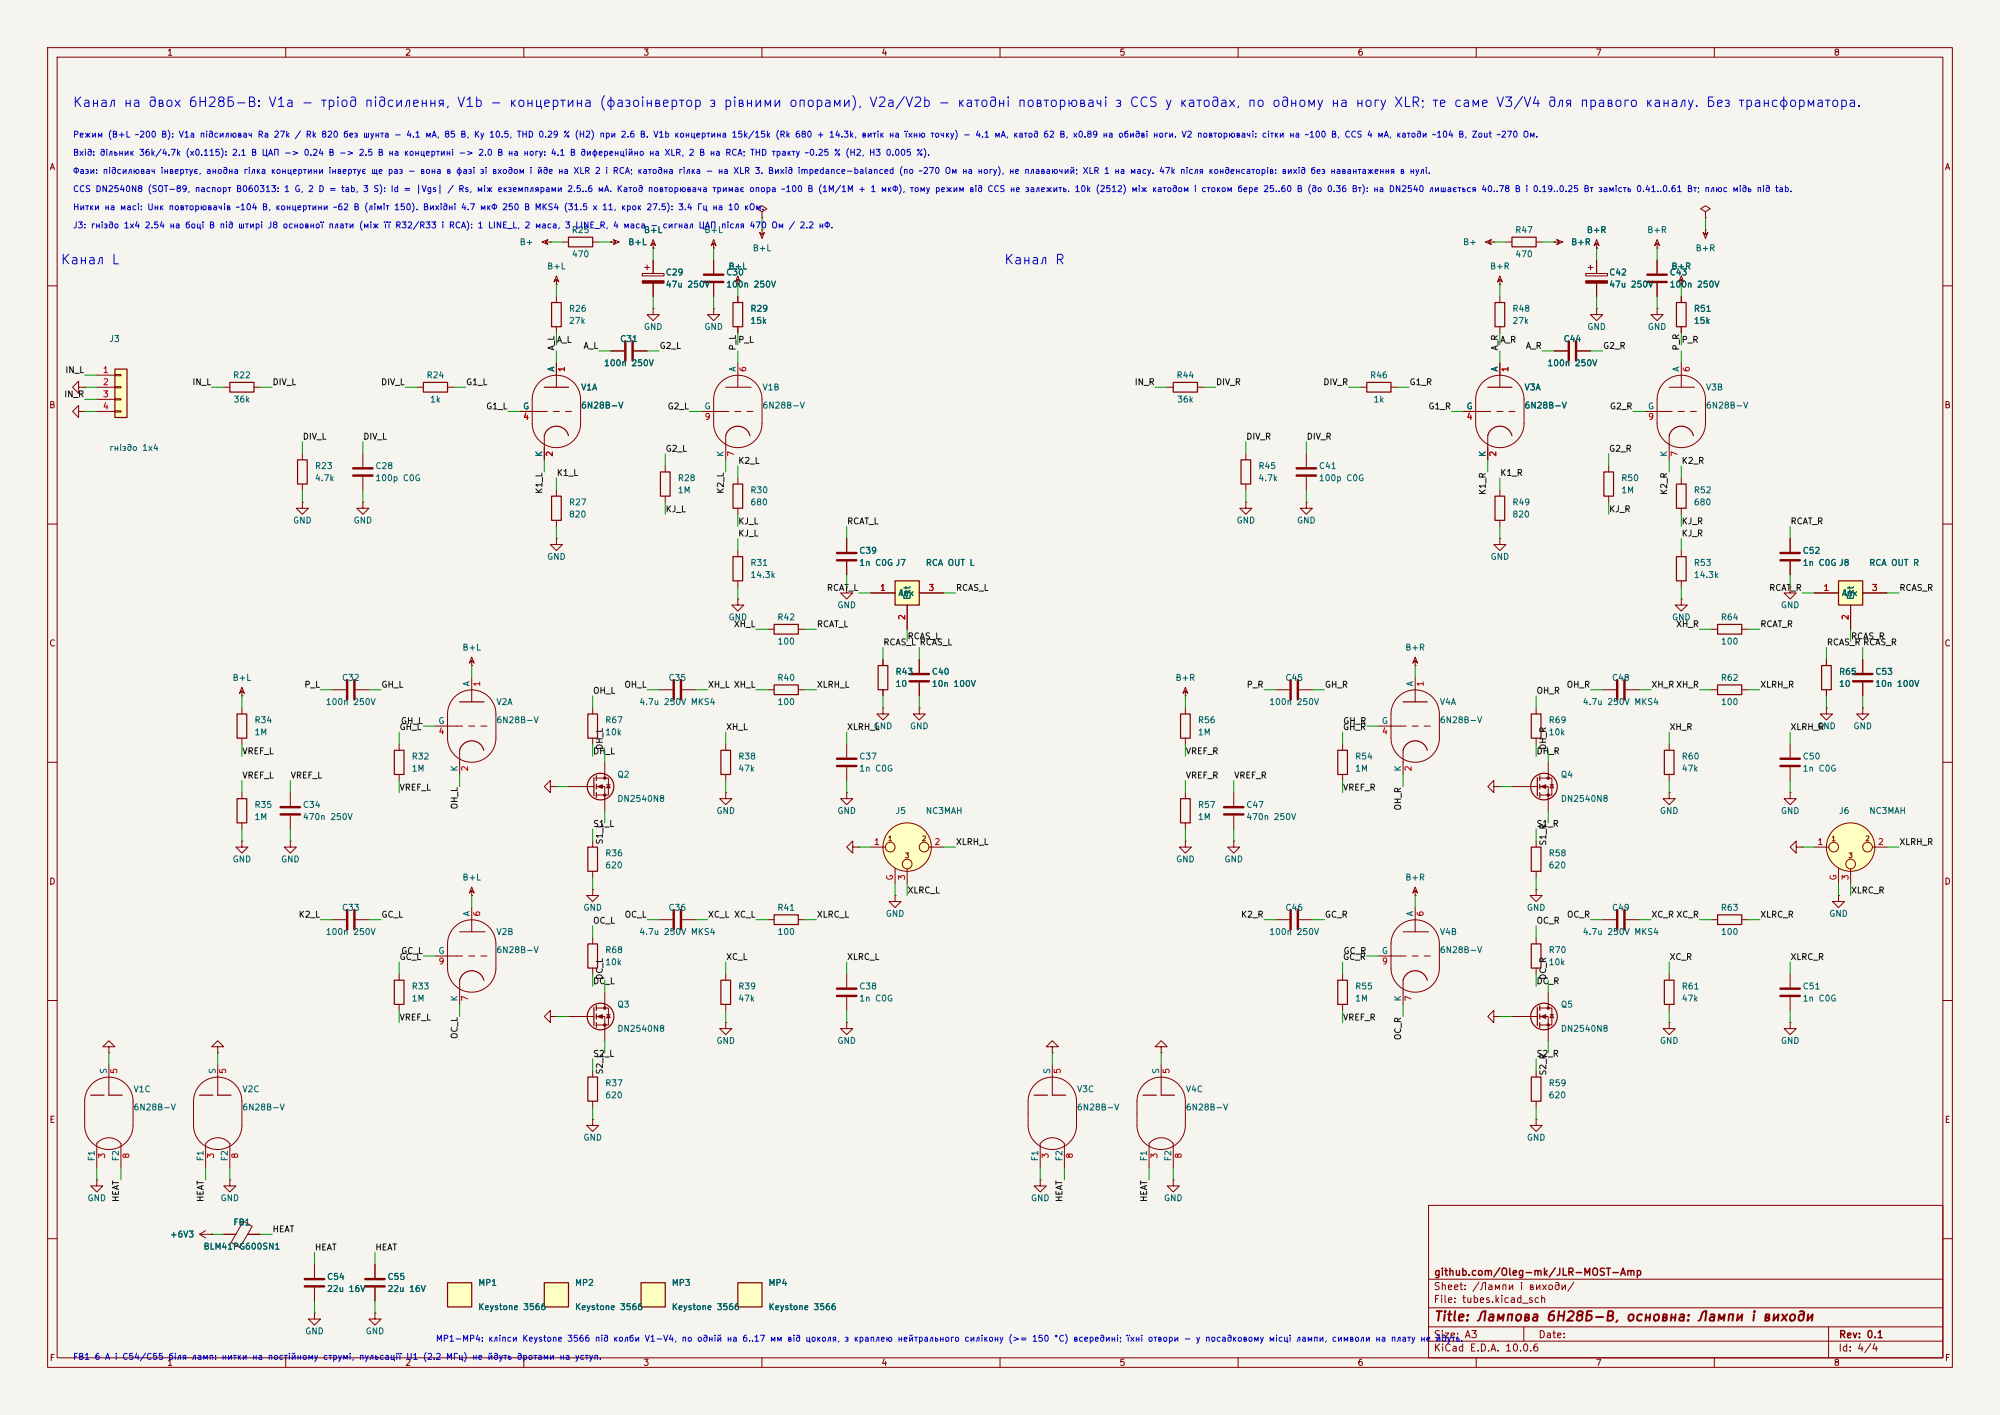
[picture p12: page 4]

Канал на двох 6Н28Б-В: V1a - тріод підсилення, V1b - концертина (фазоінвертор з рівними опорами), V2a/V2b - катодні повторювачі з CCS у катодах, по одному на ногу XLR; те саме V3/V4 для правого каналу. Без трансформатора. CCS DN2540N8 (SOT-89, паспорт B060313: 1 G, 2 D = tab, 3 S): Id = |Vgs| / Rs, між екземплярами 2.5..6 мА. Катод повторювача тримає опора ~100 В (1M/1M + 1 мкФ), тому режим від CCS не залежить. 10k (2512) між катодом і стоком бере 25..60 В (до 0.36 Вт): на DN2540 лишається 40..78 В і 0.19..0.25 Вт замість 0.41..0.61 Вт; плюс мідь під tab. Канал R

Вхід: дільник 36k/4.7k (x0.115): 2.1 В ЦАП -> 0.24 В -> 2.5 В на концертині -> 2.0 В на ногу: 4.1 В диференційно на XLR, 2 В на RCA; THD тракту ~0.25 % (H2, H3 0.005 %). Режим (B+L ~200 В): V1a підсилювач Ra 27k / Rk 820 без шунта - 4.1 мА, 85 В, Ку 10.5, THD 0.29 % (H2) при 2.6 В. V1b концертина 15k/15k (Rk 680 + 14.3k, витік на їхню точку) - 4.1 мА, катод 62 В, x0.89 на обидві ноги. V2 повторювачі: сітки на ~100 В, CCS 4 мА, катоди ~104 В, Zout ~270 Ом. Канал L

Фази: підсилювач інвертує, анодна гілка концертини інвертує ще раз - вона в фазі зі входом і йде на XLR 2 і RCA; катодна гілка - на XLR 3. Вихід impedance-balanced (по ~270 Ом на ногу), не плаваючий; XLR 1 на масу. 47k після конденсаторів: вихід без навантаження в нулі. Нитки на масі: Uнк повторювачів ~104 В, концертини ~62 В (ліміт 150). Вихідні 4.7 мкФ 250 В MKS4 (31.5 x 11, крок 27.5): 3.4 Гц на 10 кОм. J3: гніздо 1x4 2.54 на боці B під штирі J8 основної плати (між її R32/R33 і RCA): 1 LINE_L, 2 маса, 3 LINE_R, 4 маса - сигнал ЦАП після 470 Ом / 2.2 нФ.

github.com/Oleg-mk/JLR-MOST-Amp

Sheet: /Лампи і виходи/
File: tubes.kicad_sch
Title: Лампова 6Н28Б-В, основна: Лампи і виходи

MP1-MP4: кліпси Keystone 3566 під колби V1-V4, по одній на 6..17 мм від цоколя, з краплею нейтрального силікону (>= 150 °C) всередині; їхні отвори - у посадковому місці лампи, символи на плату не йдуть.

FB1 6 А і C54/C55 біля ламп: нитки на постійному струмі, пульсації U1 (2.2 МГц) не йдуть дротами на уступ.
