Oleg-mk/JLR-MOST-Amp/hw/production/Bitline-2L-assembly-bottom.pdf

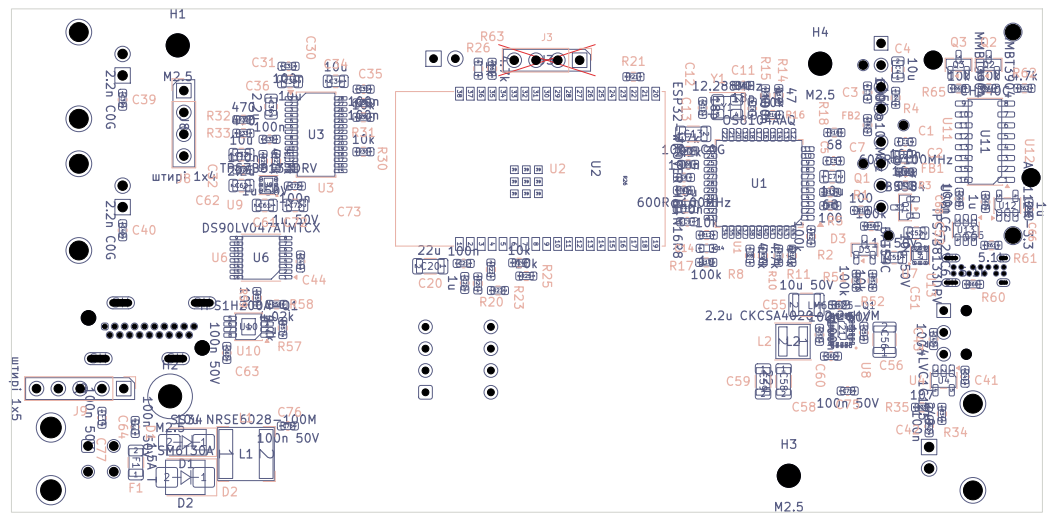
[picture p13: page 1]
