Oleg-mk/JLR-MOST-Amp/hw4/production/Bitline-4L-assembly-bottom.pdf

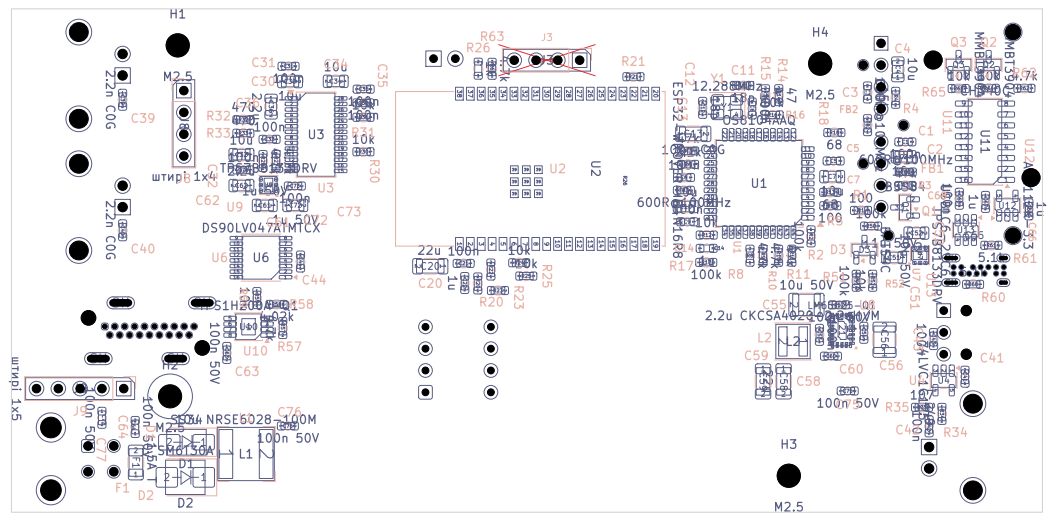
[picture p14: page 1]
