Oleg-mk/JLR-MOST-Amp/tube/6n16b/production/Bitline-tube-6N16B-assembly-bottom.pdf

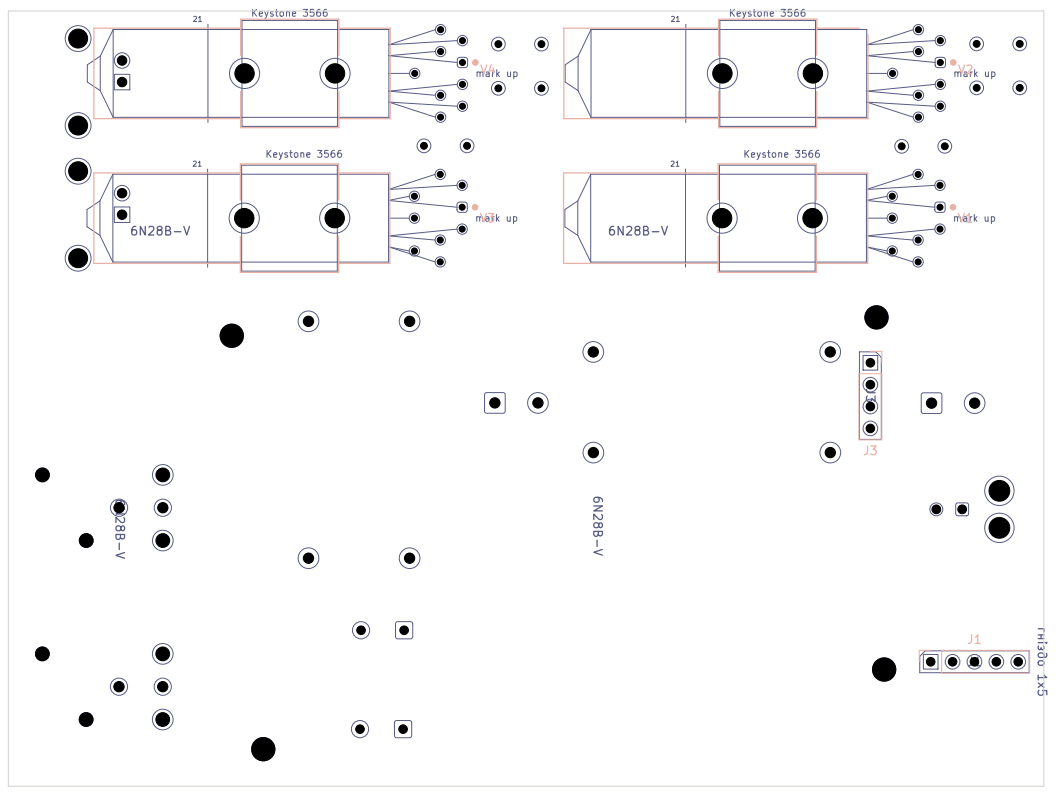
[picture p15: page 1]
