Oleg-mk/JLR-MOST-Amp/tube/6n16b/production/Bitline-tube-6N16B-assembly-top.pdf

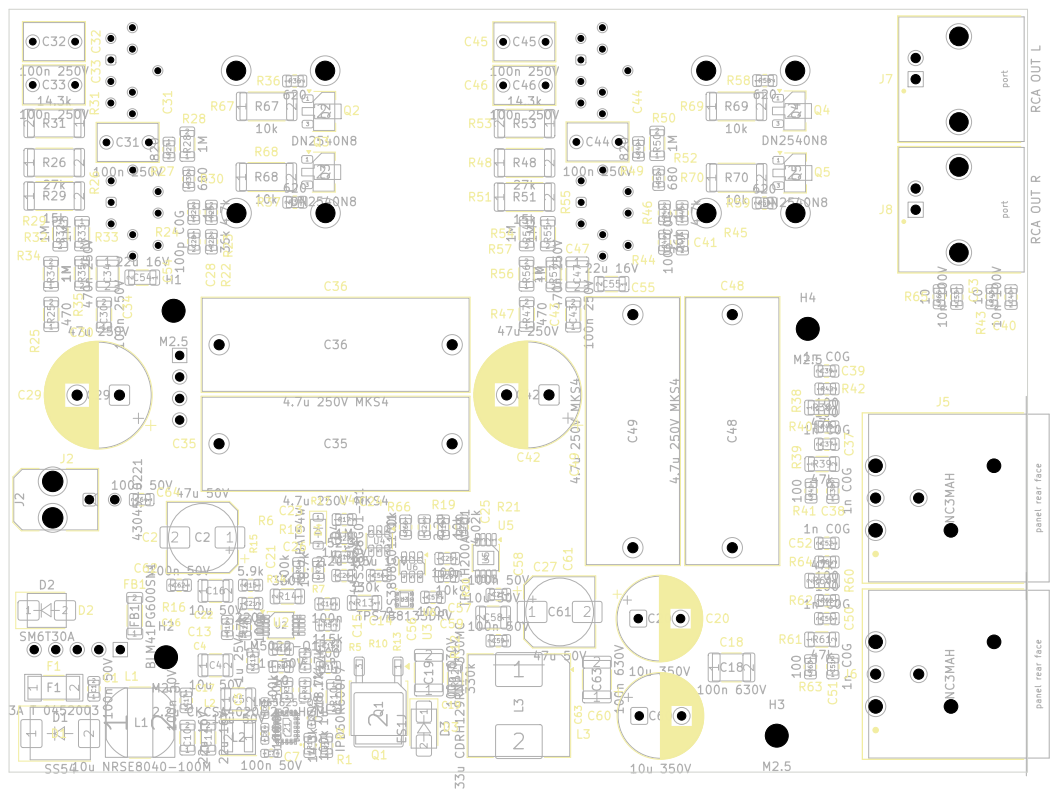
[picture p16: page 1]
