Oleg-mk/JLR-MOST-Amp/tube/6n28b/jlr_tube_6n28b.kicad_pcb

## KiCad design tube/6n28b/jlr_tube_6n28b.kicad_pcb (2026-11-08)

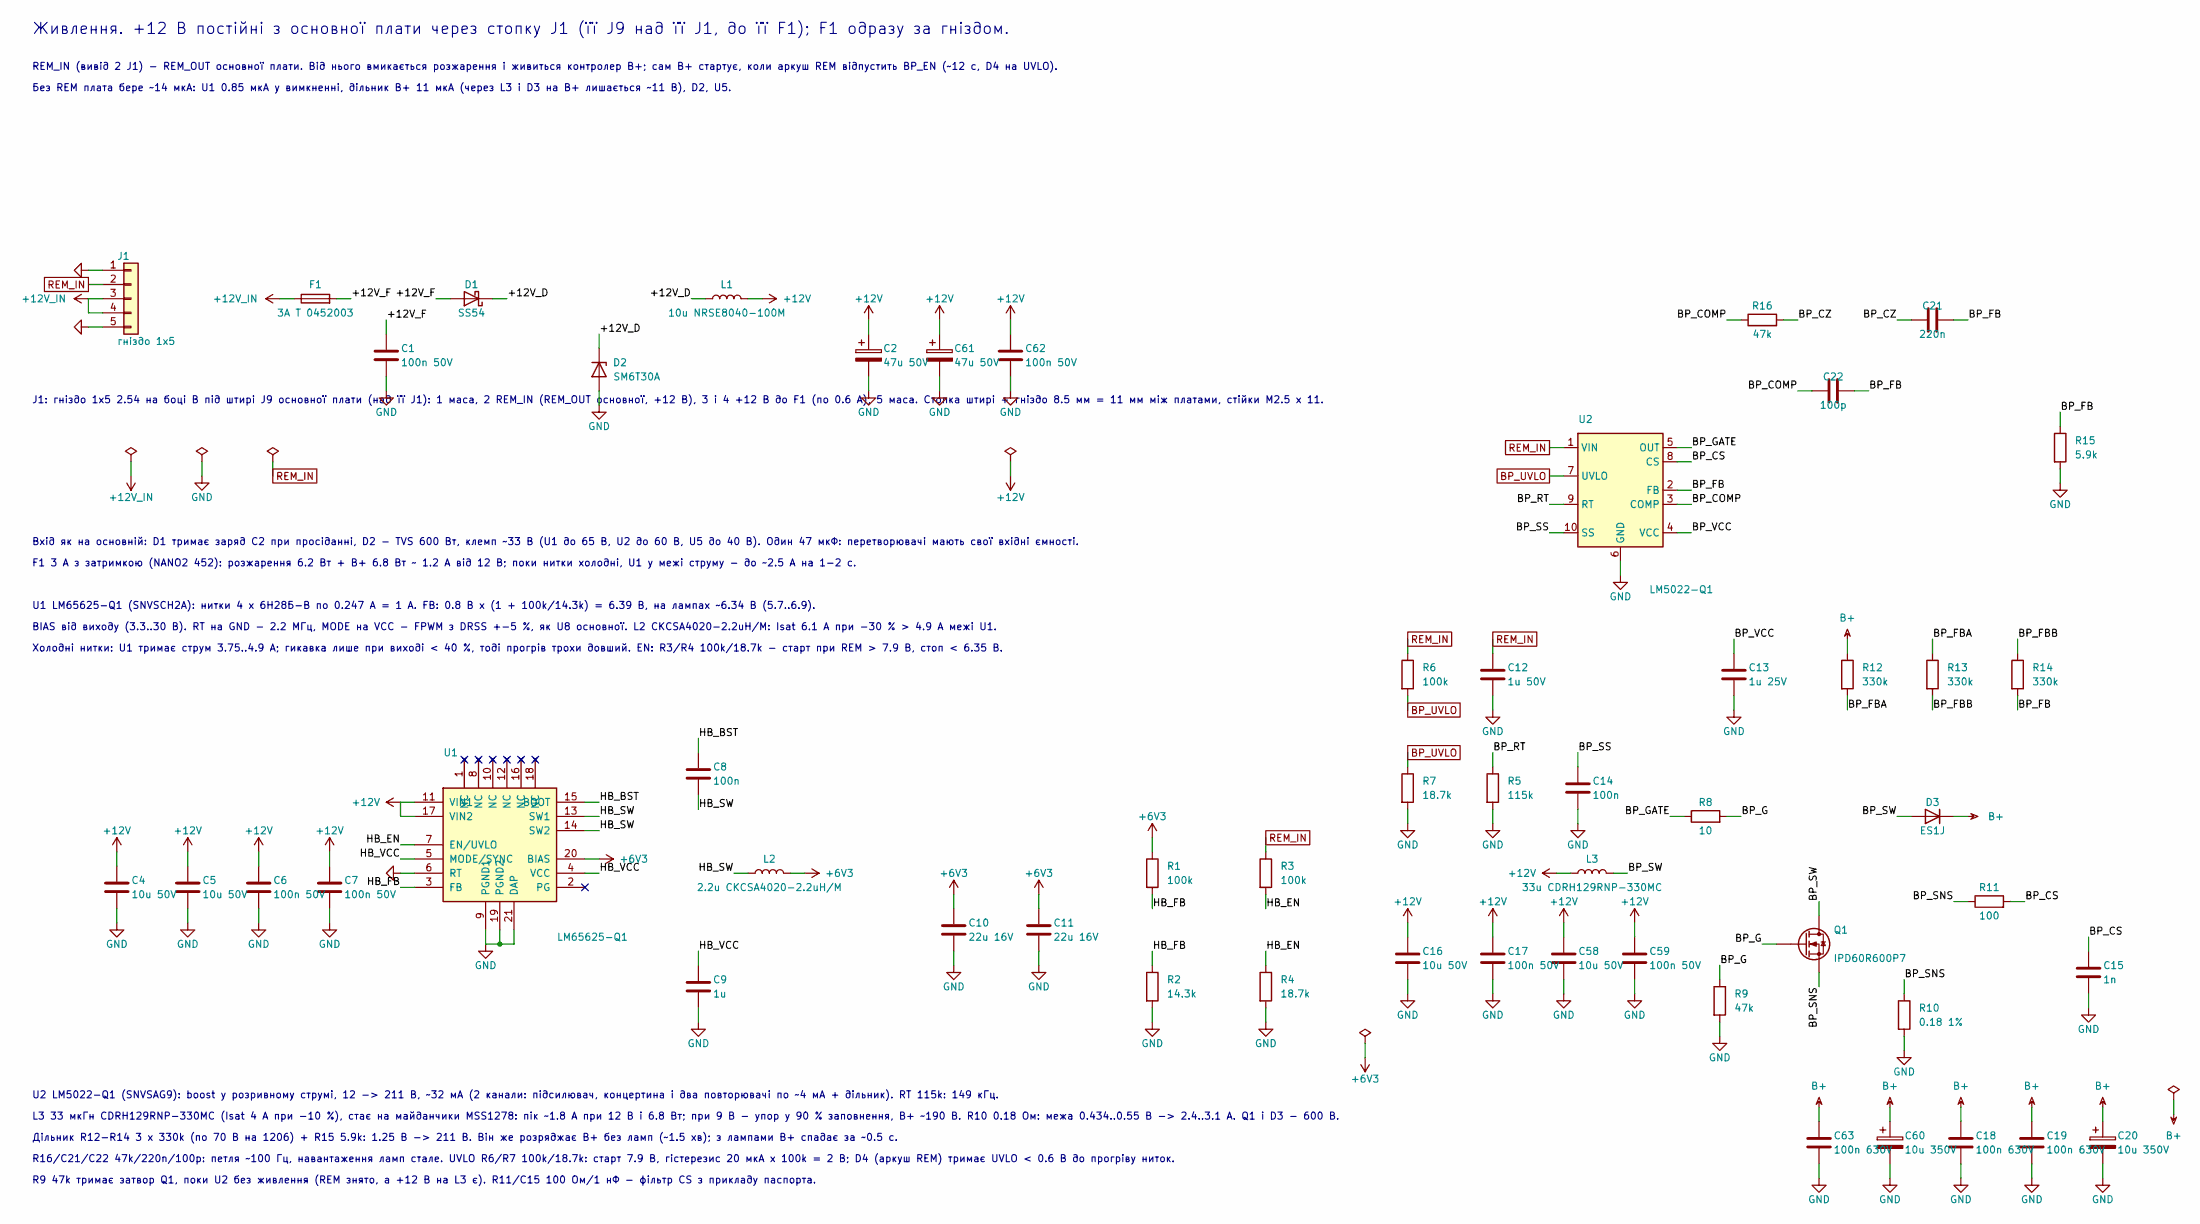
[picture p17: schematic power.kicad_sch, Лампова 6Н28Б-В, основна: Живлення: вхід, розжарення, B+]

Parts:
C1, C17, C59, C62: 100n 50V; C_0805_2012Metric
C2, C61: 47u 50V; CP_Elec_8x10
C4, C5, C16, C58: 10u 50V; C_1210_3225Metric
C6, C7: 100n 50V; C_0603_1608Metric
C8: 100n; C_0603_1608Metric
C9: 1u; C_0603_1608Metric
C10, C11: 22u 16V; C_1206_3216Metric
C12: 1u 50V; C_0805_2012Metric
C13: 1u 25V; C_0805_2012Metric
C14: 100n; C_0805_2012Metric
C15: 1n; C_0805_2012Metric
C18, C19, C63: 100n 630V; C_1812_4532Metric
C20, C60: 10u 350V; CP_Radial_D10.0mm_P5.00mm
C21: 220n; C_0805_2012Metric
C22: 100p; C_0805_2012Metric
D1: SS54; D_SMC
D2: SM6T30A; D_SMB
D3: ES1J; D_SMA
F1: 3A T 0452003; Fuse_Littelfuse-NANO2-451_453
J1: гніздо 1x5; PinSocket_1x05_P2.54mm_Vertical
L1: 10u NRSE8040-100M; L_Bourns-SRN8040_8x8.15mm
L2: 2.2u CKCSA4020-2.2uH/M; L_Coilcraft_XxL4030
L3: 33u CDRH129RNP-330MC; L_Coilcraft_MSS1278-XXX
Q1: IPD60R600P7; TO-252-2
R1, R3, R6: 100k; R_0805_2012Metric
R2: 14.3k; R_0805_2012Metric
R4, R7: 18.7k; R_0805_2012Metric
R5: 115k; R_0805_2012Metric
R8: 10; R_0805_2012Metric
R9, R16: 47k; R_0805_2012Metric
R10: 0.18 1%; R_1206_3216Metric
R11: 100; R_0805_2012Metric
R12, R13, R14: 330k; R_1206_3216Metric
R15: 5.9k; R_0805_2012Metric
U1: LM65625-Q1; TI_RZT0020A
U2: LM5022-Q1; MSOP-10_3x3mm_P0.5mm

Connections:
+6V3: C10.1, C11.1, L2.2, R1.1, U1.20 (BIAS); also elsewhere on the board
+12V: C2.1, C4.1, C5.1, C6.1, C7.1, C16.1, C17.1, C58.1, C59.1, C61.1, C62.1, L1.2, L3.1, U1.11 (VIN1), U1.17 (VIN2); also elsewhere on the board
+12V_IN: F1.1, J1.3, J1.4
/Живлення: вхід, розжарення, B+/+12V_D: D1.1 (K), D2.1 (K), L1.1
/Живлення: вхід, розжарення, B+/+12V_F: C1.1, D1.2 (A), F1.2
/Живлення: вхід, розжарення, B+/BP_COMP: C22.1, R16.1, U2.3 (COMP)
/Живлення: вхід, розжарення, B+/BP_CS: C15.1, R11.2, U2.8 (CS)
/Живлення: вхід, розжарення, B+/BP_CZ: C21.1, R16.2
/Живлення: вхід, розжарення, B+/BP_FB: C21.2, C22.2, R14.2, R15.1, U2.2 (FB)
/Живлення: вхід, розжарення, B+/BP_FBA: R12.2, R13.1
/Живлення: вхід, розжарення, B+/BP_FBB: R13.2, R14.1
/Живлення: вхід, розжарення, B+/BP_G: Q1.1 (G), R8.2, R9.1
/Живлення: вхід, розжарення, B+/BP_GATE: R8.1, U2.5 (OUT)
/Живлення: вхід, розжарення, B+/BP_RT: R5.1, U2.9 (RT)
/Живлення: вхід, розжарення, B+/BP_SNS: Q1.3 (S), R10.1, R11.1
/Живлення: вхід, розжарення, B+/BP_SS: C14.1, U2.10 (SS)
/Живлення: вхід, розжарення, B+/BP_SW: D3.2 (A), L3.2, Q1.2 (D)
/Живлення: вхід, розжарення, B+/BP_VCC: C13.1, U2.4 (VCC)
/Живлення: вхід, розжарення, B+/HB_BST: C8.1, U1.15 (BOOT)
/Живлення: вхід, розжарення, B+/HB_EN: R3.2, R4.1, U1.7 (EN/UVLO)
/Живлення: вхід, розжарення, B+/HB_FB: R1.2, R2.1, U1.3 (FB)
/Живлення: вхід, розжарення, B+/HB_SW: C8.2, L2.1, U1.13 (SW1), U1.14 (SW2)
/Живлення: вхід, розжарення, B+/HB_VCC: C9.1, U1.4 (VCC), U1.5 (MODE/SYNC)
B+: C18.1, C19.1, C20.1, C60.1, C63.1, D3.1 (K), R12.1; also elsewhere on the board
BP_UVLO: R6.2, R7.1, U2.7 (UVLO); also elsewhere on the board
GND: C1.2, C2.2, C4.2, C5.2, C6.2, C7.2, C9.2, C10.2, C11.2, C12.2, C13.2, C14.2, C15.2, C16.2, C17.2, C18.2, C19.2, C20.2, C58.2, C59.2, C60.2, C61.2, C62.2, C63.2, D2.2 (A), J1.1, J1.5, R2.2, R4.2, R5.2, R7.2, R9.2, R10.2, R15.2, U1.6 (RT), U1.9 (PGND1), U1.19 (PGND2), U1.21 (DAP), U2.6 (GND); also elsewhere on the board
REM_IN: C12.1, J1.2, R3.1, R6.1, U2.1 (VIN); also elsewhere on the board

Notes on the sheet:
Живлення. +12 В постійні з основної плати через стопку J1 (її J9 над її J1, до її F1); F1 одразу за гніздом.
REM_IN (вивід 2 J1) - REM_OUT основної плати. Від нього вмикається розжарення і живиться контролер B+; сам B+ стартує, коли аркуш REM відпустить BP_EN (~12 с, D4 на UVLO).
Без REM плата бере ~14 мкА: U1 0.85 мкА у вимкненні, дільник B+ 11 мкА (через L3 і D3 на B+ лишається ~11 В), D2, U5.
J1: гніздо 1x5 2.54 на боці B під штирі J9 основної плати (над її J1): 1 маса, 2 REM_IN (REM_OUT основної, +12 В), 3 і 4 +12 В до F1 (по 0.6 А), 5 маса. Стопка штирі + гніздо 8.5 мм = 11 мм між платами, стійки M2.5 x 11.
Вхід як на основній: D1 тримає заряд C2 при просіданні, D2 - TVS 600 Вт, клемп ~33 В (U1 до 65 В, U2 до 60 В, U5 до 40 В). Один 47 мкФ: перетворювачі мають свої вхідні ємності.
F1 3 А з затримкою (NANO2 452): розжарення 6.2 Вт + B+ 6.8 Вт ~ 1.2 А від 12 В; поки нитки холодні, U1 у межі струму - до ~2.5 А на 1-2 с.
U1 LM65625-Q1 (SNVSCH2A): нитки 4 x 6Н28Б-В по 0.247 А = 1 А. FB: 0.8 В x (1 + 100k/14.3k) = 6.39 В, на лампах ~6.34 В (5.7..6.9).
BIAS від виходу (3.3..30 В). RT на GND - 2.2 МГц, MODE на VCC - FPWM з DRSS +-5 %, як U8 основної. L2 CKCSA4020-2.2uH/M: Isat 6.1 А при -30 % > 4.9 А межі U1.
Холодні нитки: U1 тримає струм 3.75..4.9 А; гикавка лише при виході < 40 %, тоді прогрів трохи довший. EN: R3/R4 100k/18.7k - старт при REM > 7.9 В, стоп < 6.35 В.
U2 LM5022-Q1 (SNVSAG9): boost у розривному струмі, 12 -> 211 В, ~32 мА (2 канали: підсилювач, концертина і два повторювачі по ~4 мА + дільник). RT 115k: 149 кГц.
L3 33 мкГн CDRH129RNP-330MC (Isat 4 А при -10 %), стає на майданчики MSS1278: пік ~1.8 А при 12 В і 6.8 Вт; при 9 В - упор у 90 % заповнення, B+ ~190 В. R10 0.18 Ом: межа 0.434..0.55 В -> 2.4..3.1 А. Q1 і D3 - 600 В.
Дільник R12-R14 3 x 330k (по 70 В на 1206) + R15 5.9k: 1.25 В -> 211 В. Він же розряджає B+ без ламп (~1.5 хв); з лампами B+ спадає за ~0.5 с.
R16/C21/C22 47k/220n/100p: петля ~100 Гц, навантаження ламп стале. UVLO R6/R7 100k/18.7k: старт 7.9 В, гістерезис 20 мкА x 100k = 2 В; D4 (аркуш REM) тримає UVLO < 0.6 В до прогріву ниток.
R9 47k тримає затвор Q1, поки U2 без живлення (REM знято, а +12 В на L3 є). R11/C15 100 Ом/1 нФ - фільтр CS з прикладу паспорта.

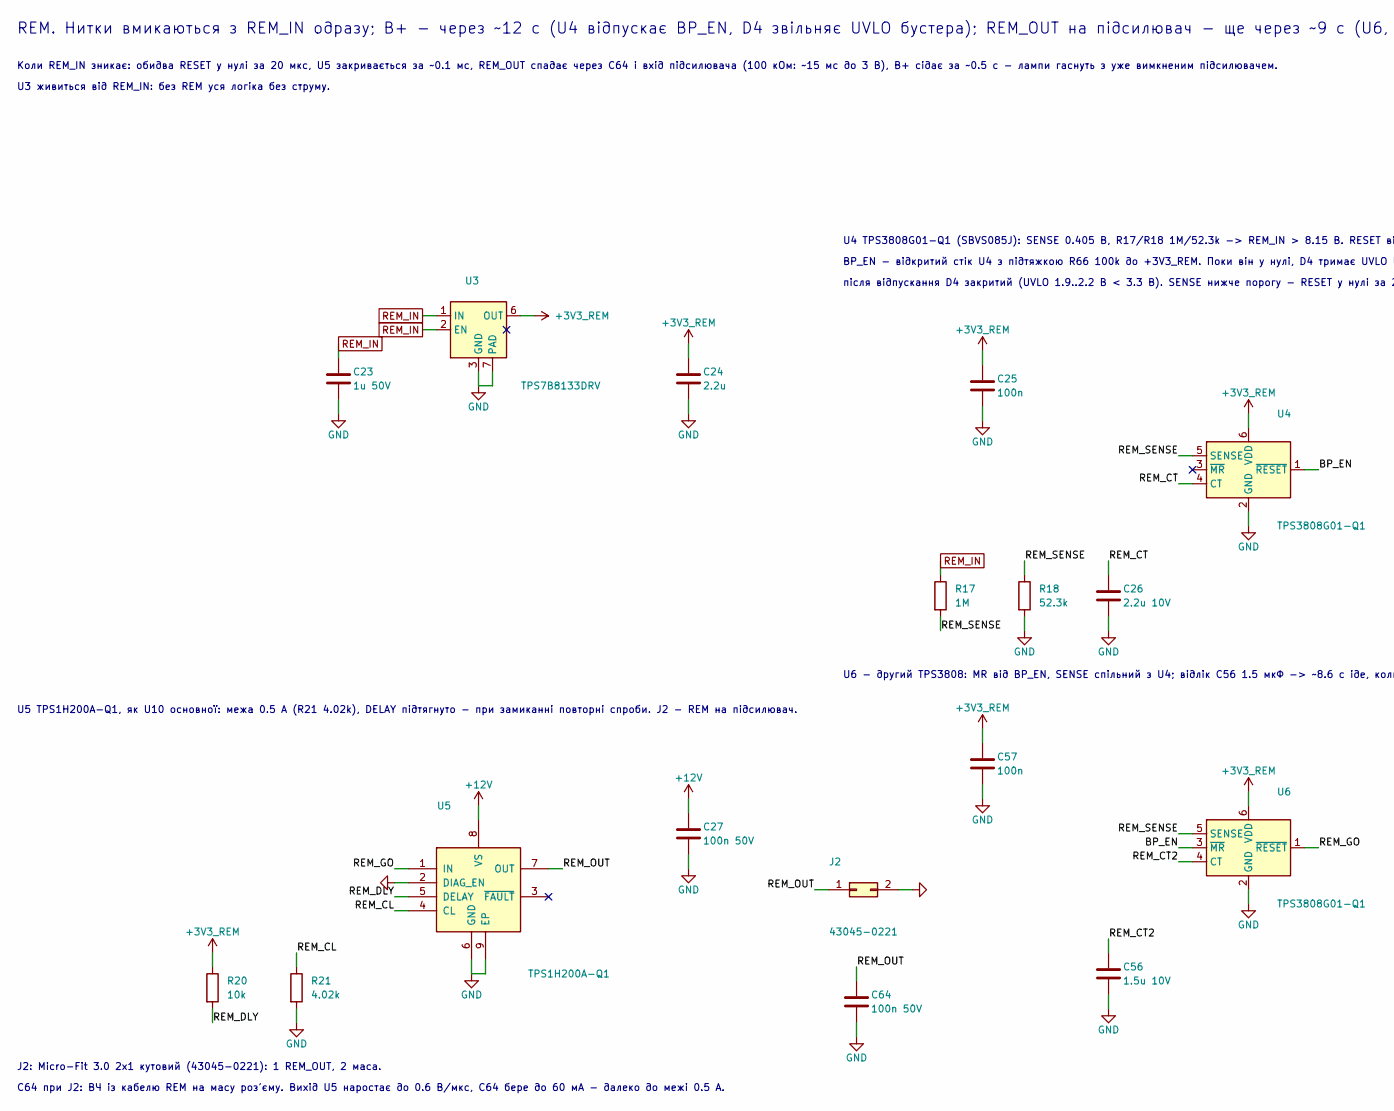
[picture p18: schematic rem.kicad_sch, Лампова 6Н28Б-В, основна: REM: нитки, B+, підсилювач, part in row 1, column 1]

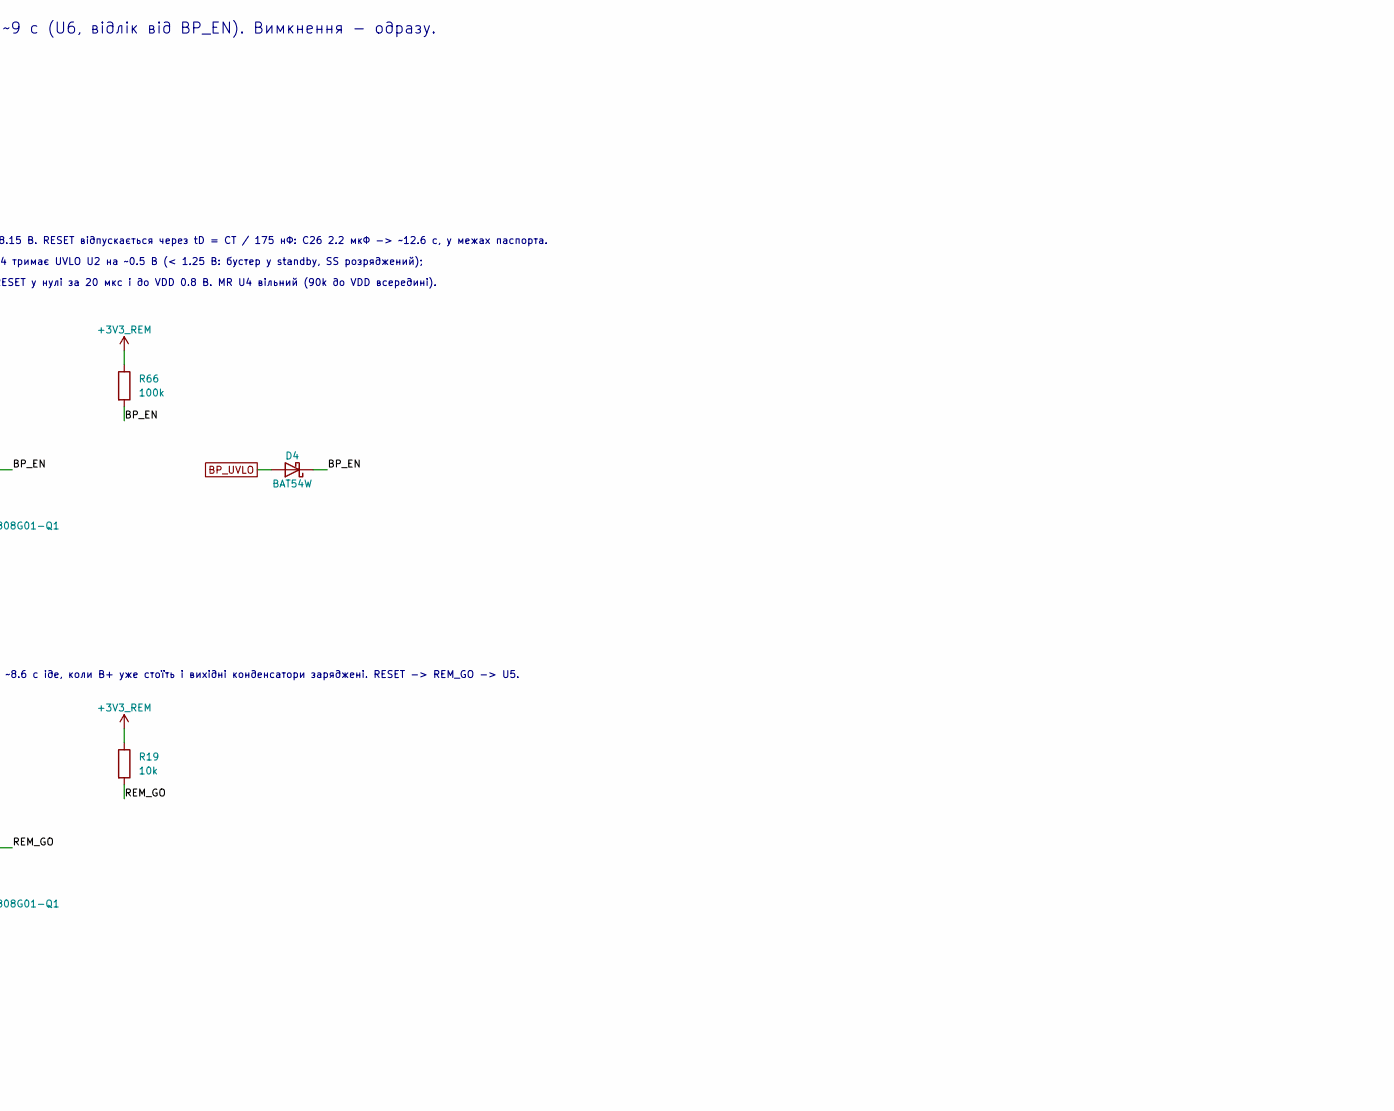
[picture p19: schematic rem.kicad_sch, Лампова 6Н28Б-В, основна: REM: нитки, B+, підсилювач, part in row 1, column 2]

Parts:
C23: 1u 50V; C_0805_2012Metric
C24: 2.2u; C_0805_2012Metric
C25, C57: 100n; C_0805_2012Metric
C26: 2.2u 10V; C_0805_2012Metric
C27, C64: 100n 50V; C_0805_2012Metric
C56: 1.5u 10V; C_0805_2012Metric
D4: BAT54W; D_SOD-123
J2: 43045-0221; Molex_Micro-Fit_3.0_43045-0221_2x01-1MP_P3.00mm_Horizontal
R17: 1M; R_0805_2012Metric
R18: 52.3k; R_0805_2012Metric
R19, R20: 10k; R_0805_2012Metric
R21: 4.02k; R_0805_2012Metric
R66: 100k; R_0805_2012Metric
U3: TPS7B8133DRV; WSON-6-1EP_2x2mm_P0.65mm_EP1x1.6mm
U4, U6: TPS3808G01-Q1; SOT-23-6
U5: TPS1H200A-Q1; HVSSOP-8-1EP_3x3mm_P0.65mm_EP1.57x1.89mm

Connections:
+3V3_REM: C24.1, C25.1, C57.1, R19.1, R20.1, R66.1, U3.6 (OUT), U4.6 (VDD), U6.6 (VDD)
+12V: C27.1, U5.8 (VS); also elsewhere on the board
/REM: нитки, B+, підсилювач/BP_EN: D4.1 (K), R66.2, U4.1 (~RESET), U6.3 (~MR)
/REM: нитки, B+, підсилювач/REM_CL: R21.1, U5.4 (CL)
/REM: нитки, B+, підсилювач/REM_CT: C26.1, U4.4 (CT)
/REM: нитки, B+, підсилювач/REM_CT2: C56.1, U6.4 (CT)
/REM: нитки, B+, підсилювач/REM_DLY: R20.2, U5.5 (DELAY)
/REM: нитки, B+, підсилювач/REM_GO: R19.2, U5.1 (IN), U6.1 (~RESET)
/REM: нитки, B+, підсилювач/REM_OUT: C64.1, J2.1, U5.7 (OUT)
/REM: нитки, B+, підсилювач/REM_SENSE: R17.2, R18.1, U4.5 (SENSE), U6.5 (SENSE)
BP_UVLO: D4.2 (A); also elsewhere on the board
GND: C23.2, C24.2, C25.2, C26.2, C27.2, C56.2, C57.2, C64.2, J2.2, R18.2, R21.2, U3.3 (GND), U3.4 (GND), U3.7 (PAD), U4.2 (GND), U5.2 (DIAG_EN), U5.6 (GND), U5.9 (EP), U6.2 (GND); also elsewhere on the board
REM_IN: C23.1, R17.1, U3.1 (IN), U3.2 (EN); also elsewhere on the board

Notes on the sheet:
REM. Нитки вмикаються з REM_IN одразу; B+ - через ~12 с (U4 відпускає BP_EN, D4 звільняє UVLO бустера); REM_OUT на підсилювач - ще через ~9 с (U6, відлік від BP_EN). Вимкнення - одразу.
Коли REM_IN зникає: обидва RESET у нулі за 20 мкс, U5 закривається за ~0.1 мс, REM_OUT спадає через C64 і вхід підсилювача (100 кОм: ~15 мс до 3 В), B+ сідає за ~0.5 с - лампи гаснуть з уже вимкненим підсилювачем.
U3 живиться від REM_IN: без REM уся логіка без струму.
U4 TPS3808G01-Q1 (SBVS085J): SENSE 0.405 В, R17/R18 1M/52.3k -> REM_IN > 8.15 В. RESET відпускається через tD = CT / 175 нФ: C26 2.2 мкФ -> ~12.6 с, у межах паспорта.
BP_EN - відкритий стік U4 з підтяжкою R66 100k до +3V3_REM. Поки він у нулі, D4 тримає UVLO U2 на ~0.5 В (< 1.25 В: бустер у standby, SS розряджений);
після відпускання D4 закритий (UVLO 1.9..2.2 В < 3.3 В). SENSE нижче порогу - RESET у нулі за 20 мкс і до VDD 0.8 В. MR U4 вільний (90k до VDD всередині).
U6 - другий TPS3808: MR від BP_EN, SENSE спільний з U4; відлік C56 1.5 мкФ -> ~8.6 с іде, коли B+ уже стоїть і вихідні конденсатори заряджені. RESET -> REM_GO -> U5.
U5 TPS1H200A-Q1, як U10 основної: межа 0.5 А (R21 4.02k), DELAY підтягнуто - при замиканні повторні спроби. J2 - REM на підсилювач.
J2: Micro-Fit 3.0 2x1 кутовий (43045-0221): 1 REM_OUT, 2 маса.
C64 при J2: ВЧ із кабелю REM на масу роз'єму. Вихід U5 наростає до 0.6 В/мкс, C64 бере до 60 мА - далеко до межі 0.5 А.

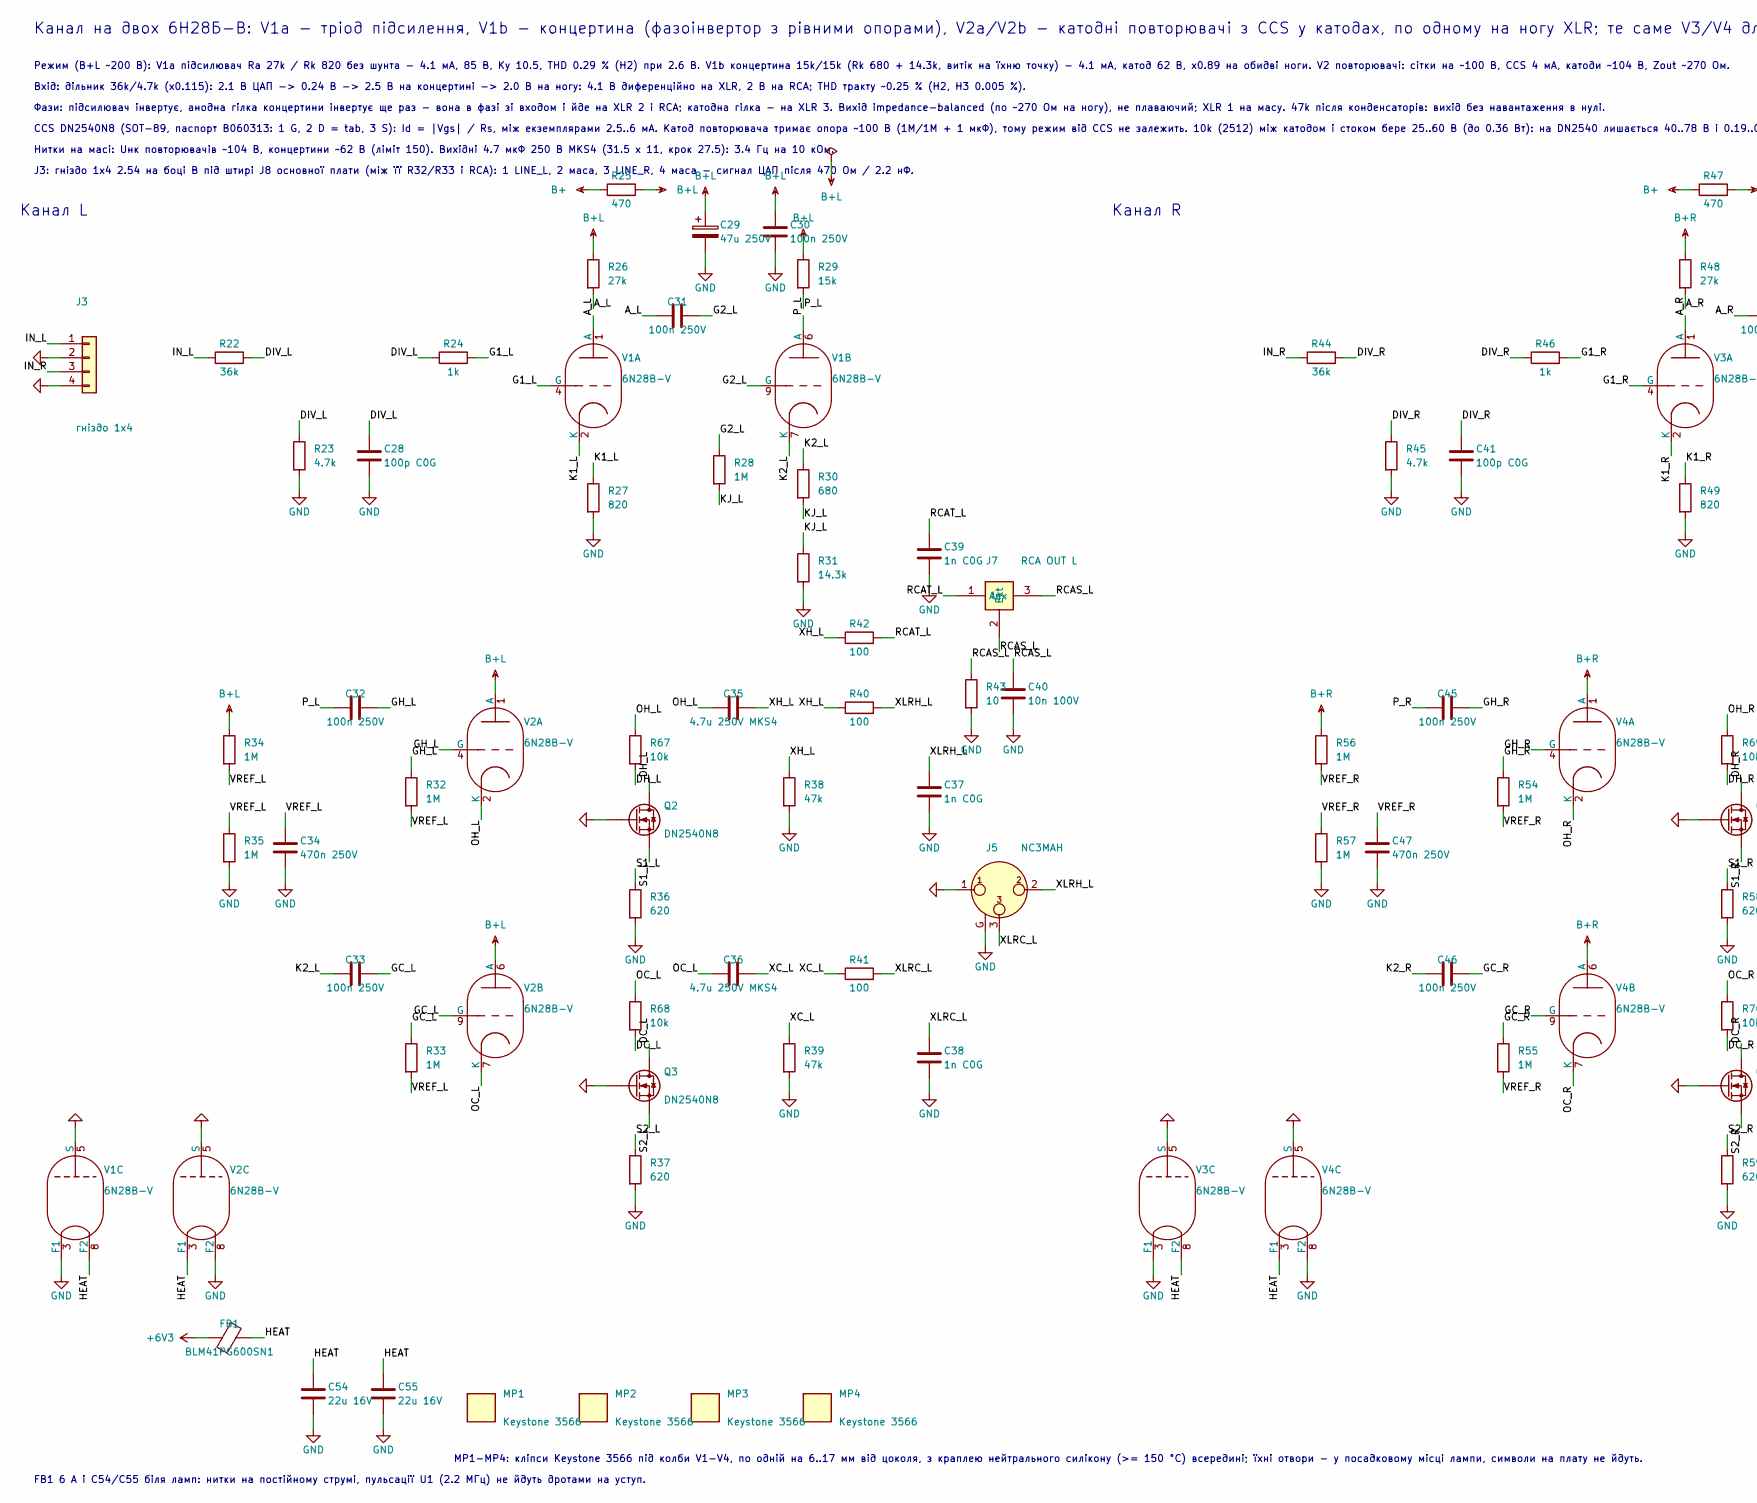
[picture p20: schematic tubes.kicad_sch, Лампова 6Н28Б-В, основна: Лампи і виходи, part in row 1, column 1]

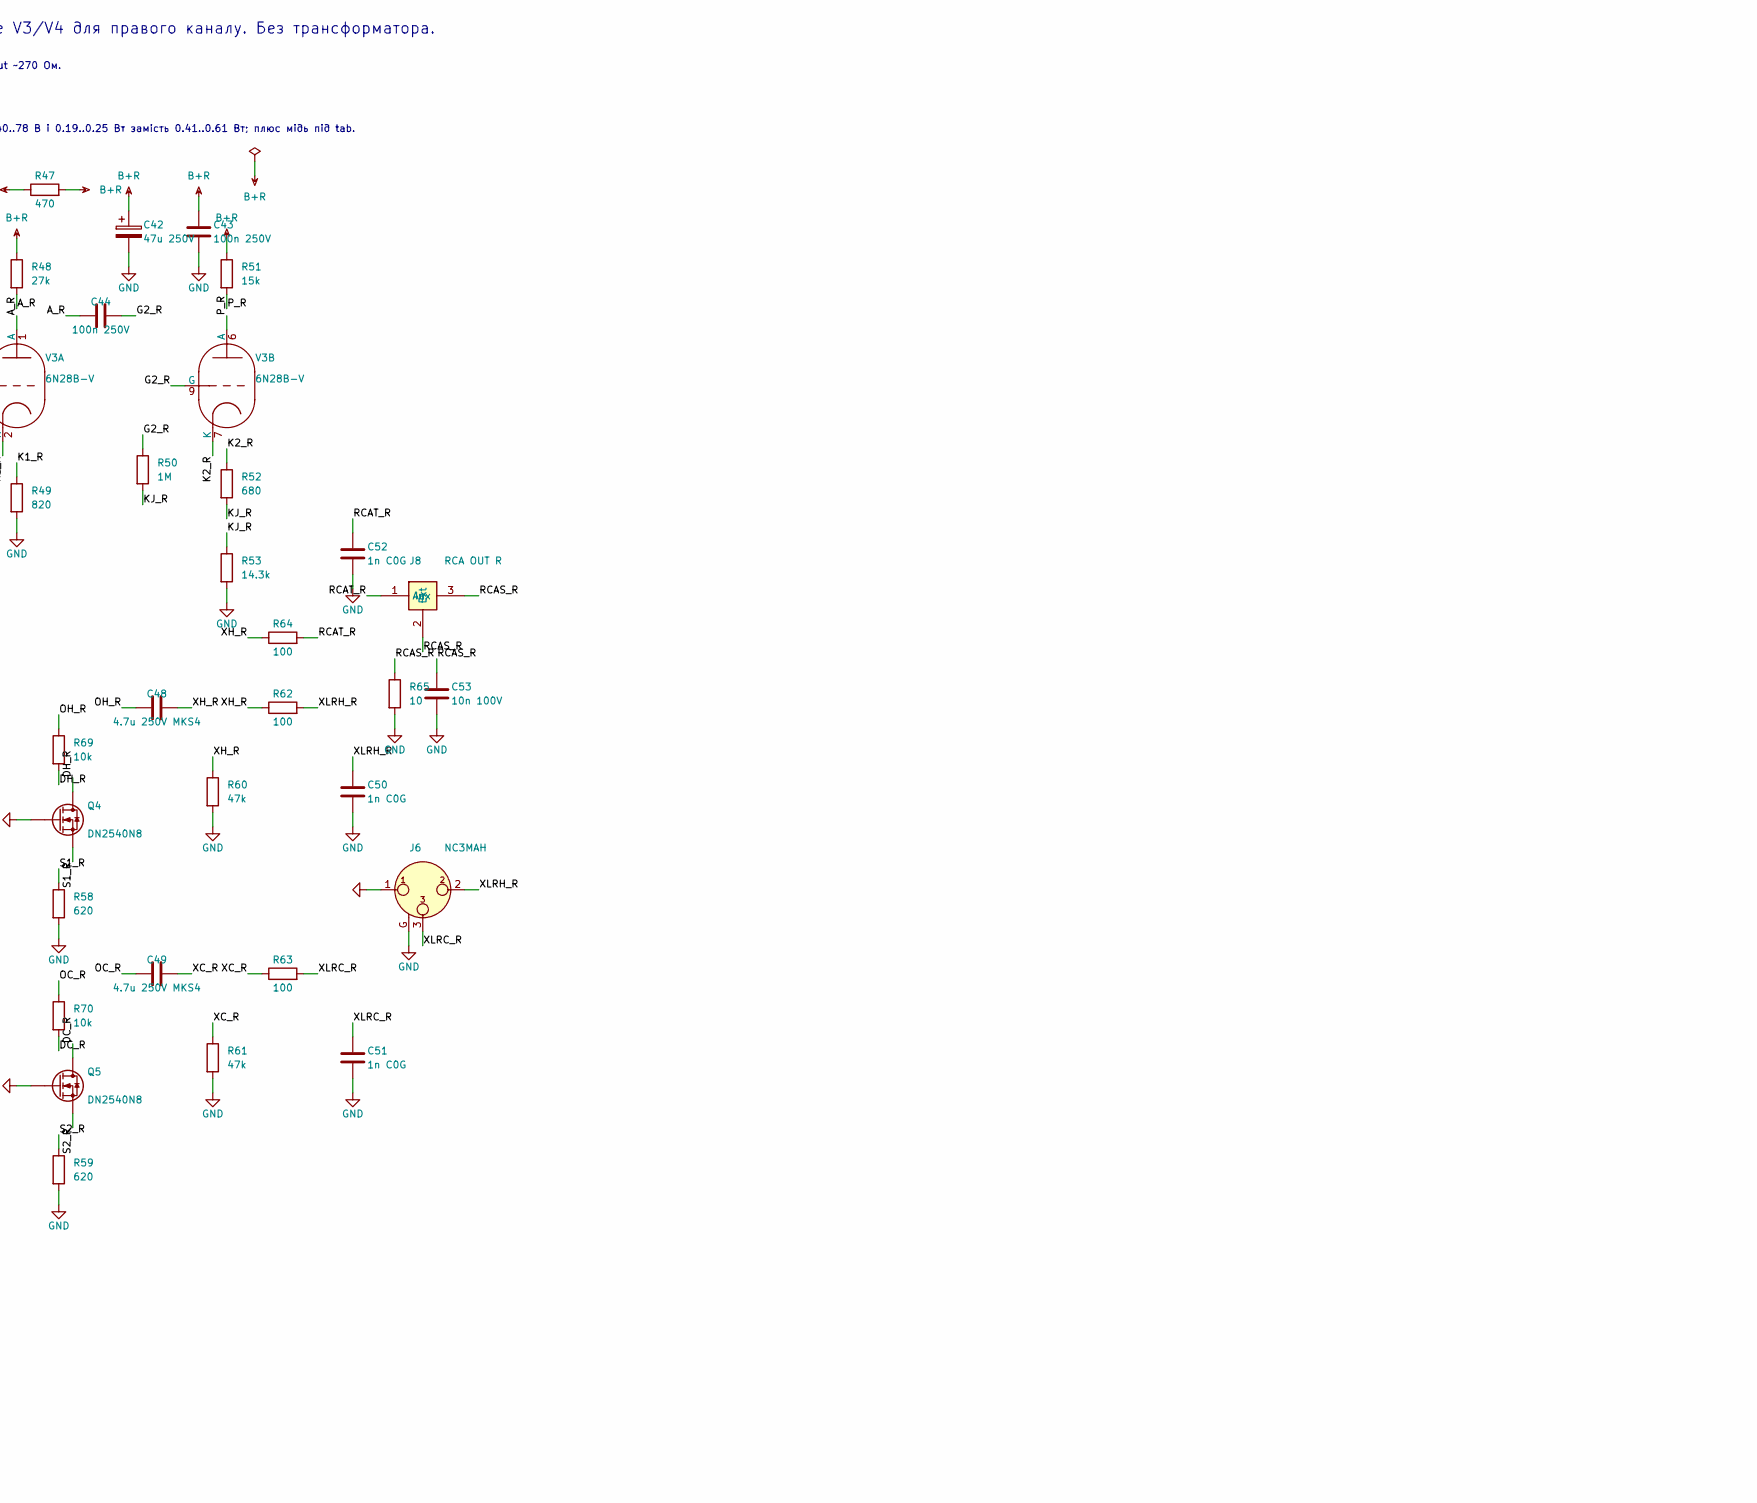
[picture p21: schematic tubes.kicad_sch, Лампова 6Н28Б-В, основна: Лампи і виходи, part in row 1, column 2]

Parts:
C28, C41: 100p C0G; C_0805_2012Metric
C29, C42: 47u 250V; CP_Radial_D12.5mm_P5.00mm
C30, C43: 100n 250V; C_1206_3216Metric
C31, C32, C33, C44, C45, C46: 100n 250V; C_Rect_L7.2mm_W4.5mm_P5.00mm_FKS2_FKP2_MKS2_MKP2
C34, C47: 470n 250V; C_1210_3225Metric
C35, C36, C48, C49: 4.7u 250V MKS4; C_Rect_L31.5mm_W11.0mm_P27.50mm_MKS4
C37, C38, C39, C50, C51, C52: 1n C0G; C_0805_2012Metric
C40, C53: 10n 100V; C_0805_2012Metric
C54, C55: 22u 16V; C_1206_3216Metric
FB1: BLM41PG600SN1; L_1806_4516Metric
J3: гніздо 1x4; PinSocket_1x04_P2.54mm_Vertical
J5, J6: NC3MAH; Neutrik_NC3MAH
J7: RCA OUT L; BKL_0101153_RCA_RA
J8: RCA OUT R; BKL_0101153_RCA_RA
MP1, MP2, MP3, MP4: Keystone 3566
Q2, Q3, Q4, Q5: DN2540N8; SOT-89-3
R22, R44: 36k; R_0805_2012Metric
R23, R45: 4.7k; R_0805_2012Metric
R24, R46: 1k; R_0805_2012Metric
R25, R47: 470; R_1206_3216Metric
R26, R48: 27k; R_2512_6332Metric
R27, R49: 820; R_0805_2012Metric
R28, R32, R33, R34, R35, R50, R54, R55, R56, R57: 1M; R_1206_3216Metric
R29, R51: 15k; R_2512_6332Metric
R30, R52: 680; R_0805_2012Metric
R31, R53: 14.3k; R_2512_6332Metric
R36, R37, R58, R59: 620; R_0805_2012Metric
R38, R39, R60, R61: 47k; R_1206_3216Metric
R40, R41, R42, R62, R63, R64: 100; R_0805_2012Metric
R43, R65: 10; R_0805_2012Metric
R67, R68, R69, R70: 10k; R_2512_6332Metric
V1, V3: 6N28B-V; Valve_6N28B-V_Flat_458
V2, V4: 6N28B-V; Valve_6N28B-V_Flat

Connections:
+6V3: FB1.1; also elsewhere on the board
/Лампи і виходи/A_L: C31.1, R26.2, V1.1 (A)
/Лампи і виходи/A_R: C44.1, R48.2, V3.1 (A)
/Лампи і виходи/DC_L: Q3.2 (D), R68.2
/Лампи і виходи/DC_R: Q5.2 (D), R70.2
/Лампи і виходи/DH_L: Q2.2 (D), R67.2
/Лампи і виходи/DH_R: Q4.2 (D), R69.2
/Лампи і виходи/DIV_L: C28.1, R22.2, R23.1, R24.1
/Лампи і виходи/DIV_R: C41.1, R44.2, R45.1, R46.1
/Лампи і виходи/G1_L: R24.2, V1.4 (G)
/Лампи і виходи/G1_R: R46.2, V3.4 (G)
/Лампи і виходи/G2_L: C31.2, R28.1, V1.9 (G)
/Лампи і виходи/G2_R: C44.2, R50.1, V3.9 (G)
/Лампи і виходи/GC_L: C33.2, R33.1, V2.9 (G)
/Лампи і виходи/GC_R: C46.2, R55.1, V4.9 (G)
/Лампи і виходи/GH_L: C32.2, R32.1, V2.4 (G)
/Лампи і виходи/GH_R: C45.2, R54.1, V4.4 (G)
/Лампи і виходи/HEAT: C54.1, C55.1, FB1.2, V1.8 (F2), V2.3 (F1), V3.8 (F2), V4.3 (F1)
/Лампи і виходи/IN_L: J3.1, R22.1
/Лампи і виходи/IN_R: J3.3, R44.1
/Лампи і виходи/K1_L: R27.1, V1.2 (K)
/Лампи і виходи/K1_R: R49.1, V3.2 (K)
/Лампи і виходи/K2_L: C33.1, R30.1, V1.7 (K)
/Лампи і виходи/K2_R: C46.1, R52.1, V3.7 (K)
/Лампи і виходи/KJ_L: R28.2, R30.2, R31.1
/Лампи і виходи/KJ_R: R50.2, R52.2, R53.1
/Лампи і виходи/OC_L: C36.1, R68.1, V2.7 (K)
/Лампи і виходи/OC_R: C49.1, R70.1, V4.7 (K)
/Лампи і виходи/OH_L: C35.1, R67.1, V2.2 (K)
/Лампи і виходи/OH_R: C48.1, R69.1, V4.2 (K)
/Лампи і виходи/P_L: C32.1, R29.2, V1.6 (A)
/Лампи і виходи/P_R: C45.1, R51.2, V3.6 (A)
/Лампи і виходи/RCAS_L: C40.1, J7.2 (Ext), J7.3 (Aux), R43.1
/Лампи і виходи/RCAS_R: C53.1, J8.2 (Ext), J8.3 (Aux), R65.1
/Лампи і виходи/RCAT_L: C39.1, J7.1 (In), R42.2
/Лампи і виходи/RCAT_R: C52.1, J8.1 (In), R64.2
/Лампи і виходи/S1_L: Q2.3 (S), R36.1
/Лампи і виходи/S1_R: Q4.3 (S), R58.1
/Лампи і виходи/S2_L: Q3.3 (S), R37.1
/Лампи і виходи/S2_R: Q5.3 (S), R59.1
/Лампи і виходи/VREF_L: C34.1, R32.2, R33.2, R34.2, R35.1
/Лампи і виходи/VREF_R: C47.1, R54.2, R55.2, R56.2, R57.1
/Лампи і виходи/XC_L: C36.2, R39.1, R41.1
/Лампи і виходи/XC_R: C49.2, R61.1, R63.1
/Лампи і виходи/XH_L: C35.2, R38.1, R40.1, R42.1
/Лампи і виходи/XH_R: C48.2, R60.1, R62.1, R64.1
/Лампи і виходи/XLRC_L: C38.1, J5.3, R41.2
/Лампи і виходи/XLRC_R: C51.1, J6.3, R63.2
/Лампи і виходи/XLRH_L: C37.1, J5.2, R40.2
/Лампи і виходи/XLRH_R: C50.1, J6.2, R62.2
B+: R25.1, R47.1; also elsewhere on the board
B+L: C29.1, C30.1, R25.2, R26.1, R29.1, R34.1, V2.1 (A), V2.6 (A)
B+R: C42.1, C43.1, R47.2, R48.1, R51.1, R56.1, V4.1 (A), V4.6 (A)
GND: C28.2, C29.2, C30.2, C34.2, C37.2, C38.2, C39.2, C40.2, C41.2, C42.2, C43.2, C47.2, C50.2, C51.2, C52.2, C53.2, C54.2, C55.2, J3.2, J3.4, J5.1, J5.G, J6.1, J6.G, Q2.1 (G), Q3.1 (G), Q4.1 (G), Q5.1 (G), R23.2, R27.2, R31.2, R35.2, R36.2, R37.2, R38.2, R39.2, R43.2, R45.2, R49.2, R53.2, R57.2, R58.2, R59.2, R60.2, R61.2, R65.2, V1.3 (F1), V1.5 (S), V2.5 (S), V2.8 (F2), V3.3 (F1), V3.5 (S), V4.5 (S), V4.8 (F2); also elsewhere on the board

Notes on the sheet:
Канал на двох 6Н28Б-В: V1a - тріод підсилення, V1b - концертина (фазоінвертор з рівними опорами), V2a/V2b - катодні повторювачі з CCS у катодах, по одному на ногу XLR; те саме V3/V4 для правого каналу. Без трансформатора.
Режим (B+L ~200 В): V1a підсилювач Ra 27k / Rk 820 без шунта - 4.1 мА, 85 В, Ку 10.5, THD 0.29 % (H2) при 2.6 В. V1b концертина 15k/15k (Rk 680 + 14.3k, витік на їхню точку) - 4.1 мА, катод 62 В, x0.89 на обидві ноги. V2 повторювачі: сітки на ~100 В, CCS 4 мА, катоди ~104 В, Zout ~270 Ом.
Вхід: дільник 36k/4.7k (x0.115): 2.1 В ЦАП -> 0.24 В -> 2.5 В на концертині -> 2.0 В на ногу: 4.1 В диференційно на XLR, 2 В на RCA; THD тракту ~0.25 % (H2, H3 0.005 %).
Фази: підсилювач інвертує, анодна гілка концертини інвертує ще раз - вона в фазі зі входом і йде на XLR 2 і RCA; катодна гілка - на XLR 3. Вихід impedance-balanced (по ~270 Ом на ногу), не плаваючий; XLR 1 на масу. 47k після конденсаторів: вихід без навантаження в нулі.
CCS DN2540N8 (SOT-89, паспорт B060313: 1 G, 2 D = tab, 3 S): Id = |Vgs| / Rs, між екземплярами 2.5..6 мА. Катод повторювача тримає опора ~100 В (1M/1M + 1 мкФ), тому режим від CCS не залежить. 10k (2512) між катодом і стоком бере 25..60 В (до 0.36 Вт): на DN2540 лишається 40..78 В і 0.19..0.25 Вт з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
Нитки на масі: Uнк повторювачів ~104 В, концертини ~62 В (ліміт 150). Вихідні 4.7 мкФ 250 В MKS4 (31.5 x 11, крок 27.5): 3.4 Гц на 10 кОм.
Канал L
Канал R
J3: гніздо 1x4 2.54 на боці B під штирі J8 основної плати (між її R32/R33 і RCA): 1 LINE_L, 2 маса, 3 LINE_R, 4 маса - сигнал ЦАП після 470 Ом / 2.2 нФ.
MP1-MP4: кліпси Keystone 3566 під колби V1-V4, по одній на 6..17 мм від цоколя, з краплею нейтрального силікону (>= 150 °C) всередині; їхні отвори - у посадковому місці лампи, символи на плату не йдуть.
FB1 6 А і C54/C55 біля ламп: нитки на постійному струмі, пульсації U1 (2.2 МГц) не йдуть дротами на уступ.

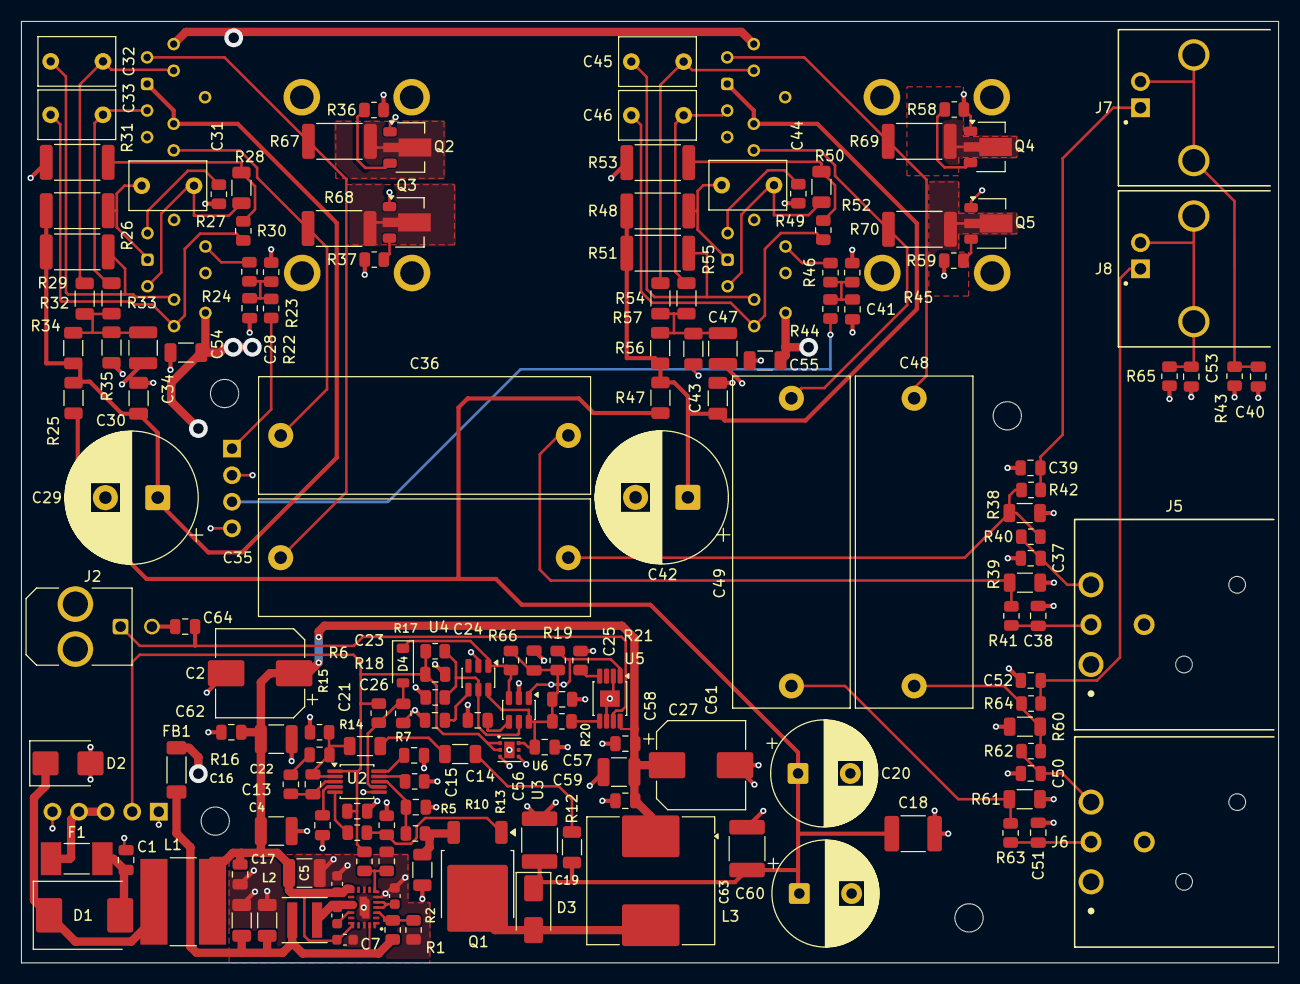
[picture p22: board jlr_tube_6n28b.kicad_pcb from above]

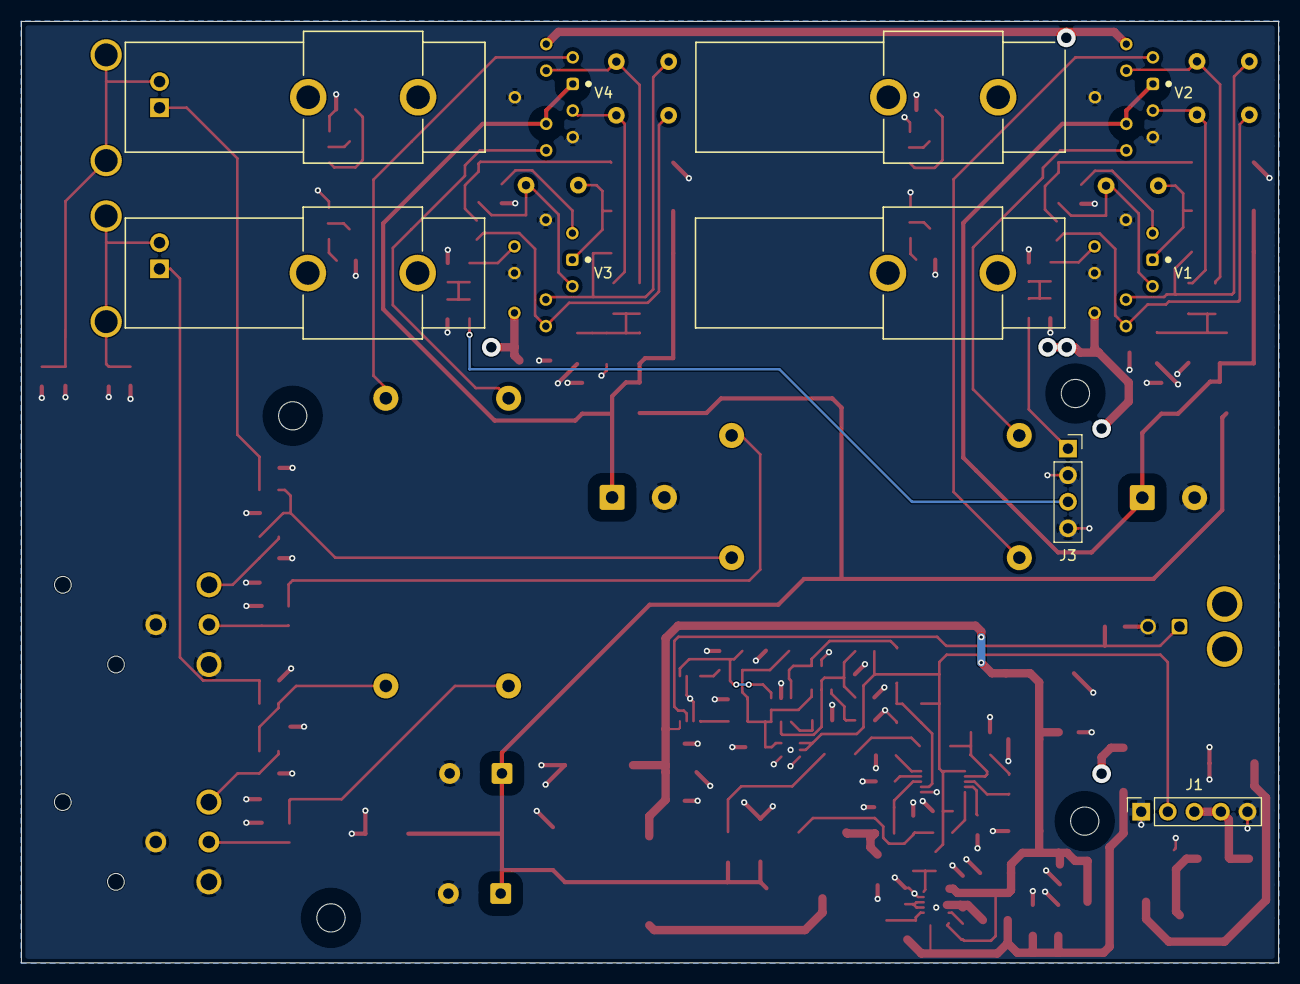
[picture p23: board jlr_tube_6n28b.kicad_pcb from below]

Board: 2 copper layers, 120.2 x 90.0 mm, 168 parts (6 on the bottom side), 87 nets.

Other parts of the board:
H1, H2, H3, H4: M2.5; MountingHole_2.7mm_M2.5_Standoff
