Oleg-mk/JLR-MOST-Amp/hw4/jlr_most_amp.kicad_pcb

## KiCad design hw4/jlr_most_amp.kicad_pcb (2026-11-08)

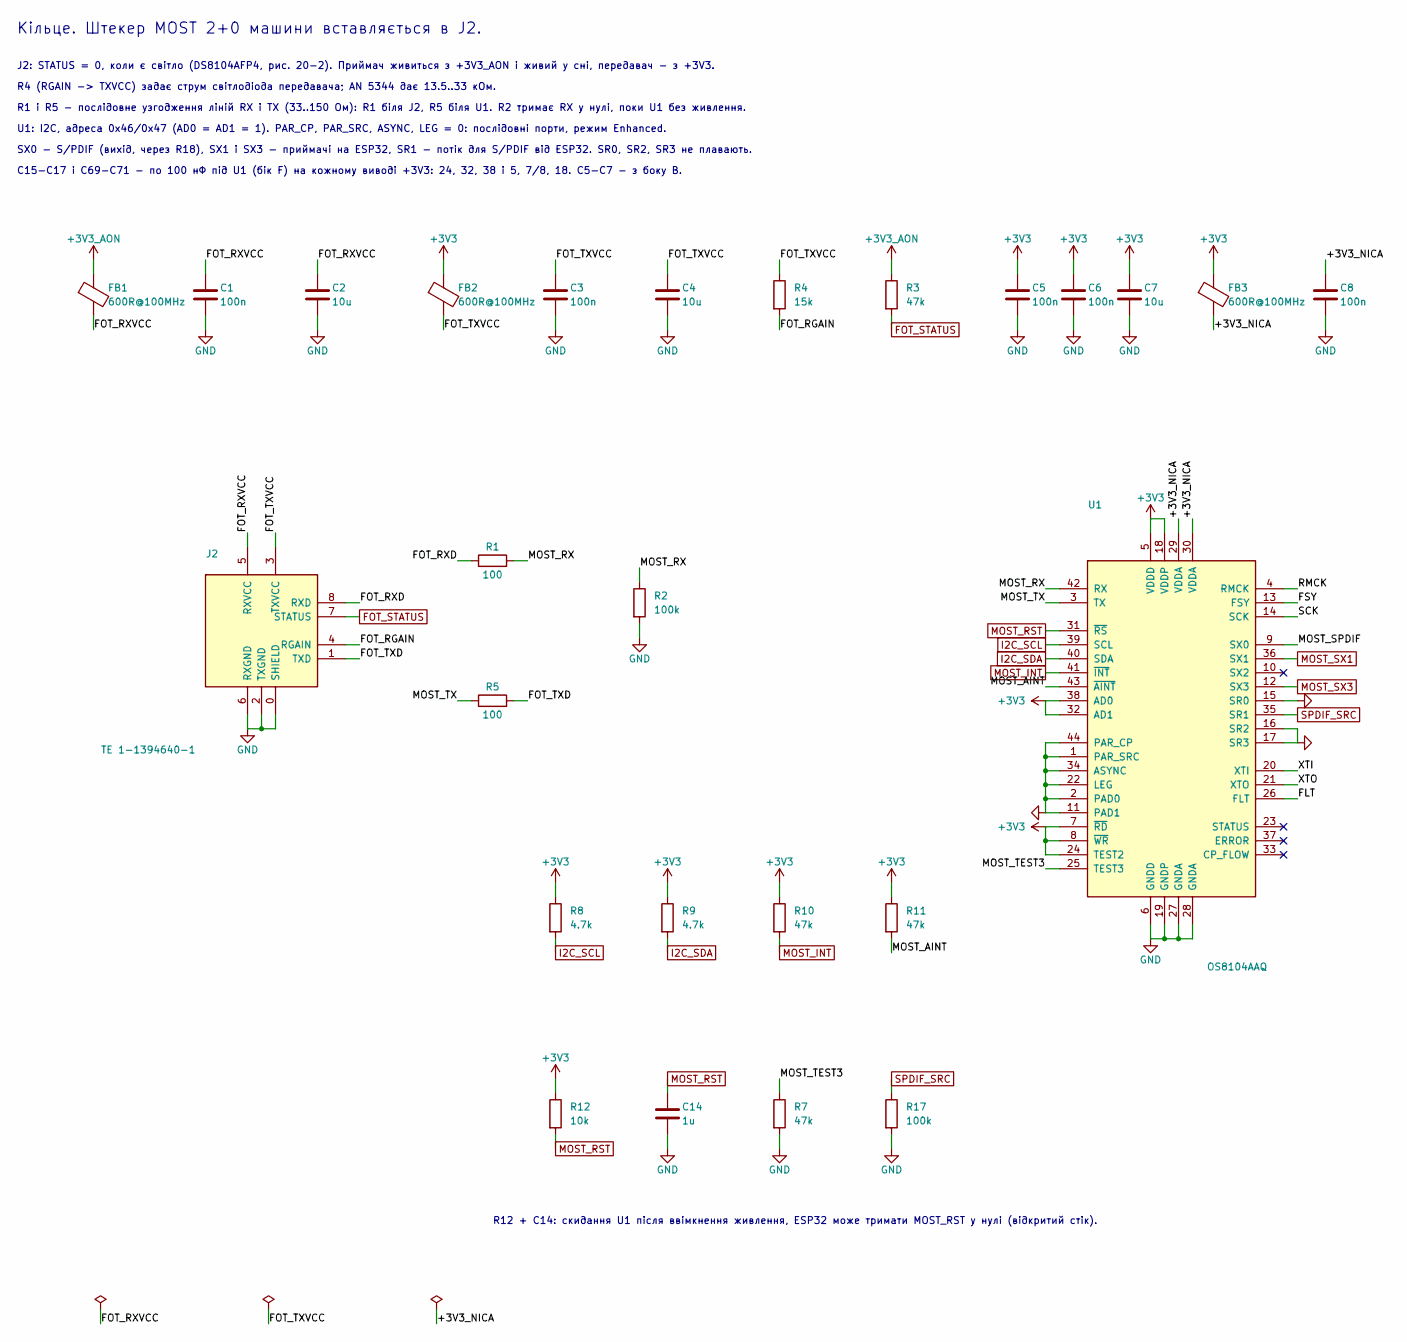
[picture p24: schematic ring.kicad_sch, JLR-MOST-Amp: Кільце: FOT і OS8104A, part in row 1, column 1]

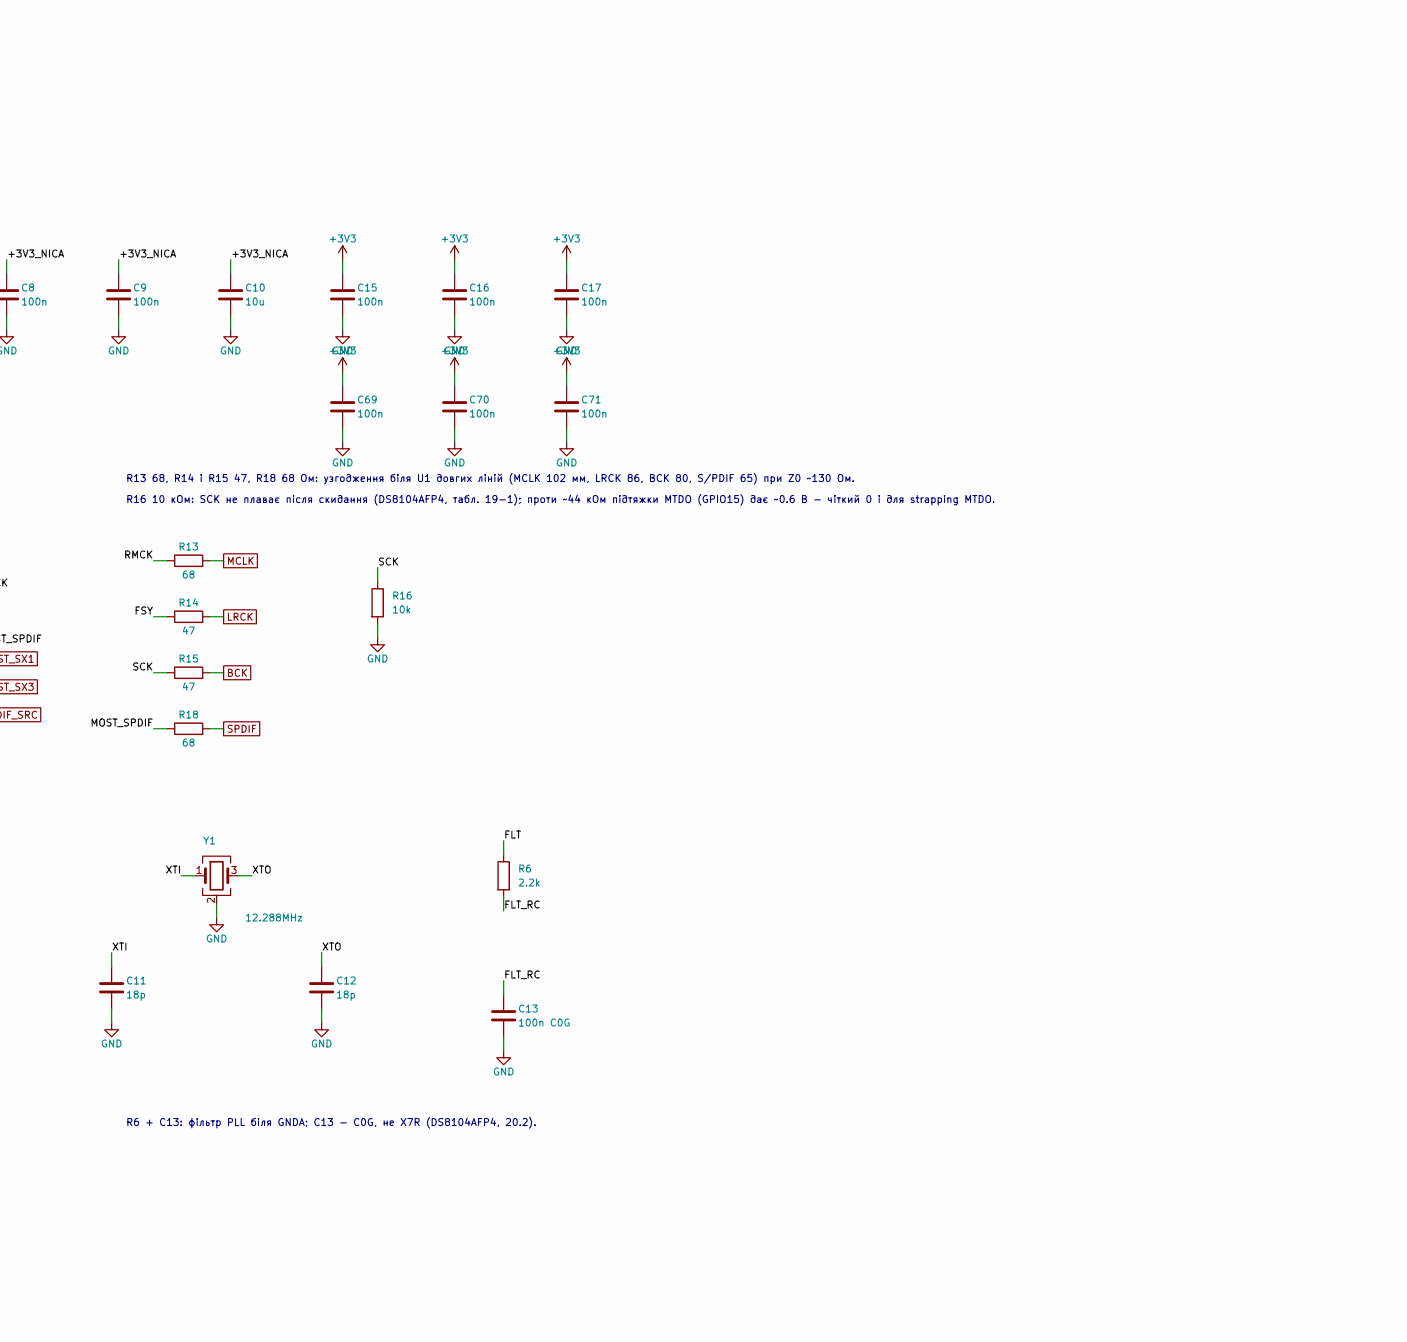
[picture p25: schematic ring.kicad_sch, JLR-MOST-Amp: Кільце: FOT і OS8104A, part in row 1, column 2]

Parts:
C1, C3, C5, C6, C8, C9, C15, C16, C17, C69, C70, C71: 100n; C_0603_1608Metric
C2, C4, C7, C10: 10u; C_0805_2012Metric
C11, C12: 18p; C_0603_1608Metric
C13: 100n C0G; C_1206_3216Metric
C14: 1u; C_0603_1608Metric
FB1, FB2, FB3: 600R@100MHz; L_0603_1608Metric
J2: TE 1-1394640-1; TE_MOST_Pigtail_FOT_2+0
R1, R5: 100; R_0603_1608Metric
R2, R17: 100k; R_0603_1608Metric
R3, R7, R10, R11: 47k; R_0603_1608Metric
R4: 15k; R_0603_1608Metric
R6: 2.2k; R_0603_1608Metric
R8, R9: 4.7k; R_0603_1608Metric
R12, R16: 10k; R_0603_1608Metric
R13, R18: 68; R_0603_1608Metric
R14, R15: 47; R_0603_1608Metric
U1: OS8104AAQ; LQFP-44_10x10mm_P0.8mm
Y1: 12.288MHz; Crystal_SMD_3225-4Pin_3.2x2.5mm

Connections:
+3V3: C5.1, C6.1, C7.1, C15.1, C16.1, C17.1, C69.1, C70.1, C71.1, FB2.1, FB3.1, R8.1, R9.1, R10.1, R11.1, R12.1, U1.5 (VDDD), U1.7 (~RD), U1.8 (~WR), U1.18 (VDDP), U1.24 (TEST2), U1.32 (AD1), U1.38 (AD0); also elsewhere on the board
+3V3_AON: FB1.1, R3.1; also elsewhere on the board
/Кільце: FOT і OS8104A/+3V3_NICA: C8.1, C9.1, C10.1, FB3.2, U1.29 (VDDA), U1.30 (VDDA)
/Кільце: FOT і OS8104A/FLT: R6.1, U1.26 (FLT)
/Кільце: FOT і OS8104A/FLT_RC: C13.1, R6.2
/Кільце: FOT і OS8104A/FOT_RGAIN: J2.4 (RGAIN), R4.2
/Кільце: FOT і OS8104A/FOT_RXD: J2.8 (RXD), R1.1
/Кільце: FOT і OS8104A/FOT_RXVCC: C1.1, C2.1, FB1.2, J2.5 (RXVCC)
/Кільце: FOT і OS8104A/FOT_TXD: J2.1 (TXD), R5.2
/Кільце: FOT і OS8104A/FOT_TXVCC: C3.1, C4.1, FB2.2, J2.3 (TXVCC), R4.1
/Кільце: FOT і OS8104A/FSY: R14.1, U1.13 (FSY)
/Кільце: FOT і OS8104A/MOST_AINT: R11.2, U1.43 (~AINT)
/Кільце: FOT і OS8104A/MOST_RX: R1.2, R2.1, U1.42 (RX)
/Кільце: FOT і OS8104A/MOST_SPDIF: R18.1, U1.9 (SX0)
/Кільце: FOT і OS8104A/MOST_TEST3: R7.1, U1.25 (TEST3)
/Кільце: FOT і OS8104A/MOST_TX: R5.1, U1.3 (TX)
/Кільце: FOT і OS8104A/RMCK: R13.1, U1.4 (RMCK)
/Кільце: FOT і OS8104A/SCK: R15.1, R16.1, U1.14 (SCK)
/Кільце: FOT і OS8104A/XTI: C11.1, U1.20 (XTI), Y1.1
/Кільце: FOT і OS8104A/XTO: C12.1, U1.21 (XTO), Y1.3
BCK: R15.2; also elsewhere on the board
FOT_STATUS: J2.7 (STATUS), R3.2; also elsewhere on the board
GND: C1.2, C2.2, C3.2, C4.2, C5.2, C6.2, C7.2, C8.2, C9.2, C10.2, C11.2, C12.2, C13.2, C14.2, C15.2, C16.2, C17.2, C69.2, C70.2, C71.2, J2.0 (SHIELD), J2.2 (TXGND), J2.6 (RXGND), R2.2, R7.2, R16.2, R17.2, U1.1 (PAR_SRC), U1.2 (PAD0), U1.6 (GNDD), U1.11 (PAD1), U1.15 (SR0), U1.16 (SR2), U1.17 (SR3), U1.19 (GNDP), U1.22 (LEG), U1.27 (GNDA), U1.28 (GNDA), U1.34 (ASYNC), U1.44 (PAR_CP), Y1.2 (G), Y1.4 (G); also elsewhere on the board
I2C_SCL: R8.2, U1.39 (SCL); also elsewhere on the board
I2C_SDA: R9.2, U1.40 (SDA); also elsewhere on the board
LRCK: R14.2; also elsewhere on the board
MCLK: R13.2; also elsewhere on the board
MOST_INT: R10.2, U1.41 (~INT); also elsewhere on the board
MOST_RST: C14.1, R12.2, U1.31 (~RS); also elsewhere on the board
MOST_SX1: U1.36 (SX1); also elsewhere on the board
MOST_SX3: U1.12 (SX3); also elsewhere on the board
SPDIF: R18.2; also elsewhere on the board
SPDIF_SRC: R17.1, U1.35 (SR1); also elsewhere on the board

Notes on the sheet:
Кільце. Штекер MOST 2+0 машини вставляється в J2.
J2: STATUS = 0, коли є світло (DS8104AFP4, рис. 20-2). Приймач живиться з +3V3_AON і живий у сні, передавач - з +3V3.
R4 (RGAIN -> TXVCC) задає струм світлодіода передавача; AN 5344 дає 13.5..33 кОм.
R1 і R5 - послідовне узгодження ліній RX і TX (33..150 Ом): R1 біля J2, R5 біля U1. R2 тримає RX у нулі, поки U1 без живлення.
U1: I2C, адреса 0x46/0x47 (AD0 = AD1 = 1). PAR_CP, PAR_SRC, ASYNC, LEG = 0: послідовні порти, режим Enhanced.
SX0 - S/PDIF (вихід, через R18), SX1 і SX3 - приймачі на ESP32, SR1 - потік для S/PDIF від ESP32. SR0, SR2, SR3 не плавають.
C15-C17 і C69-C71 - по 100 нФ під U1 (бік F) на кожному виводі +3V3: 24, 32, 38 і 5, 7/8, 18. C5-C7 - з боку B.
R12 + C14: скидання U1 після ввімкнення живлення, ESP32 може тримати MOST_RST у нулі (відкритий стік).
R13 68, R14 і R15 47, R18 68 Ом: узгодження біля U1 довгих ліній (MCLK 102 мм, LRCK 86, BCK 80, S/PDIF 65) при Z0 ~130 Ом.
R16 10 кОм: SCK не плаває після скидання (DS8104AFP4, табл. 19-1); проти ~44 кОм підтяжки MTDO (GPIO15) дає ~0.6 В - чіткий 0 і для strapping MTDO.
R6 + C13: фільтр PLL біля GNDA; C13 - C0G, не X7R (DS8104AFP4, 20.2).

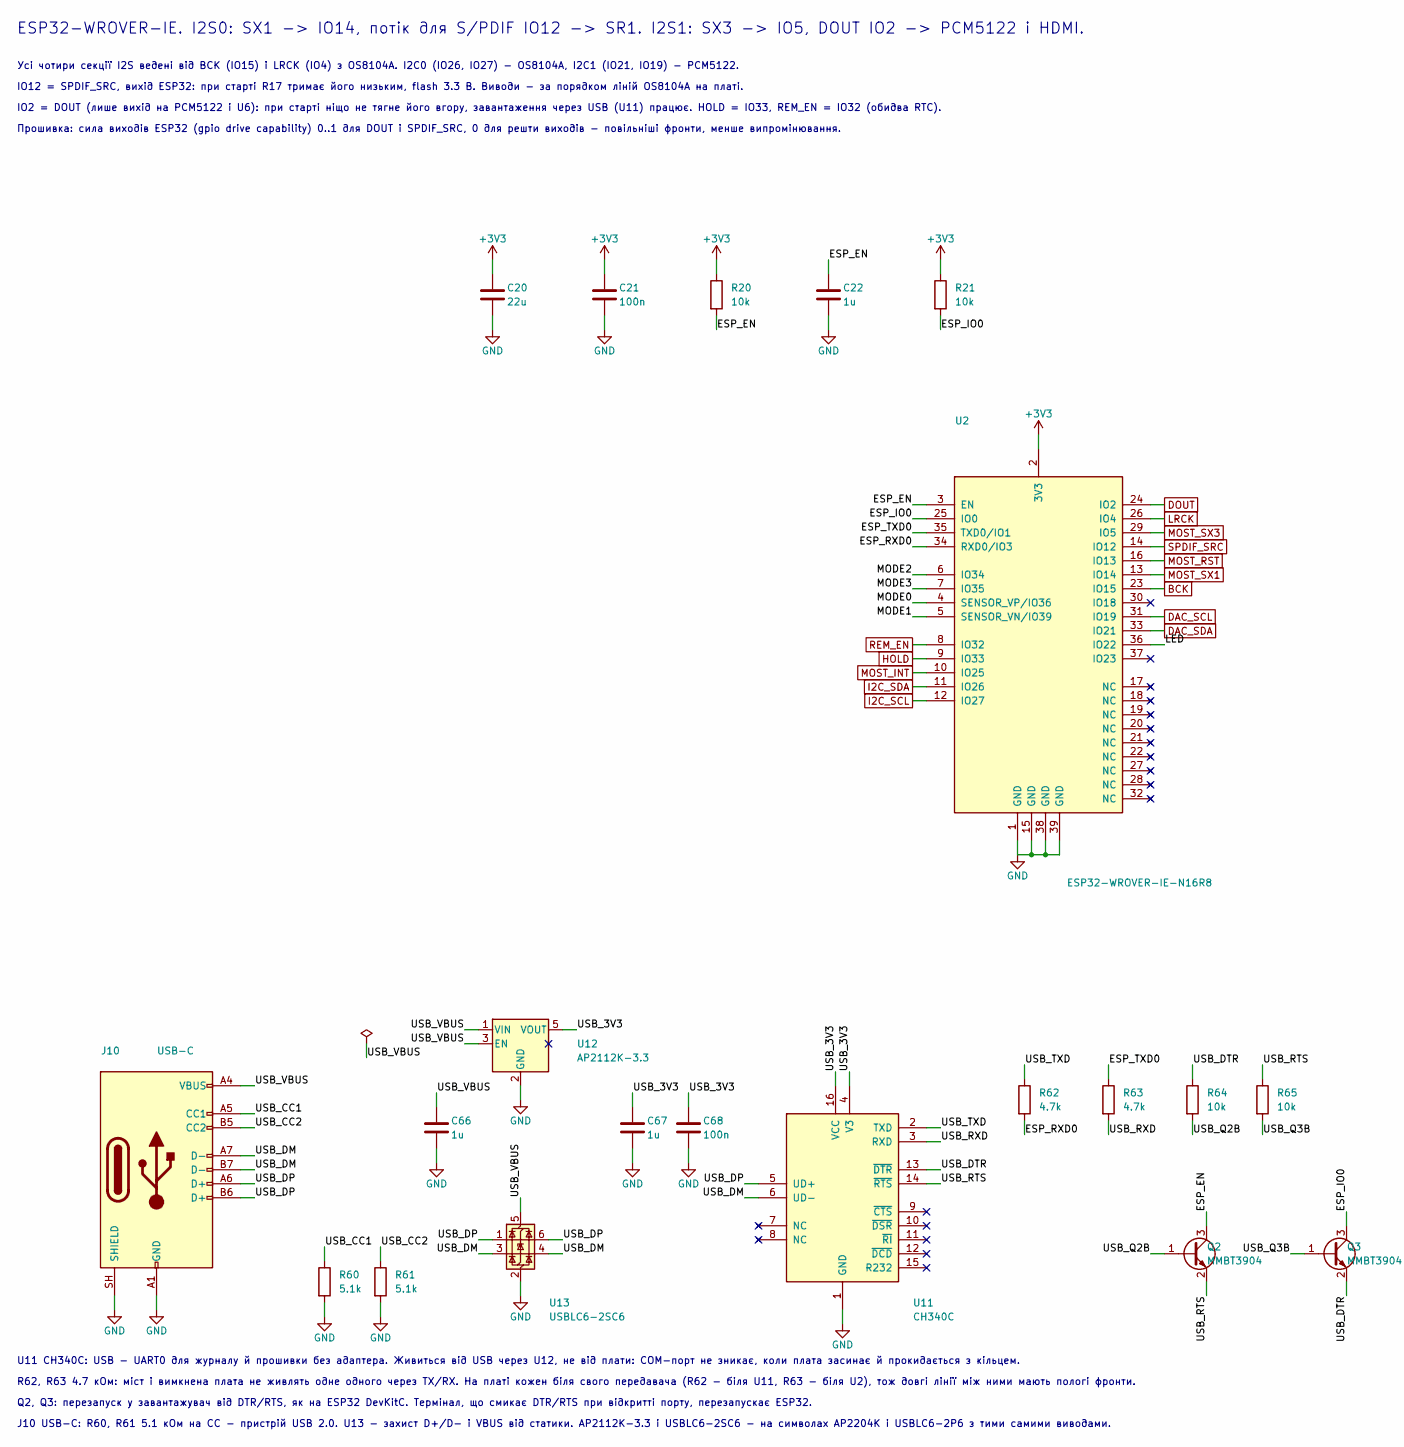
[picture p26: schematic host.kicad_sch, JLR-MOST-Amp: ESP32-WROVER-IE, part in row 1, column 1]

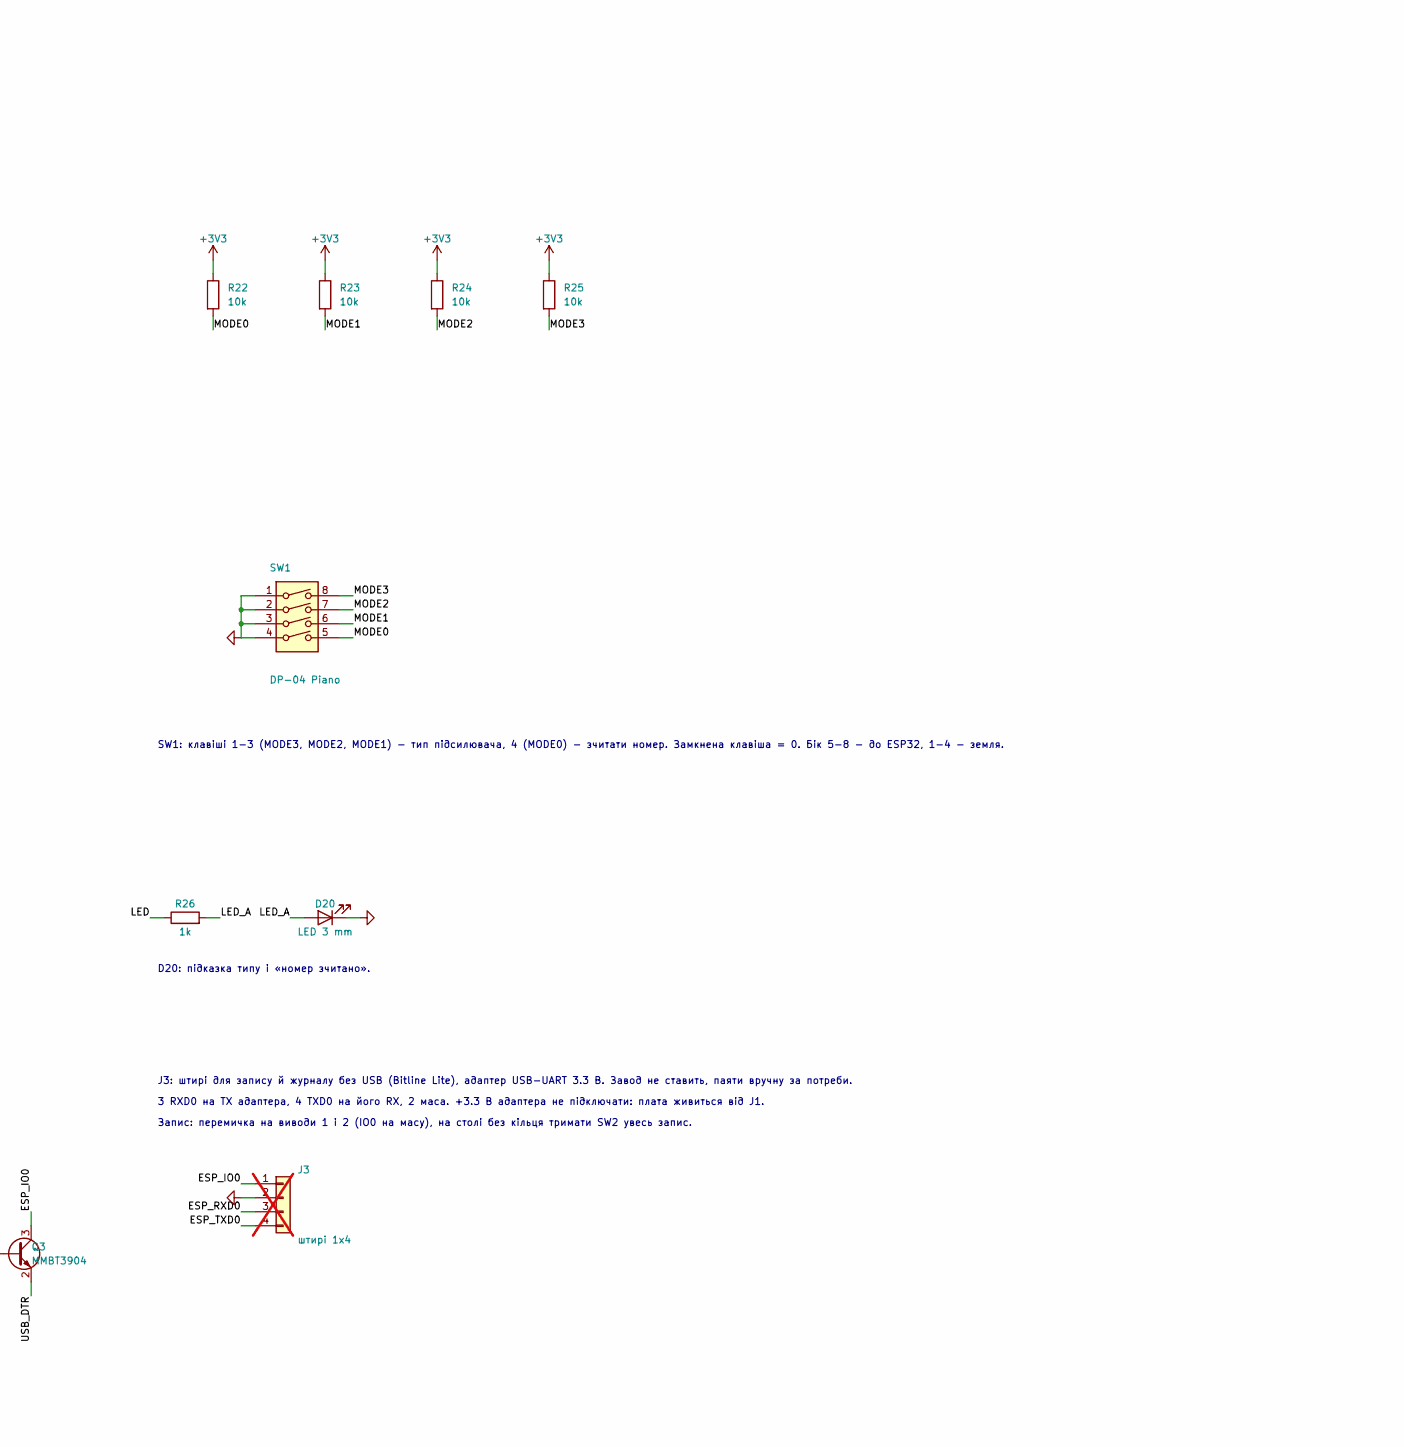
[picture p27: schematic host.kicad_sch, JLR-MOST-Amp: ESP32-WROVER-IE, part in row 1, column 2]

Parts:
C20: 22u; C_1206_3216Metric
C21, C68: 100n; C_0603_1608Metric
C22, C66, C67: 1u; C_0603_1608Metric
D20: LED 3 mm; LED_D3.0mm
J3: штирі 1x4; PinHeader_1x04_P2.54mm_Vertical; not fitted
J10: USB-C; USB_C_Receptacle_14P_SideInsert_THT
Q2, Q3: MMBT3904; SOT-23
R20, R21, R22, R23, R24, R25, R64, R65: 10k; R_0603_1608Metric
R26: 1k; R_0603_1608Metric
R60, R61: 5.1k; R_0603_1608Metric
R62, R63: 4.7k; R_0603_1608Metric
SW1: DP-04 Piano; SW_DIP_SPSTx04_Piano_10.8x11.72mm_W7.62mm_P2.54mm
U2: ESP32-WROVER-IE-N16R8; ESP32-WROVER-IE
U11: CH340C; SOIC-16_3.9x9.9mm_P1.27mm
U12: AP2112K-3.3; SOT-23-5
U13: USBLC6-2SC6; SOT-23-6

Connections:
+3V3: C20.1, C21.1, R20.1, R21.1, R22.1, R23.1, R24.1, R25.1, U2.2 (3V3); also elsewhere on the board
/ESP32-WROVER-IE/ESP_EN: C22.1, Q2.3 (C), R20.2, U2.3 (EN)
/ESP32-WROVER-IE/ESP_IO0: J3.1, Q3.3 (C), R21.2, U2.25 (IO0)
/ESP32-WROVER-IE/ESP_RXD0: J3.3, R62.2, U2.34 (RXD0/IO3)
/ESP32-WROVER-IE/ESP_TXD0: J3.4, R63.1, U2.35 (TXD0/IO1)
/ESP32-WROVER-IE/LED: R26.1, U2.36 (IO22)
/ESP32-WROVER-IE/LED_A: D20.2 (A), R26.2
/ESP32-WROVER-IE/MODE0: R22.2, SW1.5, U2.4 (SENSOR_VP/IO36)
/ESP32-WROVER-IE/MODE1: R23.2, SW1.6, U2.5 (SENSOR_VN/IO39)
/ESP32-WROVER-IE/MODE2: R24.2, SW1.7, U2.6 (IO34)
/ESP32-WROVER-IE/MODE3: R25.2, SW1.8, U2.7 (IO35)
/ESP32-WROVER-IE/USB_3V3: C67.1, C68.1, U11.4 (V3), U11.16 (VCC), U12.5 (VOUT)
/ESP32-WROVER-IE/USB_CC1: J10.A5 (CC1), R60.1
/ESP32-WROVER-IE/USB_CC2: J10.B5 (CC2), R61.1
/ESP32-WROVER-IE/USB_DM: J10.A7 (D-), J10.B7 (D-), U11.6 (UD-), U13.3 (I/O2), U13.4 (I/O2)
/ESP32-WROVER-IE/USB_DP: J10.A6 (D+), J10.B6 (D+), U11.5 (UD+), U13.1 (I/O1), U13.6 (I/O1)
/ESP32-WROVER-IE/USB_DTR: Q3.2 (E), R64.1, U11.13 (~DTR)
/ESP32-WROVER-IE/USB_Q2B: Q2.1 (B), R64.2
/ESP32-WROVER-IE/USB_Q3B: Q3.1 (B), R65.2
/ESP32-WROVER-IE/USB_RTS: Q2.2 (E), R65.1, U11.14 (~RTS)
/ESP32-WROVER-IE/USB_RXD: R63.2, U11.3 (RXD)
/ESP32-WROVER-IE/USB_TXD: R62.1, U11.2 (TXD)
/ESP32-WROVER-IE/USB_VBUS: C66.1, J10.A4 (VBUS), J10.A9 (VBUS), J10.B4 (VBUS), J10.B9 (VBUS), U12.1 (VIN), U12.3 (EN), U13.5 (VBUS)
BCK: U2.23 (IO15); also elsewhere on the board
DAC_SCL: U2.31 (IO19); also elsewhere on the board
DAC_SDA: U2.33 (IO21); also elsewhere on the board
DOUT: U2.24 (IO2); also elsewhere on the board
GND: C20.2, C21.2, C22.2, C66.2, C67.2, C68.2, D20.1 (K), J3.2, J10.A1 (GND), J10.A12 (GND), J10.B1 (GND), J10.B12 (GND), J10.SH (SHIELD), R60.2, R61.2, SW1.1, SW1.2, SW1.3, SW1.4, U2.1 (GND), U2.15 (GND), U2.38 (GND), U2.39 (GND), U11.1 (GND), U12.2 (GND), U13.2 (GND); also elsewhere on the board
HOLD: U2.9 (IO33); also elsewhere on the board
I2C_SCL: U2.12 (IO27); also elsewhere on the board
I2C_SDA: U2.11 (IO26); also elsewhere on the board
LRCK: U2.26 (IO4); also elsewhere on the board
MOST_INT: U2.10 (IO25); also elsewhere on the board
MOST_RST: U2.16 (IO13); also elsewhere on the board
MOST_SX1: U2.13 (IO14); also elsewhere on the board
MOST_SX3: U2.29 (IO5); also elsewhere on the board
REM_EN: U2.8 (IO32); also elsewhere on the board
SPDIF_SRC: U2.14 (IO12); also elsewhere on the board

Notes on the sheet:
ESP32-WROVER-IE. I2S0: SX1 -> IO14, потік для S/PDIF IO12 -> SR1. I2S1: SX3 -> IO5, DOUT IO2 -> PCM5122 і HDMI.
Усі чотири секції I2S ведені від BCK (IO15) і LRCK (IO4) з OS8104A. I2C0 (IO26, IO27) - OS8104A, I2C1 (IO21, IO19) - PCM5122.
IO12 = SPDIF_SRC, вихід ESP32: при старті R17 тримає його низьким, flash 3.3 В. Виводи - за порядком ліній OS8104A на платі.
IO2 = DOUT (лише вихід на PCM5122 і U6): при старті ніщо не тягне його вгору, завантаження через USB (U11) працює. HOLD = IO33, REM_EN = IO32 (обидва RTC).
Прошивка: сила виходів ESP32 (gpio drive capability) 0..1 для DOUT і SPDIF_SRC, 0 для решти виходів - повільніші фронти, менше випромінювання.
SW1: клавіші 1-3 (MODE3, MODE2, MODE1) - тип підсилювача, 4 (MODE0) - зчитати номер. Замкнена клавіша = 0. Бік 5-8 - до ESP32, 1-4 - земля.
D20: підказка типу і «номер зчитано».
J3: штирі для запису й журналу без USB (Bitline Lite), адаптер USB-UART 3.3 В. Завод не ставить, паяти вручну за потреби.
3 RXD0 на TX адаптера, 4 TXD0 на його RX, 2 маса. +3.3 В адаптера не підключати: плата живиться від J1.
Запис: перемичка на виводи 1 і 2 (IO0 на масу), на столі без кільця тримати SW2 увесь запис.
U11 CH340C: USB - UART0 для журналу й прошивки без адаптера. Живиться від USB через U12, не від плати: COM-порт не зникає, коли плата засинає й прокидається з кільцем.
R62, R63 4.7 кОм: міст і вимкнена плата не живлять одне одного через TX/RX. На платі кожен біля свого передавача (R62 - біля U11, R63 - біля U2), тож довгі лінії між ними мають пологі фронти.
Q2, Q3: перезапуск у завантажувач від DTR/RTS, як на ESP32 DevKitC. Термінал, що смикає DTR/RTS при відкритті порту, перезапускає ESP32.
J10 USB-C: R60, R61 5.1 кОм на CC - пристрій USB 2.0. U13 - захист D+/D- і VBUS від статики. AP2112K-3.3 і USBLC6-2SC6 - на символах AP2204K і USBLC6-2P6 з тими самими виводами.

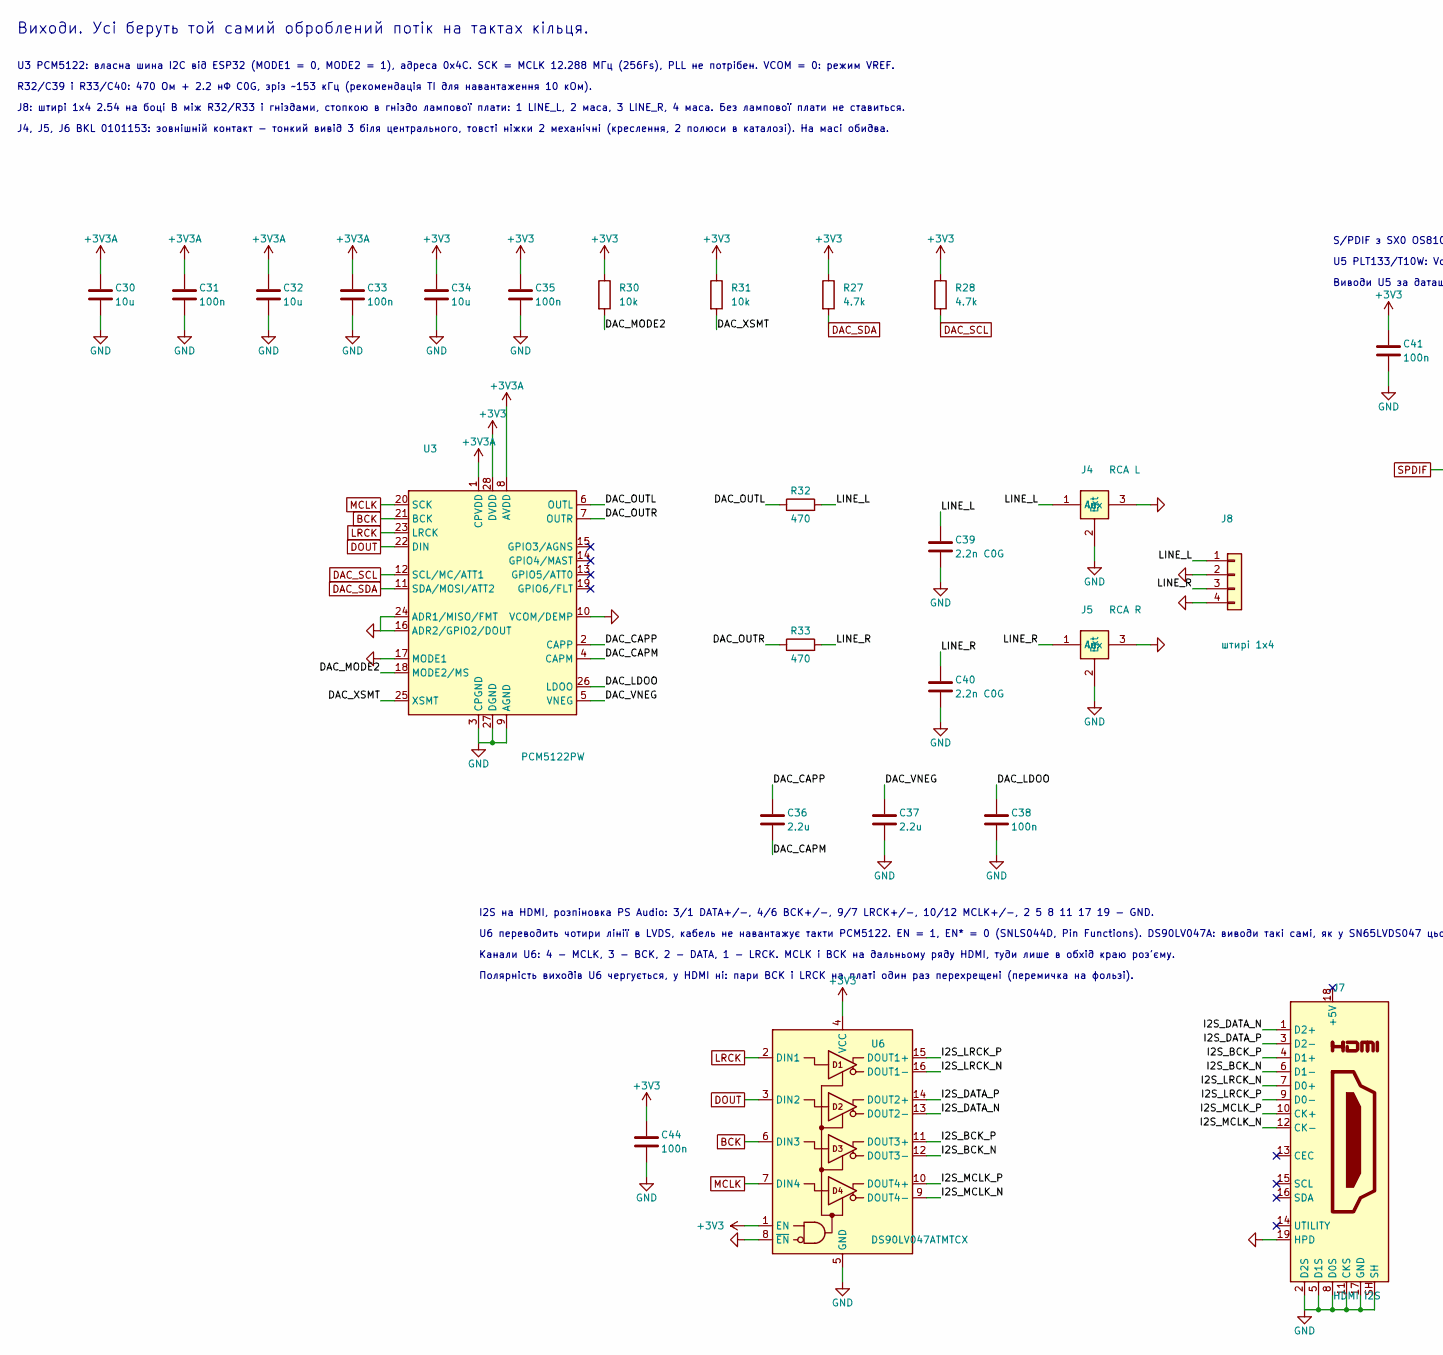
[picture p28: schematic outputs.kicad_sch, JLR-MOST-Amp: Виходи: PCM5122, S/PDIF, I2S, part in row 1, column 1]

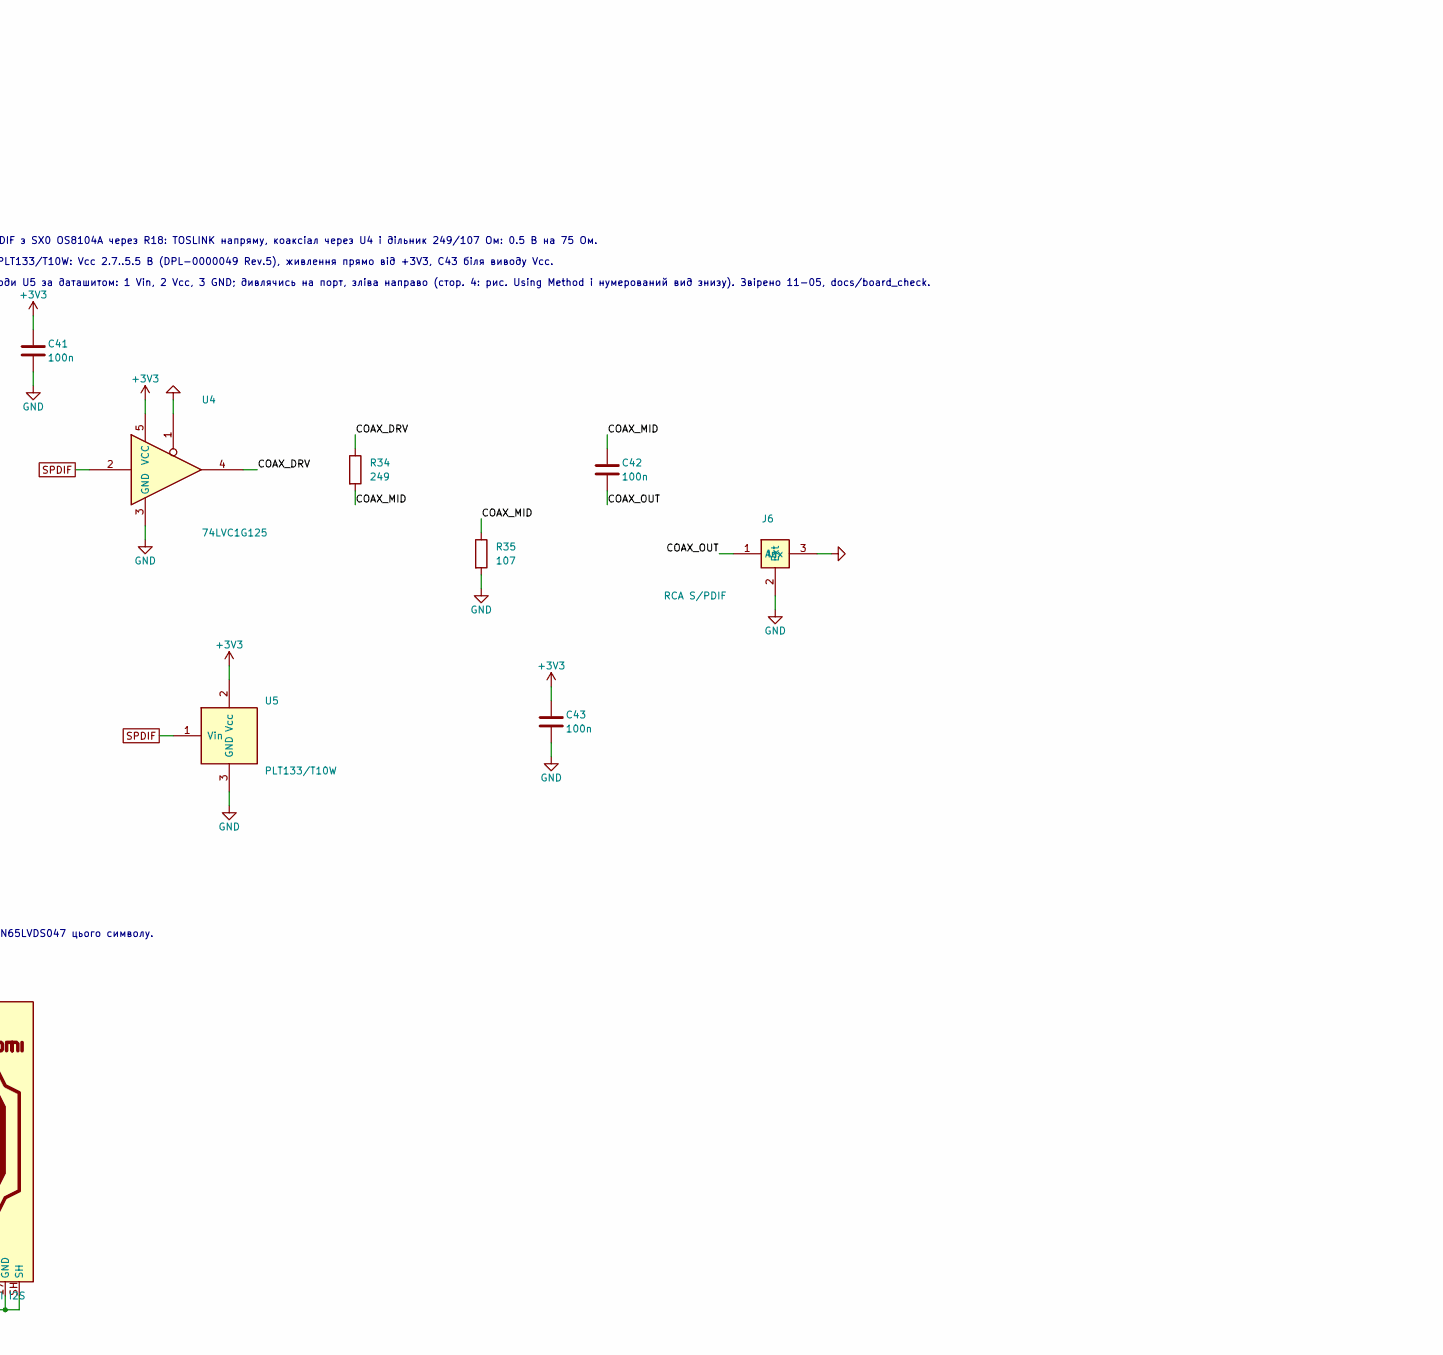
[picture p29: schematic outputs.kicad_sch, JLR-MOST-Amp: Виходи: PCM5122, S/PDIF, I2S, part in row 1, column 2]

Parts:
C30, C32, C34: 10u; C_0805_2012Metric
C31, C33, C35, C38, C41, C42, C43, C44: 100n; C_0603_1608Metric
C36, C37: 2.2u; C_0805_2012Metric
C39, C40: 2.2n C0G; C_0603_1608Metric
J4: RCA L; BKL_0101153_RCA_RA
J5: RCA R; BKL_0101153_RCA_RA
J6: RCA S/PDIF; BKL_0101153_RCA_RA
J7: HDMI I2S; HDMI_A_Kycon_KDMIX-SL1-NS-WS-B15_VerticalRightAngle
J8: штирі 1x4; PinHeader_1x04_P2.54mm_Vertical
R27, R28: 4.7k; R_0603_1608Metric
R30, R31: 10k; R_0603_1608Metric
R32, R33: 470; R_0603_1608Metric
R34: 249; R_0603_1608Metric
R35: 107; R_0603_1608Metric
U3: PCM5122PW; TSSOP-28_4.4x9.7mm_P0.65mm
U4: 74LVC1G125; SOT-23-5
U5: PLT133/T10W; Everlight_TOSLINK_T10
U6: DS90LV047ATMTCX; TSSOP-16_4.4x5mm_P0.65mm

Connections:
+3V3: C34.1, C35.1, C41.1, C43.1, C44.1, R27.1, R28.1, R30.1, R31.1, U3.28 (DVDD), U4.5 (VCC), U5.2 (Vcc), U6.1 (EN), U6.4 (VCC); also elsewhere on the board
+3V3A: C30.1, C31.1, C32.1, C33.1, U3.1 (CPVDD), U3.8 (AVDD); also elsewhere on the board
/Виходи: PCM5122, S/PDIF, I2S/COAX_DRV: R34.1, U4.4
/Виходи: PCM5122, S/PDIF, I2S/COAX_MID: C42.1, R34.2, R35.1
/Виходи: PCM5122, S/PDIF, I2S/COAX_OUT: C42.2, J6.1 (In)
/Виходи: PCM5122, S/PDIF, I2S/DAC_CAPM: C36.2, U3.4 (CAPM)
/Виходи: PCM5122, S/PDIF, I2S/DAC_CAPP: C36.1, U3.2 (CAPP)
/Виходи: PCM5122, S/PDIF, I2S/DAC_LDOO: C38.1, U3.26 (LDOO)
/Виходи: PCM5122, S/PDIF, I2S/DAC_MODE2: R30.2, U3.18 (MODE2/MS)
/Виходи: PCM5122, S/PDIF, I2S/DAC_OUTL: R32.1, U3.6 (OUTL)
/Виходи: PCM5122, S/PDIF, I2S/DAC_OUTR: R33.1, U3.7 (OUTR)
/Виходи: PCM5122, S/PDIF, I2S/DAC_VNEG: C37.1, U3.5 (VNEG)
/Виходи: PCM5122, S/PDIF, I2S/DAC_XSMT: R31.2, U3.25 (XSMT)
/Виходи: PCM5122, S/PDIF, I2S/I2S_BCK_N: J7.6 (D1-), U6.12 (DOUT3-)
/Виходи: PCM5122, S/PDIF, I2S/I2S_BCK_P: J7.4 (D1+), U6.11 (DOUT3+)
/Виходи: PCM5122, S/PDIF, I2S/I2S_DATA_N: J7.1 (D2+), U6.13 (DOUT2-)
/Виходи: PCM5122, S/PDIF, I2S/I2S_DATA_P: J7.3 (D2-), U6.14 (DOUT2+)
/Виходи: PCM5122, S/PDIF, I2S/I2S_LRCK_N: J7.7 (D0+), U6.16 (DOUT1-)
/Виходи: PCM5122, S/PDIF, I2S/I2S_LRCK_P: J7.9 (D0-), U6.15 (DOUT1+)
/Виходи: PCM5122, S/PDIF, I2S/I2S_MCLK_N: J7.12 (CK-), U6.9 (DOUT4-)
/Виходи: PCM5122, S/PDIF, I2S/I2S_MCLK_P: J7.10 (CK+), U6.10 (DOUT4+)
/Виходи: PCM5122, S/PDIF, I2S/LINE_L: C39.1, J4.1 (In), J8.1, R32.2
/Виходи: PCM5122, S/PDIF, I2S/LINE_R: C40.1, J5.1 (In), J8.3, R33.2
BCK: U3.21 (BCK), U6.6 (DIN3); also elsewhere on the board
DAC_SCL: R28.2, U3.12 (SCL/MC/ATT1); also elsewhere on the board
DAC_SDA: R27.2, U3.11 (SDA/MOSI/ATT2); also elsewhere on the board
DOUT: U3.22 (DIN), U6.3 (DIN2); also elsewhere on the board
GND: C30.2, C31.2, C32.2, C33.2, C34.2, C35.2, C37.2, C38.2, C39.2, C40.2, C41.2, C43.2, C44.2, J4.2 (Ext), J4.3 (Aux), J5.2 (Ext), J5.3 (Aux), J6.2 (Ext), J6.3 (Aux), J7.2 (D2S), J7.5 (D1S), J7.8 (D0S), J7.11 (CKS), J7.17 (GND), J7.19 (HPD), J7.SH, J8.2, J8.4, R35.2, U3.3 (CPGND), U3.9 (AGND), U3.10 (VCOM/DEMP), U3.16 (ADR2/GPIO2/DOUT), U3.17 (MODE1), U3.24 (ADR1/MISO/FMT), U3.27 (DGND), U4.1, U4.3 (GND), U5.3 (GND), U6.5 (GND), U6.8 (~EN); also elsewhere on the board
LRCK: U3.23 (LRCK), U6.2 (DIN1); also elsewhere on the board
MCLK: U3.20 (SCK), U6.7 (DIN4); also elsewhere on the board
SPDIF: U4.2, U5.1 (Vin); also elsewhere on the board

Notes on the sheet:
Виходи. Усі беруть той самий оброблений потік на тактах кільця.
U3 PCM5122: власна шина I2C від ESP32 (MODE1 = 0, MODE2 = 1), адреса 0x4C. SCK = MCLK 12.288 МГц (256Fs), PLL не потрібен. VCOM = 0: режим VREF.
R32/C39 і R33/C40: 470 Ом + 2.2 нФ C0G, зріз ~153 кГц (рекомендація TI для навантаження 10 кОм).
J8: штирі 1x4 2.54 на боці B між R32/R33 і гніздами, стопкою в гніздо лампової плати: 1 LINE_L, 2 маса, 3 LINE_R, 4 маса. Без лампової плати не ставиться.
S/PDIF з SX0 OS8104A через R18: TOSLINK напряму, коаксіал через U4 і дільник 249/107 Ом: 0.5 В на 75 Ом.
U5 PLT133/T10W: Vcc 2.7..5.5 В (DPL-0000049 Rev.5), живлення прямо від +3V3, C43 біля виводу Vcc.
Виводи U5 за даташитом: 1 Vin, 2 Vcc, 3 GND; дивлячись на порт, зліва направо (стор. 4: рис. Using Method і нумерований вид знизу). Звірено 11-05, docs/board_check.
J4, J5, J6 BKL 0101153: зовнішній контакт - тонкий вивід 3 біля центрального, товсті ніжки 2 механічні (креслення, 2 полюси в каталозі). На масі обидва.
I2S на HDMI, розпіновка PS Audio: 3/1 DATA+/-, 4/6 BCK+/-, 9/7 LRCK+/-, 10/12 MCLK+/-, 2 5 8 11 17 19 - GND.
U6 переводить чотири лінії в LVDS, кабель не навантажує такти PCM5122. EN = 1, EN* = 0 (SNLS044D, Pin Functions). DS90LV047A: виводи такі самі, як у SN65LVDS047 цього символу.
Канали U6: 4 - MCLK, 3 - BCK, 2 - DATA, 1 - LRCK. MCLK і BCK на дальньому ряду HDMI, туди лише в обхід краю роз'єму.
Полярність виходів U6 чергується, у HDMI ні: пари BCK і LRCK на платі один раз перехрещені (перемичка на фользі).
