Oleg-mk/JLR-MOST-Amp/hw4/jlr_most_amp.kicad_pcb

## KiCad design hw4/jlr_most_amp.kicad_pcb (continued)

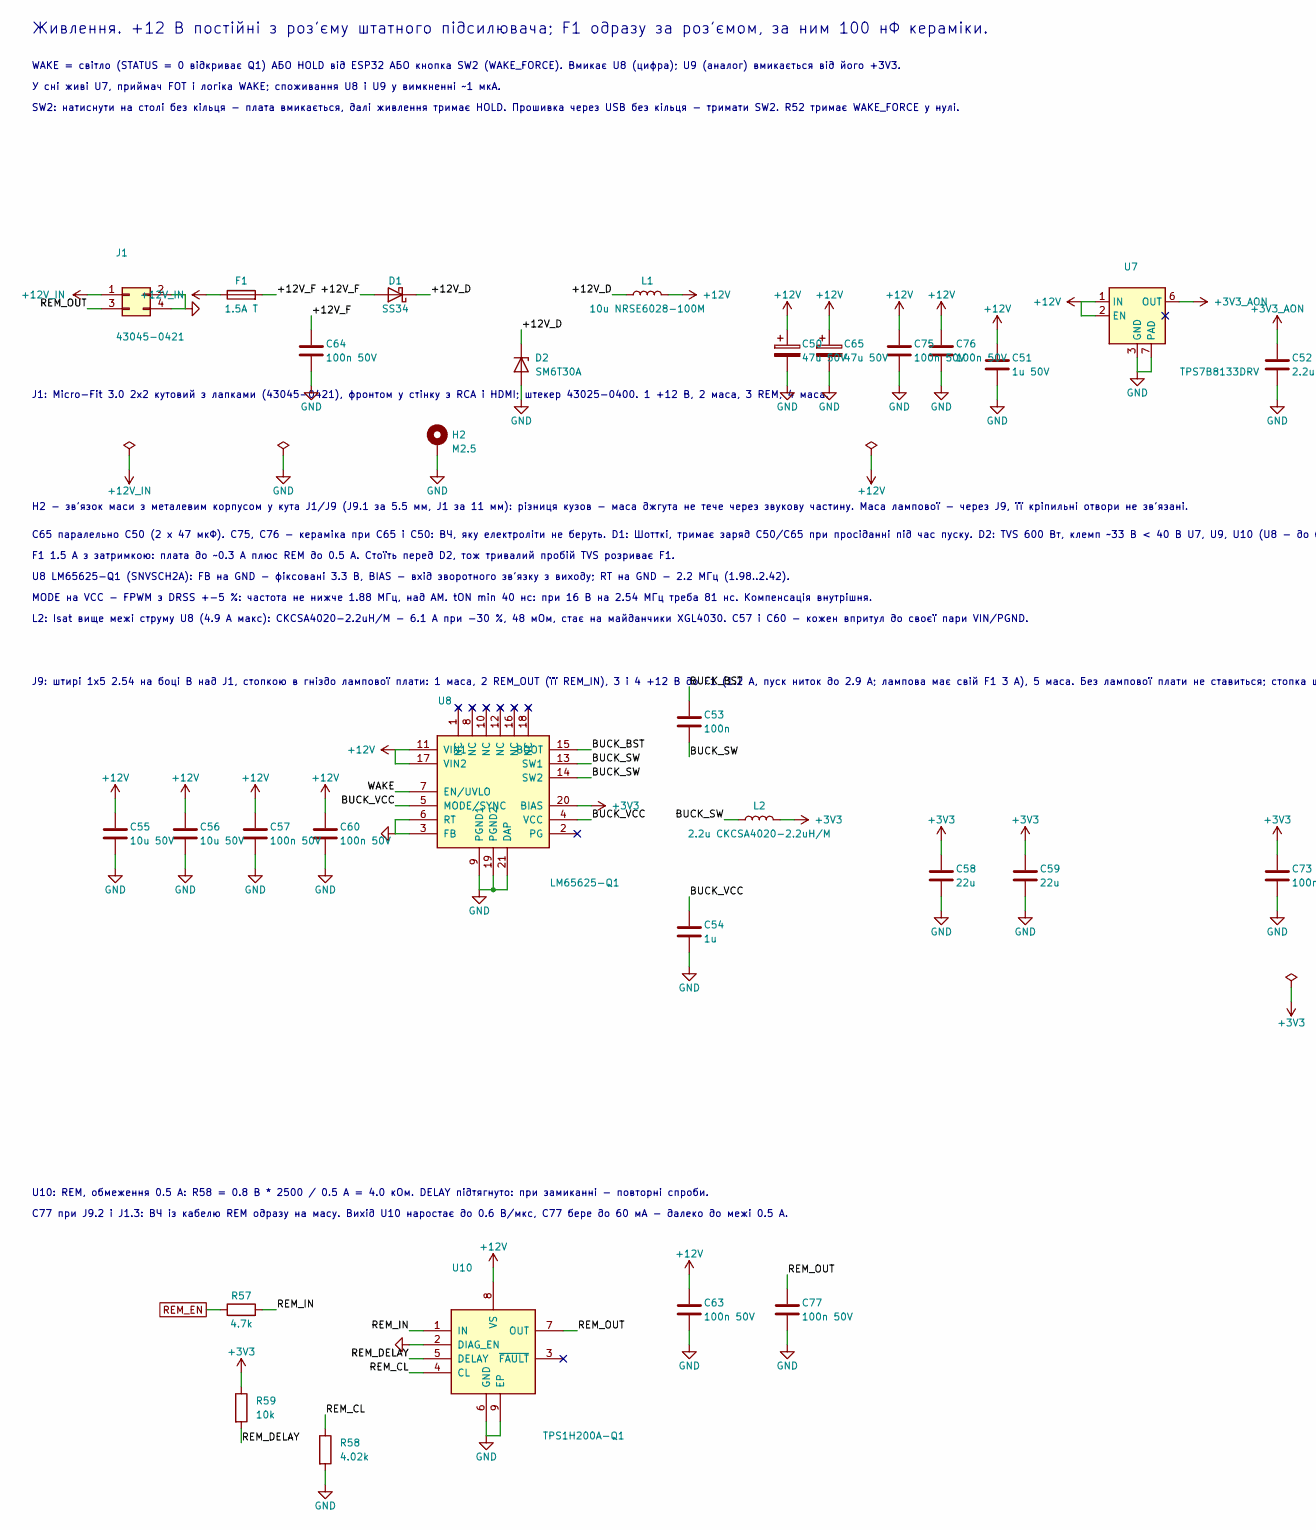
[picture p30: schematic power.kicad_sch, JLR-MOST-Amp: Живлення і REM, part in row 1, column 1]

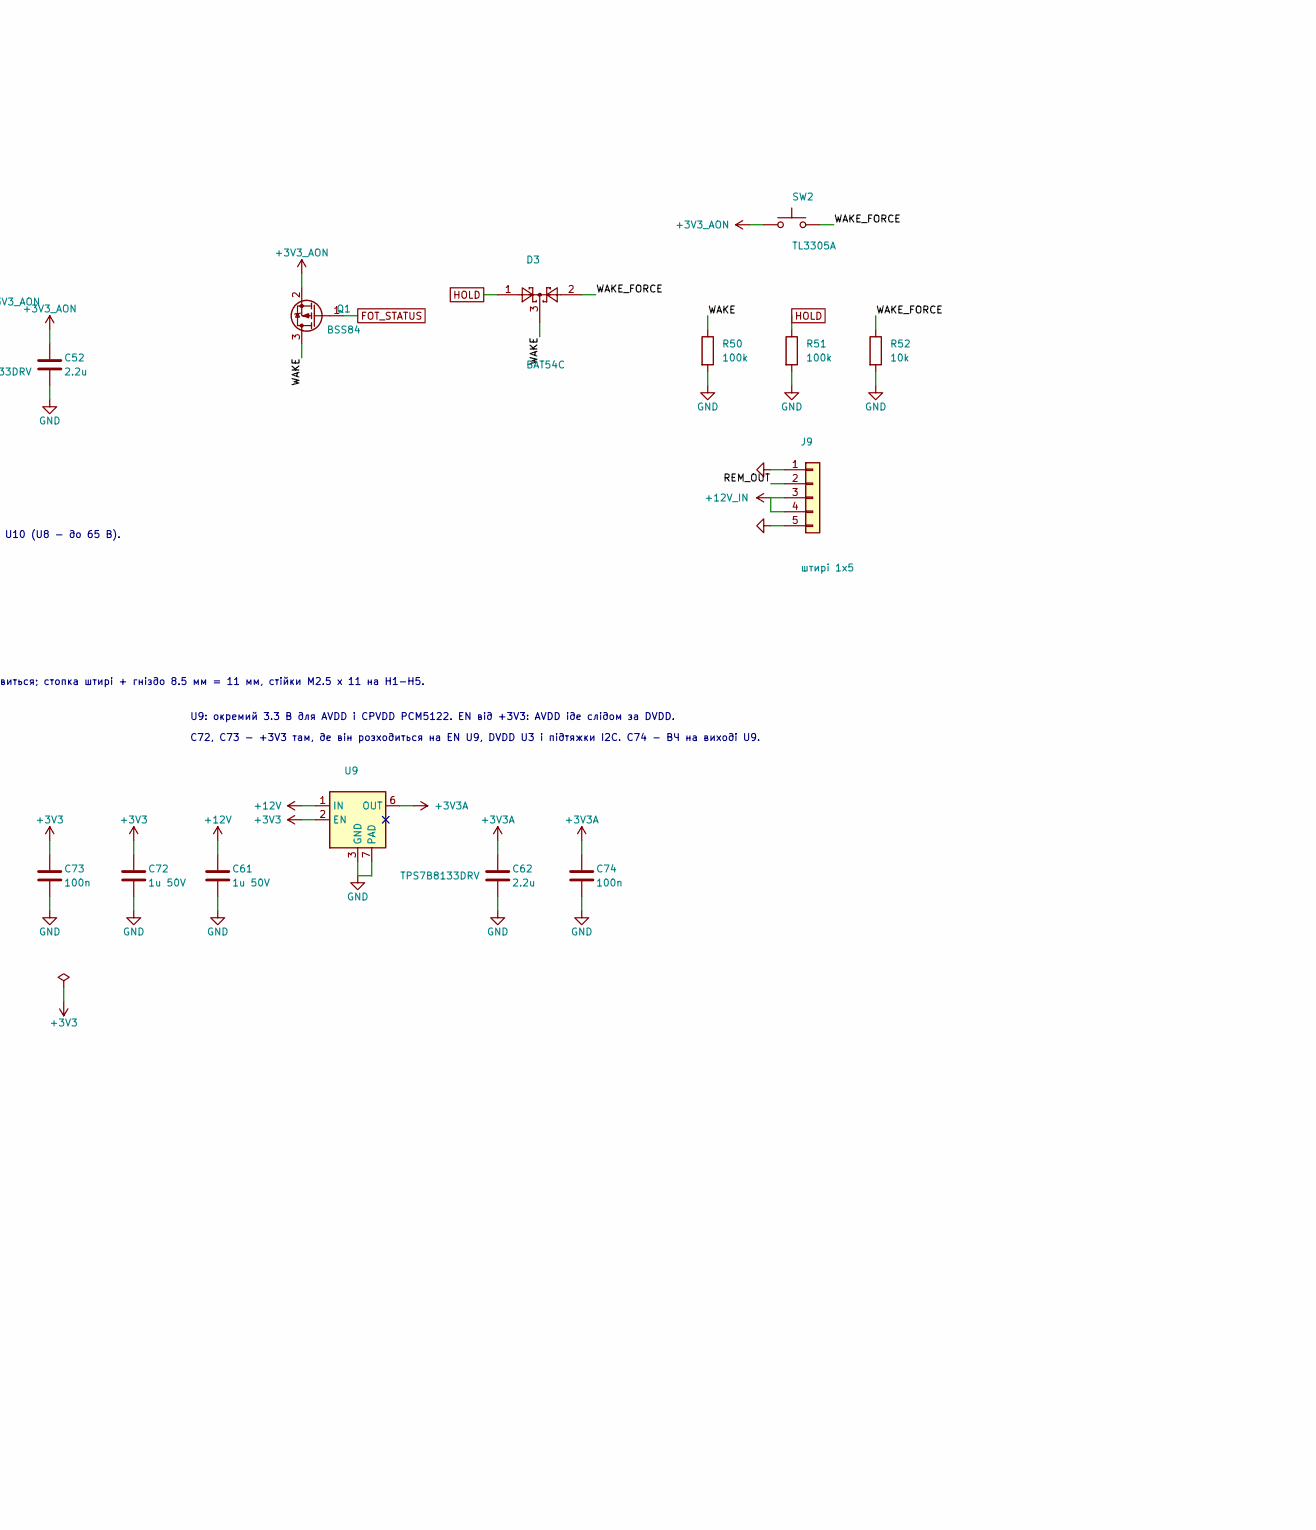
[picture p31: schematic power.kicad_sch, JLR-MOST-Amp: Живлення і REM, part in row 1, column 2]

Parts:
C50, C65: 47u 50V; CP_Elec_8x10
C51, C61, C72: 1u 50V; C_0805_2012Metric
C52, C62: 2.2u; C_0805_2012Metric
C53, C73, C74: 100n; C_0603_1608Metric
C54: 1u; C_0603_1608Metric
C55, C56: 10u 50V; C_1210_3225Metric
C57, C60, C63, C64, C75, C76, C77: 100n 50V; C_0603_1608Metric
C58, C59: 22u; C_1206_3216Metric
D1: SS34; D_SMA
D2: SM6T30A; D_SMB
D3: BAT54C; SOT-23
F1: 1.5A T; Fuse_1206_3216Metric
H2: M2.5; MountingHole_2.7mm_M2.5_Standoff_GND
J1: 43045-0421; Molex_Micro-Fit_3.0_43045-0421_2x02-1MP_P3.00mm_Horizontal
J9: штирі 1x5; PinHeader_1x05_P2.54mm_Vertical
L1: 10u NRSE6028-100M; L_Bourns-SRN6028
L2: 2.2u CKCSA4020-2.2uH/M; L_Coilcraft_XxL4030
Q1: BSS84; SOT-23
R50, R51: 100k; R_0603_1608Metric
R52, R59: 10k; R_0603_1608Metric
R57: 4.7k; R_0603_1608Metric
R58: 4.02k; R_0603_1608Metric
SW2: TL3305A; SW_SPST_TL3305A
U7, U9: TPS7B8133DRV; WSON-6-1EP_2x2mm_P0.65mm_EP1x1.6mm
U8: LM65625-Q1; TI_RZT0020A
U10: TPS1H200A-Q1; HVSSOP-8-1EP_3x3mm_P0.65mm_EP1.57x1.89mm

Connections:
+3V3: C58.1, C59.1, C72.1, C73.1, L2.2, R59.1, U8.20 (BIAS), U9.2 (EN); also elsewhere on the board
+3V3A: C62.1, C74.1, U9.6 (OUT); also elsewhere on the board
+3V3_AON: C52.1, Q1.2 (S), SW2.1, U7.6 (OUT); also elsewhere on the board
+12V: C50.1, C51.1, C55.1, C56.1, C57.1, C60.1, C61.1, C63.1, C65.1, C75.1, C76.1, L1.2, U7.1 (IN), U7.2 (EN), U8.11 (VIN1), U8.17 (VIN2), U9.1 (IN), U10.8 (VS)
+12V_IN: F1.1, J1.1, J9.3, J9.4
/Живлення і REM/+12V_D: D1.1 (K), D2.1 (K), L1.1
/Живлення і REM/+12V_F: C64.1, D1.2 (A), F1.2
/Живлення і REM/BUCK_BST: C53.1, U8.15 (BOOT)
/Живлення і REM/BUCK_SW: C53.2, L2.1, U8.13 (SW1), U8.14 (SW2)
/Живлення і REM/BUCK_VCC: C54.1, U8.4 (VCC), U8.5 (MODE/SYNC)
/Живлення і REM/REM_CL: R58.1, U10.4 (CL)
/Живлення і REM/REM_DELAY: R59.2, U10.5 (DELAY)
/Живлення і REM/REM_IN: R57.2, U10.1 (IN)
/Живлення і REM/REM_OUT: C77.1, J1.3, J9.2, U10.7 (OUT)
/Живлення і REM/WAKE: D3.3, Q1.3 (D), R50.1, U8.7 (EN/UVLO)
/Живлення і REM/WAKE_FORCE: D3.2, R52.1, SW2.2
FOT_STATUS: Q1.1 (G); also elsewhere on the board
GND: C50.2, C51.2, C52.2, C54.2, C55.2, C56.2, C57.2, C58.2, C59.2, C60.2, C61.2, C62.2, C63.2, C64.2, C65.2, C72.2, C73.2, C74.2, C75.2, C76.2, C77.2, D2.2 (A), H2.1, J1.2, J1.4, J9.1, J9.5, R50.2, R51.2, R52.2, R58.2, U7.3 (GND), U7.4 (GND), U7.7 (PAD), U8.3 (FB), U8.6 (RT), U8.9 (PGND1), U8.19 (PGND2), U8.21 (DAP), U9.3 (GND), U9.4 (GND), U9.7 (PAD), U10.2 (DIAG_EN), U10.6 (GND), U10.9 (EP); also elsewhere on the board
HOLD: D3.1, R51.1; also elsewhere on the board
REM_EN: R57.1; also elsewhere on the board

Notes on the sheet:
Живлення. +12 В постійні з роз'єму штатного підсилювача; F1 одразу за роз'ємом, за ним 100 нФ кераміки.
WAKE = світло (STATUS = 0 відкриває Q1) АБО HOLD від ESP32 АБО кнопка SW2 (WAKE_FORCE). Вмикає U8 (цифра); U9 (аналог) вмикається від його +3V3.
У сні живі U7, приймач FOT і логіка WAKE; споживання U8 і U9 у вимкненні ~1 мкА.
SW2: натиснути на столі без кільця - плата вмикається, далі живлення тримає HOLD. Прошивка через USB без кільця - тримати SW2. R52 тримає WAKE_FORCE у нулі.
J1: Micro-Fit 3.0 2x2 кутовий з лапками (43045-0421), фронтом у стінку з RCA і HDMI; штекер 43025-0400. 1 +12 В, 2 маса, 3 REM, 4 маса.
J9: штирі 1x5 2.54 на боці B над J1, стопкою в гніздо лампової плати: 1 маса, 2 REM_OUT (її REM_IN), 3 і 4 +12 В до F1 (1.2 А, пуск ниток до 2.9 А; лампова має свій F1 3 А), 5 маса. Без лампової плати не ставиться; стопка штирі + гніздо 8.5 мм = 11 мм, стійки M2.5 x 11 на H1-H5.
H2 - зв'язок маси з металевим корпусом у кута J1/J9 (J9.1 за 5.5 мм, J1 за 11 мм): різниця кузов - маса джгута не тече через звукову частину. Маса лампової - через J9, її кріпильні отвори не зв'язані.
C65 паралельно C50 (2 x 47 мкФ). C75, C76 - кераміка при C65 і C50: ВЧ, яку електроліти не беруть. D1: Шотткі, тримає заряд C50/C65 при просіданні під час пуску. D2: TVS 600 Вт, клемп ~33 В < 40 В U7, U9, U10 (U8 - до 65 В).
F1 1.5 А з затримкою: плата до ~0.3 А плюс REM до 0.5 А. Стоїть перед D2, тож тривалий пробій TVS розриває F1.
U8 LM65625-Q1 (SNVSCH2A): FB на GND - фіксовані 3.3 В, BIAS - вхід зворотного зв'язку з виходу; RT на GND - 2.2 МГц (1.98..2.42).
MODE на VCC - FPWM з DRSS +-5 %: частота не нижче 1.88 МГц, над AM. tON min 40 нс: при 16 В на 2.54 МГц треба 81 нс. Компенсація внутрішня.
L2: Isat вище межі струму U8 (4.9 А макс): CKCSA4020-2.2uH/M - 6.1 А при -30 %, 48 мОм, стає на майданчики XGL4030. C57 і C60 - кожен впритул до своєї пари VIN/PGND.
U9: окремий 3.3 В для AVDD і CPVDD PCM5122. EN від +3V3: AVDD іде слідом за DVDD.
C72, C73 - +3V3 там, де він розходиться на EN U9, DVDD U3 і підтяжки I2C. C74 - ВЧ на виході U9.
U10: REM, обмеження 0.5 А: R58 = 0.8 В * 2500 / 0.5 А = 4.0 кОм. DELAY підтягнуто: при замиканні - повторні спроби.
C77 при J9.2 і J1.3: ВЧ із кабелю REM одразу на масу. Вихід U10 наростає до 0.6 В/мкс, C77 бере до 60 мА - далеко до межі 0.5 А.

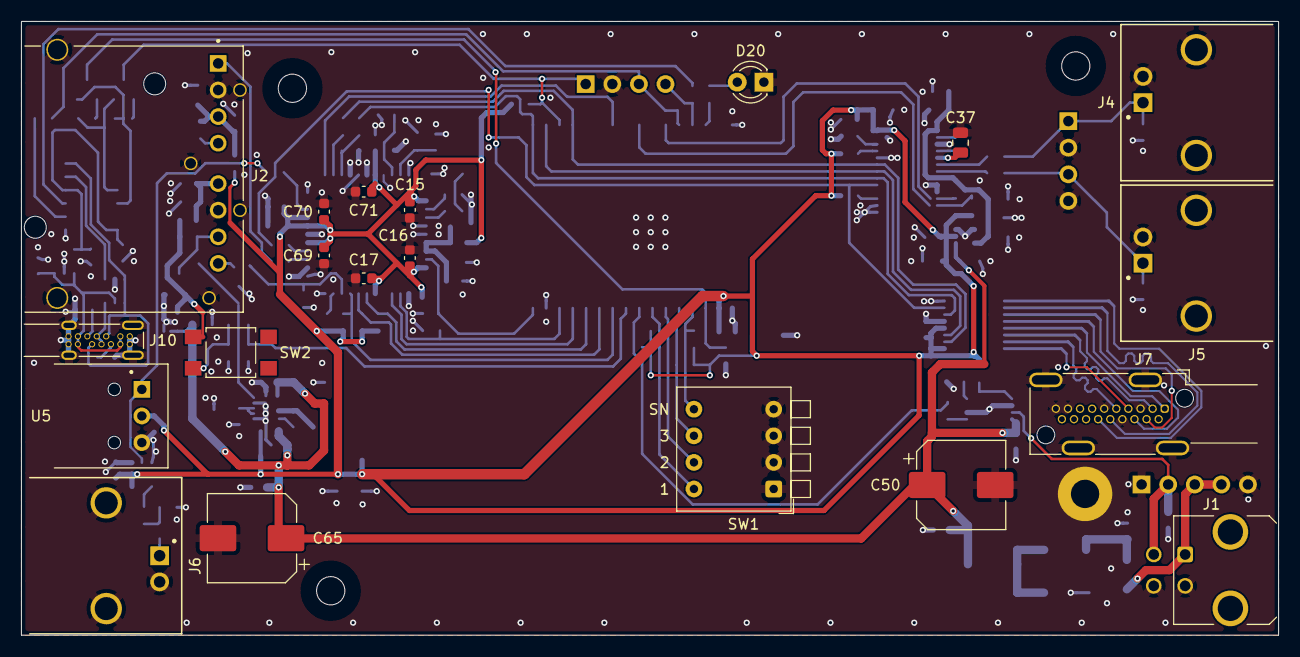
[picture p32: board jlr_most_amp.kicad_pcb from above]

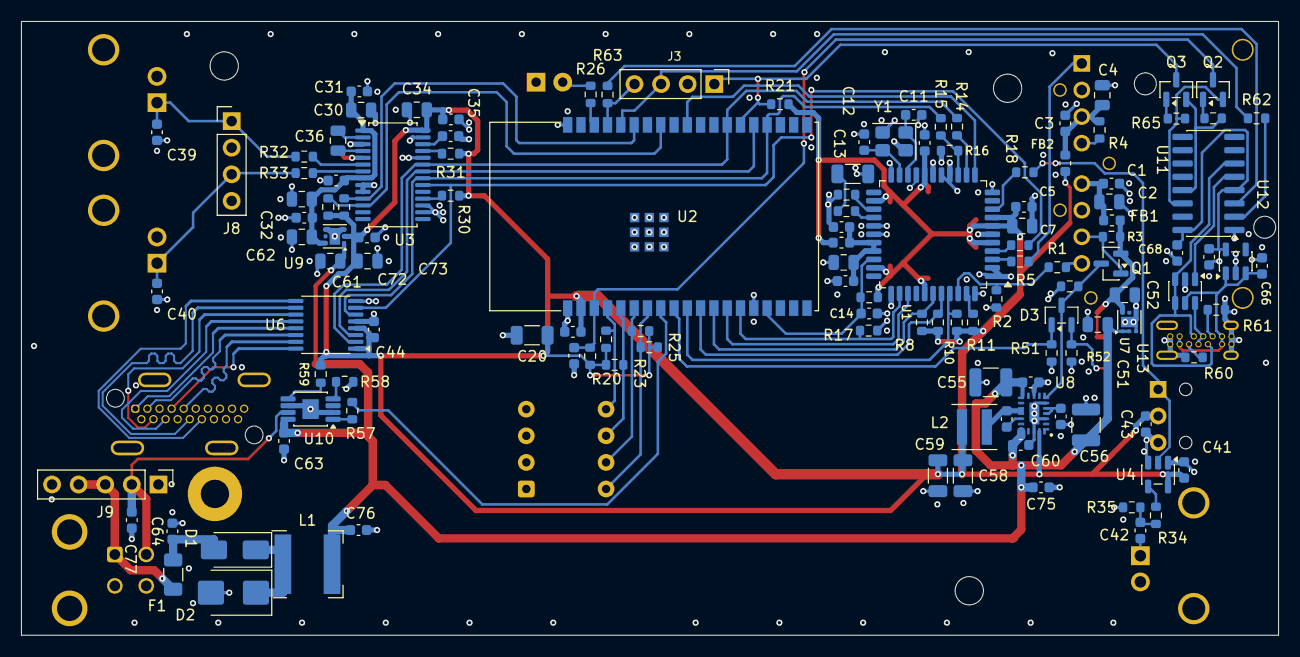
[picture p33: board jlr_most_amp.kicad_pcb from below]

Board: 4 copper layers, 120.1 x 58.6 mm, 151 parts (131 on the bottom side), 95 nets.

Other parts of the board:
H1, H3, H4: M2.5; MountingHole_2.7mm_M2.5_Standoff
