Oleg-mk/JLR-MOST-Amp/(commit log)

2026-10-14 Concept, stock amps and block diagram of the stock JLR amp imitator
    - docs/concept.md: the device takes the stock MOST25 amplifier's place,
    applies the head unit's sound commands to the digital stream without
    loss, mixes in a phone over Bluetooth or Wi-Fi, and outputs analog
    (PCM5122), I2S and S/PDIF (TOSLINK, coax) with a REM line. A mode reads
    and keeps the stock amp's serial number for cars with component
    protection.
    - docs/stock_amps.md: what the head unit sends the stock amplifiers and
    what they answer, from working products and the MOST specifications;
    sinks 1-4, component protection, open questions.
    - docs/block_diagram.md and block_diagram.svg: OS8104A, ESP32-WROVER-IE,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
2026-10-14 Schematic v0.1: ring, ESP32, outputs, power and REM
    hw/ is a KiCad 10 project, a root sheet with four sheets:
    - ring: the TE MOST 2+0 FOT header and OS8104A in I2C mode, the PLL
    filter, the crystal and the series terminations from DS8104AFP4;
    - host: ESP32-WROVER-IE with its I2S pins, the programming header,
    the DP-04 type switch and the hint LED;
    - outputs: PCM5122 to two RCA jacks, S/PDIF from the OS8104A's SX0 to
    TOSLINK (PLT133 at about 3.0 V) and to coax, and a buffered I2S header;
    - power: the input diode, TVS and filter, an always-on TPS7B8133 for
    the FOT receiver, WAKE from the receiver's STATUS or the host's HOLD,
    an AP64200Q buck at 2.1 MHz, an analog TPS7B8133 and the RE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
2026-10-14 Footprints for every part, and a check that pads match pins
    hw/jlr_most_amp.pretty holds the parts KiCad lacks:
    - TE_MOST_Pigtail_FOT_2+0 and Everlight_TOSLINK_T10 from
    JLR-MOST-Reader, BKL_0101153_RCA_RA from MOST25-to-AUDIO, each with
    its 3D model;
    - ESP32-WROVER-E from espressif/kicad-libraries (CC-BY-SA 4.0), which
    fits the WROVER-IE: same pins, same size.
    SW1 takes KiCad's 4-key piano DIP. hw/SOURCES.md lists where each
    footprint comes from and its licence.
    The schematic follows the footprints: the FOT header's shield is
    pin 0, and the RCA jacks get a three-pin symbol with the third pin free.
    Library symbols now carry their library footprint. gen/checkfp.py
    finds a footprint for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
2026-11-08 Bitline v0.1: firmware, boards, tube board, Bitline Lite
    Everything since the footprints of 14 October, published as one commit; the
    working history stays with the author.
    - fw/: ESP-IDF firmware: the stock amplifier's emulation (pre-facelift
    Hi-Line and Premium, AUD3), sound from the ring, processing, Bluetooth
    A2DP, AirPlay, source switching, profiles, the serial number read, Wi-Fi
    updates with rollback, sleep; QEMU scripts and PC tests.
    - hw/, hw4/: the main board on 2 and 4 layers with files for JLCPCB;
    hw/gen/lite.py makes Bitline Lite with its LCSC numbers.
    - tube/: the tube board for 6N28B-V and 6N16B-V.
    - docs/: concept, block diagram, stock amplifiers, firmware plan and log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
